rosalyntg/ultrasound/host/README.md

Standard test:
Water filled up to first line
Probed dipped to first seam, totally vertical
Highest Voltages
2MHz
26us ramp delay
76uS ramp rate
32k X scale
