rosalyntg/ultrasound/pcb/power-board/i_fb_R.png

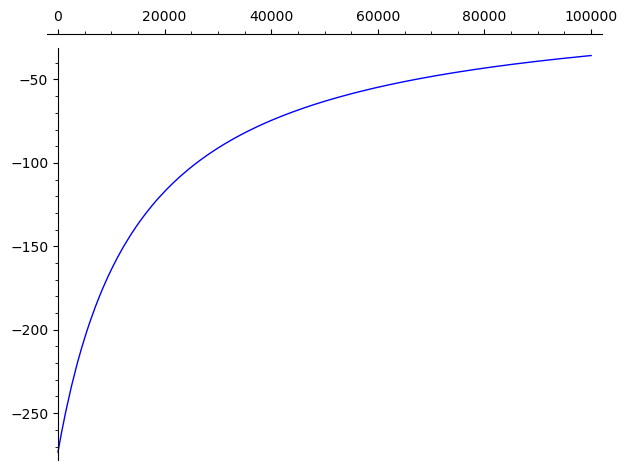
pcb/power-board/i_fb_R.png
