rosalyntg/ultrasound/pcb/power-board/R_V.png

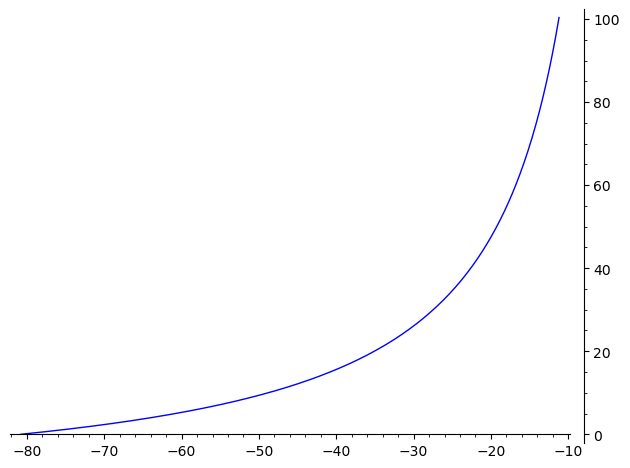
pcb/power-board/R_V.png
