rosalyntg/ultrasound/pcb/power-board/V_R.png

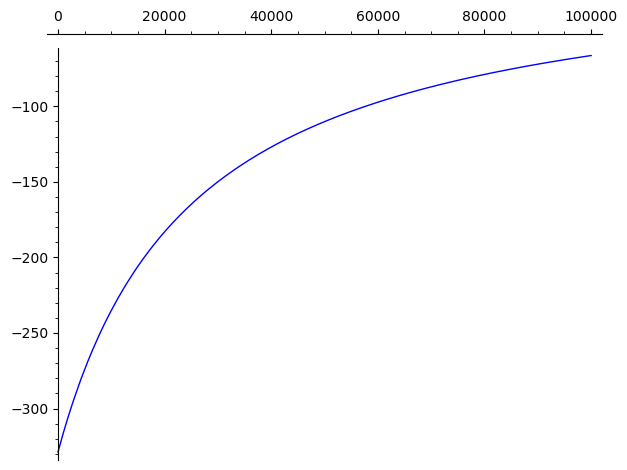
pcb/power-board/V_R.png
