rosalyntg/ultrasound/pcb/power-board/V_w_V.png

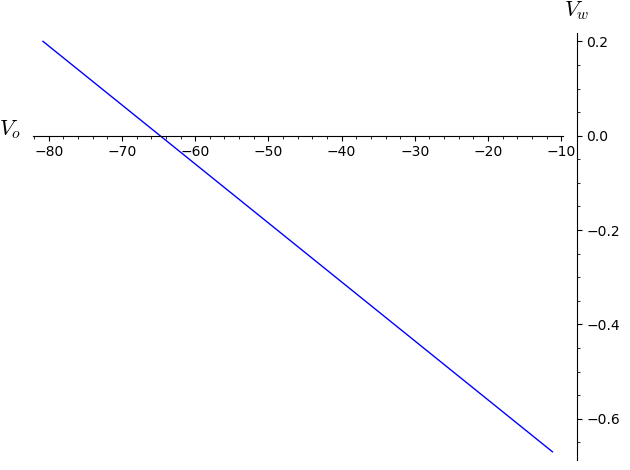
pcb/power-board/V_w_V.png
