rosalyntg/ultrasound/pcb/power-board/Vw_R.png

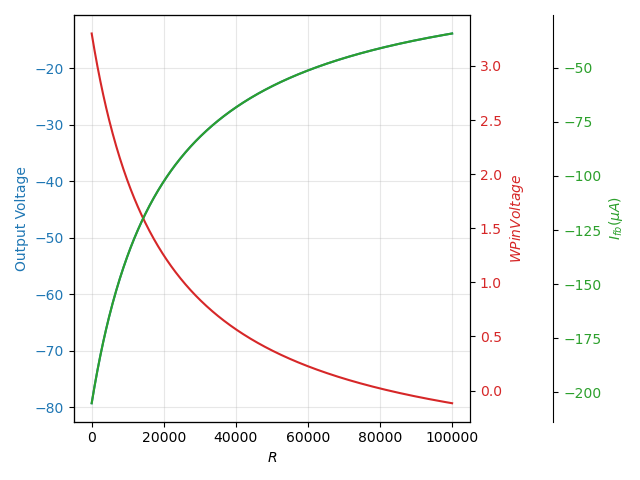
pcb/power-board/Vw_R.png
