rosalyntg/ultrasound/pcb/power-board/Vw_r_V.png

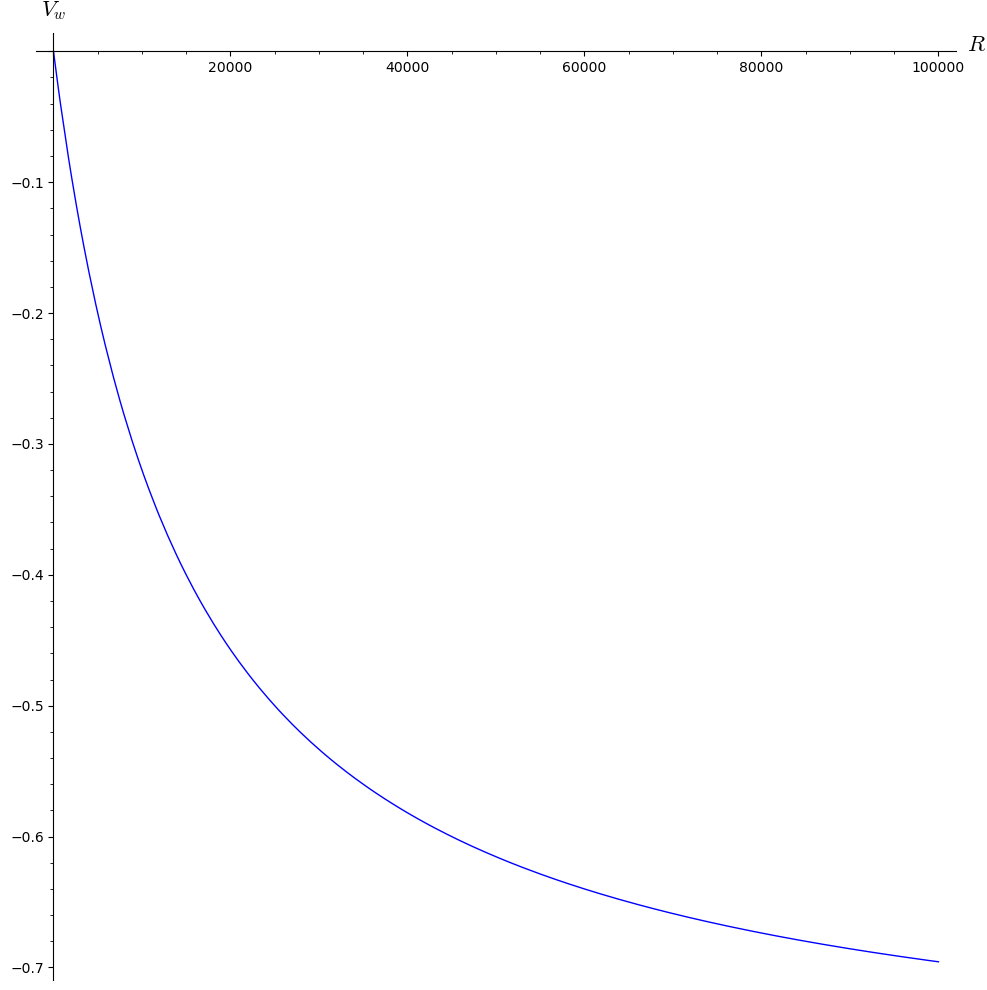
pcb/power-board/Vw_r_V.png
