rosalyntg/ultrasound/pcb/datasheets/ACAU15_IO_Length.xls

Sheet: BANK64
Name | Pin Number | Singals | Min Trace Delay (ps) | Max Trace Delay (ps) | Delay(mils) | Board Length(mils) | Total Length(mils)
B64_T0 | AF23 | IO_T0U_N12_VRP_64 | 132.268 | 133.597 | 768.3959538 | 756.36 | 1524.755954
B64_T1 | AF20 | IO_T1U_N12_64 | 127.425 | 128.706 | 740.2630058 | 790.53 | 1530.793006
B64_T2 | AE18 | IO_T2U_N12_64 | 125.588 | 126.851 | 729.5924855 | 799.54 | 1529.132486
B64_T3 | AC16 | IO_T3U_N12_64 | 130.105 | 131.413 | 755.8323699 | 784.52 | 1540.35237
B64_L1_N | AE26 | IO_L1N_T0L_N1_DBC_64 | 137.027 | 138.404 | 796.0433526 | 748.45 | 1544.493353
B64_L1_P | AE25 | IO_L1P_T0L_N0_DBC_64 | 136.67 | 138.043 | 793.9682081 | 751.07 | 1545.038208
B64_L2_N | AB26 | IO_L2N_T0L_N3_64 | 120.507 | 121.718 | 700.0722543 | 840.37 | 1540.442254
B64_L2_P | AB25 | IO_L2P_T0L_N2_64 | 119.317 | 120.516 | 693.1589595 | 846.16 | 1539.31896
B64_L3_N | AF25 | IO_L3N_T0L_N5_AD15N_64 | 142.349 | 143.78 | 826.9624277 | 707.62 | 1534.582428
B64_L3_P | AF24 | IO_L3P_T0L_N4_AD15P_64 | 141.029 | 142.447 | 819.2947977 | 715.01 | 1534.304798
B64_L4_N | AD26 | IO_L4N_T0U_N7_DBC_AD7N_64 | 119.021 | 120.217 | 691.4393064 | 844.96 | 1536.399306
B64_L4_P | AC26 | IO_L4P_T0U_N6_DBC_AD7P_64 | 118.754 | 119.947 | 689.8872832 | 847.56 | 1537.447283
B64_L5_N | AD25 | IO_L5N_T0U_N9_AD14N_64 | 137.596 | 138.979 | 799.349711 | 737.72 | 1537.069711
B64_L5_P | AD24 | IO_L5P_T0U_N8_AD14P_64 | 137.85 | 139.235 | 800.8236994 | 737.71 | 1538.533699
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
 |  | 64 | Y21 | IO_L19N_T3L_N1_DBC_AD9N_64 | 112.448 | 113.578 | 113.013 | 649.5
 |  | 64 | Y20 | IO_L19P_T3L_N0_DBC_AD9P_64 | 113.517 | 114.658 | 114.0875 | 655.6752874
 |  | 64 | AB19 | IO_L20N_T3L_N3_AD1N_64 | 103.937 | 104.982 | 104.4595 | 600.341954
 |  | 64 | AA19 | IO_L20P_T3L_N2_AD1P_64 | 104.717 | 105.77 | 105.2435 | 604.8477011
 |  | 64 | AB20 | IO_L21N_T3L_N5_AD8N_64 | 105.708 | 106.77 | 106.239 | 610.5689655
 |  | 64 | AA20 | IO_L21P_T3L_N4_AD8P_64 | 103.472 | 104.512 | 103.992 | 597.6551724
 |  | 64 | AC17 | IO_L22N_T3U_N7_DBC_AD0N_64 | 116.774 | 117.948 | 117.361 | 674.4885057
 |  | 64 | AB17 | IO_L22P_T3U_N6_DBC_AD0P_64 | 116.999 | 118.175 | 117.587 | 675.7873563
 |  | 64 | AA17 | IO_L23N_T3U_N9_64 | 113.33 | 114.469 | 113.8995 | 654.5948276
 |  | 64 | Y17 | IO_L23P_T3U_N8_64 | 112.781 | 113.914 | 113.3475 | 651.4224138
 |  | 64 | AA18 | IO_L24N_T3U_N11_64 | 113.426 | 114.566 | 113.996 | 655.1494253
 |  | 64 | Y18 | IO_L24P_T3U_N10_64 | 111.416 | 112.536 | 111.976 | 643.5402299

Sheet: BANK65
Name | Pin Number | Singals | Min Trace Delay (ps) | Max Trace Delay (ps) | Delay(mils) | Board Length(mils) | Total Length(mils)
B65_T0 | W21 | IO_T0U_N12_VRP_A28_65 | 88.856 | 89.749 | 516.199422 | 1434.17 | 1950.369422
B65_T1 | AA23 | IO_T1U_N12_SMBALERT_65 | 106.43 | 107.5 | 618.2947977 | 1346.07 | 1964.364798
B65_T2 | N26 | IO_T2U_N12_CSI_ADV_B_65 | 91.636 | 92.557 | 532.349711 | 1425.58 | 1957.929711
B65_T3 | T19 | IO_T3U_N12_PERSTN0_65 | 88.253 | 89.14 | 512.6965318 | 1430.24 | 1942.936532
B65_L1_N | V19 | IO_L1N_T0L_N1_DBC_RS1_65 | 80.282 | 81.089 | 466.3901734 | 1041.45 | 1507.840173
B65_L1_P | U19 | IO_L1P_T0L_N0_DBC_RS0_65 | 79.61 | 80.41 | 462.4855491 | 1045.3 | 1507.785549
B65_L2_N | U22 | IO_L2N_T0L_N3_FWE_FCS2_B_65 | 80.541 | 81.351 | 467.8959538 | 1040.59 | 1508.485954
B65_L2_P | U21 | IO_L2P_T0L_N2_FOE_B_65 | 67.937 | 68.62 | 394.6734104 | 1113.06 | 1507.73341
B65_L3_N | U20 | IO_L3N_T0L_N5_AD15N_A27_65 | 74.534 | 75.283 | 432.9971098 | 1072.6 | 1505.59711
B65_L3_P | T20 | IO_L3P_T0L_N4_AD15P_A26_65 | 76.164 | 76.93 | 442.4682081 | 1062.71 | 1505.178208
B65_L4_N | V22 | IO_L4N_T0U_N7_DBC_AD7N_A25_65 | 83.667 | 84.508 | 486.0549133 | 1022.67 | 1508.724913
B65_L4_P | V21 | IO_L4P_T0U_N6_DBC_AD7P_A24_65 | 83.747 | 84.589 | 486.5202312 | 1022.93 | 1509.450231
B65_L5_N | T23 | IO_L5N_T0U_N9_AD14N_A23_65 | 77.884 | 78.667 | 452.4595376 | 1039.52 | 1491.979538
B65_L5_P | T22 | IO_L5P_T0U_N8_AD14P_A22_65 | 74.703 | 75.454 | 433.9797688 | 1058.22 | 1492.199769
B65_L6_N | W20 | IO_L6N_T0U_N11_AD6N_A21_65 | 87.508 | 88.388 | 508.3699422 | 1004.87 | 1513.239942
B65_L6_P | W19 | IO_L6P_T0U_N10_AD6P_A20_65 | 94.153 | 95.099 | 546.9710983 | 965.02 | 1511.991098
B65_L7_N | Y23 | IO_L7N_T1L_N1_QBC_AD13N_A19_65 | 99.172 | 100.169 | 576.1300578 | 930.84 | 1506.970058
B65_L7_P | Y22 | IO_L7P_T1L_N0_QBC_AD13P_A18_65 | 98.734 | 99.726 | 573.583815 | 933.39 | 1506.973815
B65_L8_N | Y26 | IO_L8N_T1L_N3_AD5N_A17_65 | 109.053 | 110.149 | 633.5317919 | 878.43 | 1511.961792
B65_L8_P | Y25 | IO_L8P_T1L_N2_AD5P_A16_65 | 105.516 | 106.577 | 612.9855491 | 897.35 | 1510.335549
B65_L9_N | AA25 | IO_L9N_T1L_N5_AD12N_A15_D31_65 | 115.783 | 116.947 | 672.6300578 | 810.82 | 1483.450058
B65_L9_P | AA24 | IO_L9P_T1L_N4_AD12P_A14_D30_65 | 113.135 | 114.272 | 657.2456647 | 827.21 | 1484.455665
B65_L10_N | W26 | IO_L10N_T1U_N7_QBC_AD4N_A13_D29_65 | 106.483 | 107.553 | 618.6011561 | 887.68 | 1506.281156
B65_L10_P | W25 | IO_L10P_T1U_N6_QBC_AD4P_A12_D28_65 | 107.164 | 108.241 | 622.5578035 | 883.16 | 1505.717803
B65_L11_N | W23 | IO_L11N_T1U_N9_GC_A11_D27_65 | 94.681 | 95.633 | 550.0404624 | 963.94 | 1513.980462
B65_L11_P | V23 | IO_L11P_T1U_N8_GC_A10_D26_65 | 94.421 | 95.37 | 548.5289017 | 964.69 | 1513.218902
B65_L12_N | W24 | IO_L12N_T1U_N11_GC_A09_D25_65 | 94.602 | 95.553 | 549.5809249 | 925.6 | 1475.180925
B65_L12_P | V24 | IO_L12P_T1U_N10_GC_A08_D24_65 | 94.727 | 95.679 | 550.3063584 | 924.6 | 1474.906358
B65_L14_N | U25 | IO_L14N_T2L_N3_GC_A05_D21_65 | 91.56 | 92.481 | 531.9104046 | 978.07 | 1509.980405
B65_L14_P | T25 | IO_L14P_T2L_N2_GC_A04_D20_65 | 91.722 | 92.644 | 532.849711 | 975.56 | 1508.409711
B65_L15_N | P24 | IO_L15N_T2L_N5_AD11N_A03_D19_65 | 85.033 | 85.887 | 493.9884393 | 1011.97 | 1505.958439
B65_L15_P | N24 | IO_L15P_T2L_N4_AD11P_A02_D18_65 | 86.546 | 87.416 | 502.7803468 | 1002.77 | 1505.550347
B65_L16_N | V26 | IO_L16N_T2U_N7_QBC_AD3N_A01_D17_65 | 102.182 | 103.209 | 593.6156069 | 916.99 | 1510.605607
B65_L16_P | U26 | IO_L16P_T2U_N6_QBC_AD3P_A00_D16_65 | 102.642 | 103.674 | 596.2890173 | 913.53 | 1509.819017
B65_L17_N | P26 | IO_L17N_T2U_N9_AD10N_D15_65 | 99.311 | 100.309 | 576.9364162 | 931.94 | 1508.876416
B65_L17_P | P25 | IO_L17P_T2U_N8_AD10P_D14_65 | 89.003 | 89.897 | 517.0520231 | 990.99 | 1508.042023
B65_L18_N | R26 | IO_L18N_T2U_N11_AD2N_D13_65 | 93.035 | 93.97 | 540.4768786 | 967.74 | 1508.216879
B65_L18_P | R25 | IO_L18P_T2U_N10_AD2P_D12_65 | 87.173 | 88.049 | 506.4219653 | 1001.21 | 1507.631965
B65_L19_N | R23 | IO_L19N_T3L_N1_DBC_AD9N_D11_65 | 93.967 | 94.912 | 545.8930636 | 963.45 | 1509.343064
B65_L19_P | R22 | IO_L19P_T3L_N0_DBC_AD9P_D10_65 | 94.354 | 95.303 | 548.1416185 | 962.39 | 1510.531618
B65_L20_N | P21 | IO_L20N_T3L_N3_AD1N_D09_65 | 82.292 | 83.119 | 478.066474 | 1027.91 | 1505.976474
B65_L20_P | P20 | IO_L20P_T3L_N2_AD1P_D08_65 | 95.119 | 96.075 | 552.583815 | 955.44 | 1508.023815
B65_L21_N | R21 | IO_L21N_T3L_N5_AD8N_D07_65 | 104.393 | 105.442 | 606.4595376 | 901.61 | 1508.069538
B65_L21_P | R20 | IO_L21P_T3L_N4_AD8P_D06_65 | 105.605 | 106.666 | 613.5 | 894.14 | 1507.64
B65_L22_N | P23 | IO_L22N_T3U_N7_DBC_AD0N_D05_65 | 90.059 | 90.965 | 523.1907514 | 987.33 | 1510.520751
B65_L22_P | N23 | IO_L22P_T3U_N6_DBC_AD0P_D04_65 | 89.072 | 89.967 | 517.4537572 | 991.57 | 1509.023757
B65_L23_N | P19 | IO_L23N_T3U_N9_PERSTN1_I2C_SDA_65 | 96.032 | 96.998 | 557.8901734 | 948.43 | 1506.320173
B65_L23_P | N19 | IO_L23P_T3U_N8_I2C_SCLK_65 | 93.608 | 94.549 | 543.8063584 | 963.69 | 1507.496358
B65_L24_N | N22 | IO_L24N_T3U_N11_DOUT_CSO_B_65 | 86.917 | 87.79 | 504.933526 | 1009.59 | 1514.523526
B65_L24_P | N21 | IO_L24P_T3U_N10_EMCCLK_65 | 99.92 | 100.924 | 580.4739884 | 935.38 | 1515.853988

Sheet: BANK84_85_86
Name | Pin Number | Singals | Min Trace Delay (ps) | Max Trace Delay (ps) | Delay(mils) | Board Length(mils) | Total Length(mils)
B84_L1_N | AF15 | IO_L1N_AD11N_84 | 99.43 | 100.429 | 577.6271676 | 2034.93 | 2612.557168
B84_L1_P | AF14 | IO_L1P_AD11P_84 | 97.917 | 98.901 | 568.8381503 | 2043.19 | 2612.02815
B84_L2_N | AF13 | IO_L2N_AD10N_84 | 105.981 | 107.046 | 615.6849711 | 1991.07 | 2606.754971
B84_L2_P | AE13 | IO_L2P_AD10P_84 | 101.05 | 102.066 | 587.0404624 | 2019.44 | 2606.480462
B84_L3_N | AE15 | IO_L3N_AD9N_84 | 100.429 | 101.438 | 583.4306358 | 2028.87 | 2612.300636
B84_L3_P | AD15 | IO_L3P_AD9P_84 | 91.85 | 92.773 | 533.5924855 | 2078.15 | 2611.742486
B84_L4_N | AD14 | IO_L4N_AD8N_84 | 94.869 | 95.823 | 551.132948 | 2061.51 | 2612.642948
B84_L4_P | AD13 | IO_L4P_AD8P_84 | 94.385 | 95.334 | 548.3208092 | 2065.98 | 2614.300809
B84_L5_N | AC14 | IO_L5N_HDGC_AD7N_84 | 88.98 | 89.874 | 516.9190751 | 2104.23 | 2621.149075
B84_L5_P | AC13 | IO_L5P_HDGC_AD7P_84 | 88.546 | 89.436 | 514.3988439 | 2106.3 | 2620.698844
B84_L6_N | AB16 | IO_L6N_HDGC_AD6N_84 | 97.352 | 98.331 | 565.5578035 | 2040.74 | 2606.297803
B84_L6_P | AB15 | IO_L6P_HDGC_AD6P_84 | 96.84 | 97.813 | 562.5809249 | 2043.54 | 2606.120925
B84_L7_N | AA15 | IO_L7N_HDGC_AD5N_84 | 83.255 | 84.092 | 483.6618497 | 2119.76 | 2603.42185
B84_L7_P | Y15 | IO_L7P_HDGC_AD5P_84 | 83.14 | 83.975 | 482.9913295 | 2120.4 | 2603.391329
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
B86_L7_P | E13 | IO_L7P_HDGC_AD5P_86 | 96.638 | 97.61 | 561.4104046 | 1606.91 | 2168.320405
B86_L8_N | D13 | IO_L8N_HDGC_AD4N_86 | 94.613 | 95.564 | 549.6445087 | 1636.81 | 2186.454509
B86_L8_P | D14 | IO_L8P_HDGC_AD4P_86 | 95.02 | 95.975 | 552.0086705 | 1634.59 | 2186.598671
B86_L9_N | C13 | IO_L9N_AD3N_86 | 94.365 | 95.313 | 548.2023121 | 1649.26 | 2197.462312
B86_L9_P | C14 | IO_L9P_AD3P_86 | 90.241 | 91.148 | 524.2456647 | 1671.66 | 2195.905665
B86_L10_N | B12 | IO_L10N_AD2N_86 | 99.842 | 100.845 | 580.0202312 | 1604.49 | 2184.510231
B86_L10_P | C12 | IO_L10P_AD2P_86 | 96.366 | 97.335 | 559.8294798 | 1624.99 | 2184.81948
B86_L11_N | A12 | IO_L11N_AD1N_86 | 109.437 | 110.537 | 635.7630058 | 1552.11 | 2187.873006
B86_L11_P | A13 | IO_L11P_AD1P_86 | 106.494 | 107.564 | 618.6647399 | 1569.01 | 2187.67474
B86_L12_N | A14 | IO_L12N_AD0N_86 | 100.215 | 101.222 | 582.1878613 | 1613.93 | 2196.117861
B86_L12_P | B14 | IO_L12P_AD0P_86 | 97.426 | 98.405 | 565.9855491 | 1629.21 | 2195.195549

Sheet: BANK224_225_226
Name | Pin Number | Singals | Min Trace Delay (ps) | Max Trace Delay (ps) | Delay(mils) | Board Length(mils) | Total Length(mils)
224_CLK0_N | AB6 | MGTREFCLK0N_224 | 81.043 | 81.858 | 470.8121387 | 916.16 | 1386.972139
224_CLK0_P | AB7 | MGTREFCLK0P_224 | 81.06 | 81.874 | 470.9075145 | 917.14 | 1388.047514
 |  |  |  |  | 0
224_RX0_N | AF1 | MGTHRXN0_224 | 126.105 | 127.372 | 732.5924855 | 662.93 | 1395.522486
224_RX0_P | AF2 | MGTHRXP0_224 | 126.025 | 127.291 | 732.1271676 | 664.36 | 1396.487168
 |  |  |  |  | 0
224_RX1_N | AE3 | MGTHRXN1_224 | 112.482 | 113.612 | 653.4508671 | 715.29 | 1368.740867
224_RX1_P | AE4 | MGTHRXP1_224 | 112.402 | 113.532 | 652.9884393 | 717 | 1369.988439
 |  |  |  |  | 0
224_RX2_N | AD1 | MGTHRXN2_224 | 116.054 | 117.221 | 674.2052023 | 681.07 | 1355.275202
224_RX2_P | AD2 | MGTHRXP2_224 | 115.974 | 117.139 | 673.7369942 | 682.53 | 1356.266994
 |  |  |  |  | 0
224_RX3_N | AB1 | MGTHRXN3_224 | 107.847 | 108.931 | 626.5260116 | 660.34 | 1286.866012
224_RX3_P | AB2 | MGTHRXP3_224 | 107.766 | 108.85 | 626.0578035 | 661.82 | 1287.877803
 |  |  |  |  | 0
224_TX0_N | AF6 | MGTHTXN0_224 | 107.602 | 108.683 | 625.1011561 | 796.01 | 1421.111156
224_TX0_P | AF7 | MGTHTXP0_224 | 107.521 | 108.601 | 624.6300578 | 796.9 | 1421.530058
 |  |  |  |  | 0
224_TX1_N | AE8 | MGTHTXN1_224 | 89.649 | 90.55 | 520.8063584 | 854.4 | 1375.206358
224_TX1_P | AE9 | MGTHTXP1_224 | 89.703 | 90.605 | 521.1213873 | 855.34 | 1376.461387
 |  |  |  |  | 0
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
226_TX2_P | J5 | MGTHTXP2_226 | 62.951 | 63.584 | 365.7080925 | 666.72 | 1032.428092
 |  |  |  |  | 0 |  | 0
226_TX3_N | G4 | MGTHTXN3_226 | 65.718 | 66.378 | 381.7803468 | 549.36 | 931.1403468
226_TX3_P | G5 | MGTHTXP3_226 | 65.703 | 66.363 | 381.6936416 | 550.23 | 931.9236416
