rosalyntg/ultrasound/host/calibration.csv

# element calibration | one row per pulser channel (calibration.py)
# t0_s=1.499999e-06
# c_m_s=1482.0
# x_m | z_m | tau_s | sign
0.000000e+00 | 0.000000e+00 | 0.000000e+00 | 1
6.441796e-04 | 8.954894e-05 | 1.883347e-08 | -1
-1.057300e-03 | 2.165458e-04 | 2.088043e-07 | 1
-4.058558e-04 | 8.938831e-05 | 8.411684e-08 | -1
-1.989306e-03 | 2.548419e-04 | 3.007949e-07 | 1
-1.495747e-03 | 2.773587e-04 | 2.787233e-07 | -1
7.288245e-03 | -1.951969e-04 | -1.536409e-07 | 1
8.141255e-03 | 5.223752e-04 | 3.110836e-07 | -1
