rosalyntg/ultrasound/pcb/simulations/analog-frontend-nobalun.asc

&adc: fraprobe
&LNA: fraprobe
&vga: fraprobe
@1: fra; delay=10u fstart=10e3 fend=100e6 oct=3 pp0=10m pp1=10m f0=1 f1=1e9 tavgmin=10u tsettle=1u
C1: cap; 100n
C2: cap; 18n
C3: cap; 100n
C4: cap; 100n
C5: cap; 100n
C6: cap; 100n
C7: cap; 100n
C8: cap; 22p
C12: cap; 0.1µ
C13: cap; 0.1µ
C14: cap; 18p
R1: res; 50
R2: res; 280
R3: res; 8.25k
R4: res; 50
R5: res; 374
R7: res; 187
R8: res; 187
R11: res; 25
R12: res; 25
U1: AD8331LNA
U2: AD8331VGA
V1: voltage; SINE(0 100m 1e6); AC 1
V2: voltage; 5V
V3: voltage; PULSE(0 1 0 100u)
V4: voltage; 0.95
V5: voltage; 0.4
Named nets: 0, 5V, LOP, LON, IN, VOH, VOL, VIP, VIN, ADCP, ADCN, BINH, BINL, VO1H, VO1L
.ac dec 100 1 100e6
.tran 120u
.fra
