rosalyntg/ultrasound/pcb/simulations/analog-frontend.asc

&BALUN: fraprobe
&LNA: fraprobe
&vga: fraprobe
@1: fra; delay=10u fstart=10e3 fend=100e6 oct=3 pp0=.1m pp1=.1m f0=1 f1=1e9 tavgmin=10u tsettle=1u
C1: cap; 100n
C2: cap; 18n
C3: cap; 100n
C4: cap; 100n
C5: cap; 100n
C6: cap; 100n
C7: cap; 100n
C8: cap; 22p
C9: cap; 100n
C10: cap; 100n
C11: cap; 22p
L1: ind; 2µ; Rser=1m
L2: ind; 1µ; Rser=1m
L3: ind; 1µ; Rser=1m
L4: ind; 39µ; Rser=1m
L5: ind; 39µ; Rser=1m
R1: res; 50
R2: res; 280
R3: res; 8.25k
R4: res; 50
R5: res; 50
R6: res; 50
U1: AD8331LNA
U2: AD8331VGA
V1: voltage; SINE(0 100m 1e6); AC 1
V2: voltage; 5V
V3: voltage; PULSE(0 .7 0 100u)
V4: voltage; 0.95
V5: voltage; 1V
Named nets: 0, 5V, LOP, LON, IN, VOH, VOL, VIP, VIN, ADCP, ADCN
.ac dec 100 1 100e6
.tran .2m
K L1 L2 L3 0.99
.fra
