rosalyntg/ultrasound/pcb/simulations/gain-filter-current-dac.asc

C1: cap; 10n
C2: cap; 3n
C3: cap; 10n
M1: nmos; Si4542DY_N
M2: nmos; IPP08CN10L
M3: nmos; IPP08CN10L
R1: res; 2k
R2: res; 200
R4: res; 10
R5: res; 2k
U2: UniversalOpAmp5
V1: voltage; PULSE(0 1 0 1n 1n 2)
V2: voltage; PULSE(0 30 10u 1u 1u 10u 50u 10)
V3: voltage; 0V
V4: voltage; 3.3
Named nets: 0, OUT, GATE, DRAIN, OP+, OPIN-, OPIN+
.tran 220u
.lib opamp.sub
.ic V(OUT)=0
