rosalyntg/ultrasound/pcb/simulations/gain-filter.asc

C1: cap; 20n
C2: cap; 1n
C3: cap; 1n
C4: cap; 1n
C5: cap; 1n
R2: res; 220
R81: res; 440
V1: voltage; PWL file=gain-filter-input-waveform.pwl; AC 3.3
Named nets: 0, GAIN, GAIN_DAC
.ac dec 50 1 1Meg
.tran 120u
.lib library/DAC7311_PAR.lib
