rosalyntg/ultrasound/pcb/simulations/gain-ramp-summing.asc

C1: cap; 3n
C2: cap; 4n
D1: diode; 1N914
D2: diode; 1N914
D3: diode; 1N914
M1: nmos; BS170
R1: res; 10k
R2: res; 200
R: res; 470
U2: MAX74822
V1: voltage; 1.25
V2: voltage; PULSE(3.3 0 5u 100n 100n 50u 100u 100)
V3: voltage; 3.3
Named nets: 0, GAIN, INT, GATE, AMP+
.tran 200u
.lib opamp.sub
.ic V(GAIN)=0 V(INT)=0
