rosalyntg/ultrasound/pcb/simulations/hv.asc

C1: cap; 200n
C2: cap; 1nF
C3: cap; 1µ
C4: cap; 100n
C5: cap; 220n
C6: cap; 200n
C7: cap; 10µ
C8: cap; 10µ
D1: schottky; DI_DFLS1150
D2: schottky; DI_DFLS1150
D3: schottky; DI_DFLS1150
L1: ind; 10µ; Rser=1m
M1: nmos; BSB012N03LX3
R1: res; 107k
R2: res; 85.4k
R3: res; 20
R4: res; 680k
R5: res; 15k
R6: res; 50
R7: res; 1k
U1: LT8365
V1: voltage; 12
V2: voltage; PULSE(0V 50V 40m 0 0 3u 100u 10000)
Named nets: 0, HV, FBX, VIN, SW, D2CAT
.inc library/DFLS1150.spice.txt
.tran 200m
.ic V(HV)=80
