rosalyntg/ultrasound/pcb/simulations/led-drive-fet.asc

D2: LED; LTST-C171KRKT
M1: nmos; BS170
R1: res; 68
V1: voltage; 3.3
Named nets: 0
.tran 1m
.lib led_sim/LTST-C171KRKT.lib
