rosalyntg/ultrasound/pcb/probe/probe.kicad_pcb

## KiCad design pcb/probe/probe.kicad_pcb (2026-09-27)

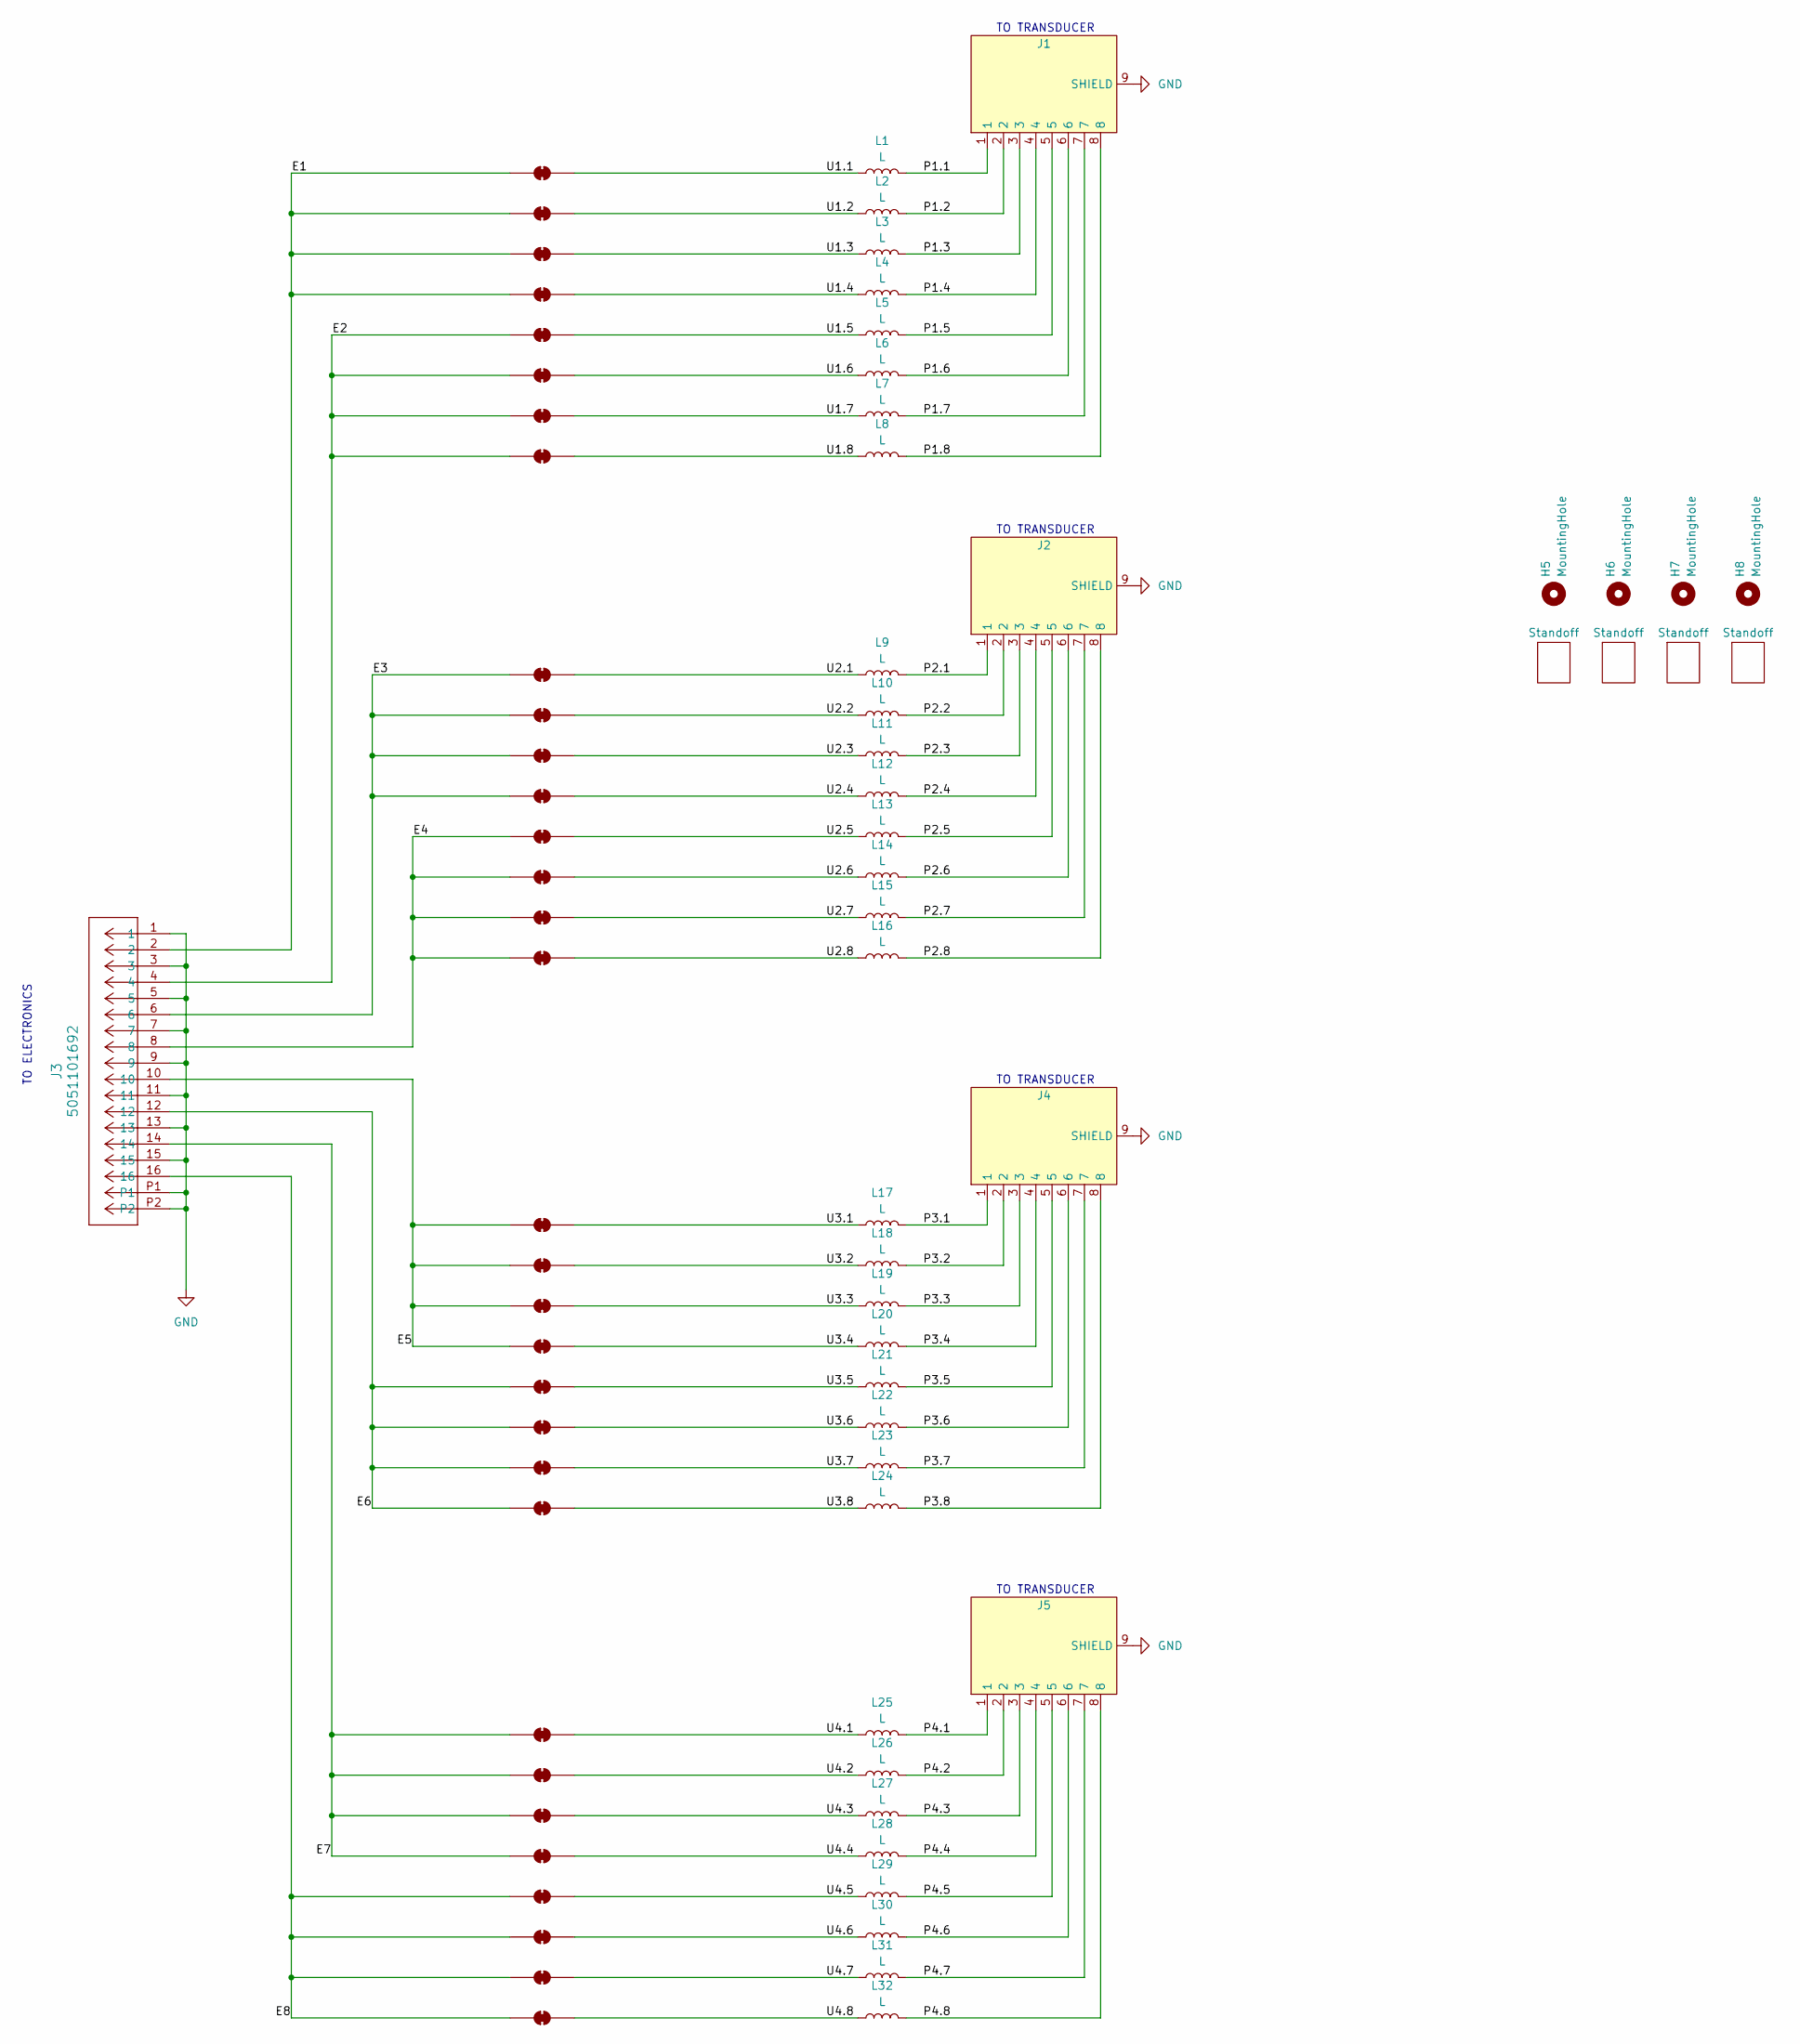
[picture p10: schematic probe.kicad_sch, Probe Breakout]

Parts:
H5, H6, H7, H8: MountingHole; MountingHole_3.2mm_M3
J1, J2, J4, J5: UCOAX
J3: 5051101692; CON_5051101692_MOL; Manufacturer Part Number 5051101692; Digikey Part Number WM12372CT-ND
JP2, JP3, JP4, JP5, JP6, JP7, JP8, JP9, JP10, JP11, JP12, JP13, JP14, JP15, JP16, JP17, JP18, JP19, JP20, JP21, JP22, JP23, JP24, JP25, JP26, JP27, JP28, JP29, JP30, JP31, JP32, JP33: SolderJumper_2_Bridged; SolderJumper-2_P1.3mm_Bridged_RoundedPad1.0x1.5mm
L1, L2, L3, L4, L5, L6, L7, L8, L9, L10, L11, L12, L13, L14, L15, L16, L17, L18, L19, L20, L21, L22, L23, L24, L25, L26, L27, L28, L29, L30, L31, L32: L; PROBE_INDUCTOR
Z8, Z9, Z10, Z11: Standoff; Manufacturer_Part_Number 24438; DigiKey Part Number 36-24438-ND

Connections:
/E1: J3.2, JP2.1 (A), JP3.1 (A), JP4.1 (A), JP5.1 (A)
/E2: J3.4, JP6.1 (A), JP7.1 (A), JP8.1 (A), JP9.1 (A)
/E3: J3.6, JP10.1 (A), JP11.1 (A), JP12.1 (A), JP13.1 (A)
/E4: J3.8, JP14.1 (A), JP15.1 (A), JP16.1 (A), JP17.1 (A)
/E5: J3.10, JP18.1 (A), JP19.1 (A), JP20.1 (A), JP21.1 (A)
/E6: J3.12, JP22.1 (A), JP23.1 (A), JP24.1 (A), JP25.1 (A)
/E7: J3.14, JP26.1 (A), JP27.1 (A), JP28.1 (A), JP29.1 (A)
/E8: J3.16, JP30.1 (A), JP31.1 (A), JP32.1 (A), JP33.1 (A)
/P1.1: J1.1, L1.2
/P1.2: J1.2, L2.2
/P1.3: J1.3, L3.2
/P1.4: J1.4, L4.2
/P1.5: J1.5, L5.2
/P1.6: J1.6, L6.2
/P1.7: J1.7, L7.2
/P1.8: J1.8, L8.2
/P2.1: J2.1, L9.2
/P2.2: J2.2, L10.2
/P2.3: J2.3, L11.2
/P2.4: J2.4, L12.2
/P2.5: J2.5, L13.2
/P2.6: J2.6, L14.2
/P2.7: J2.7, L15.2
/P2.8: J2.8, L16.2
/P3.1: J4.1, L17.2
/P3.2: J4.2, L18.2
/P3.3: J4.3, L19.2
/P3.4: J4.4, L20.2
/P3.5: J4.5, L21.2
/P3.6: J4.6, L22.2
/P3.7: J4.7, L23.2
/P3.8: J4.8, L24.2
/P4.1: J5.1, L25.2
/P4.2: J5.2, L26.2
/P4.3: J5.3, L27.2
/P4.4: J5.4, L28.2
/P4.5: J5.5, L29.2
/P4.6: J5.6, L30.2
/P4.7: J5.7, L31.2
/P4.8: J5.8, L32.2
/U1.1: JP2.2 (B), L1.1
/U1.2: JP3.2 (B), L2.1
/U1.3: JP4.2 (B), L3.1
/U1.4: JP5.2 (B), L4.1
/U1.5: JP6.2 (B), L5.1
/U1.6: JP7.2 (B), L6.1
/U1.7: JP8.2 (B), L7.1
/U1.8: JP9.2 (B), L8.1
/U2.1: JP10.2 (B), L9.1
/U2.2: JP11.2 (B), L10.1
/U2.3: JP12.2 (B), L11.1
/U2.4: JP13.2 (B), L12.1
/U2.5: JP14.2 (B), L13.1
/U2.6: JP15.2 (B), L14.1
/U2.7: JP16.2 (B), L15.1
/U2.8: JP17.2 (B), L16.1
/U3.1: JP18.2 (B), L17.1
/U3.2: JP19.2 (B), L18.1
/U3.3: JP20.2 (B), L19.1
/U3.4: JP21.2 (B), L20.1
/U3.5: JP22.2 (B), L21.1
/U3.6: JP23.2 (B), L22.1
/U3.7: JP24.2 (B), L23.1
/U3.8: JP25.2 (B), L24.1
/U4.1: JP26.2 (B), L25.1
/U4.2: JP27.2 (B), L26.1
/U4.3: JP28.2 (B), L27.1
/U4.4: JP29.2 (B), L28.1
/U4.5: JP30.2 (B), L29.1
/U4.6: JP31.2 (B), L30.1
/U4.7: JP32.2 (B), L31.1
/U4.8: JP33.2 (B), L32.1
GND: J1.9 (SHIELD), J2.9 (SHIELD), J3.1, J3.3, J3.5, J3.7, J3.9, J3.11, J3.13, J3.15, J3.P1, J3.P2, J4.9 (SHIELD), J5.9 (SHIELD)

Notes on the sheet:
TO ELECTRONICS
TO TRANSDUCER

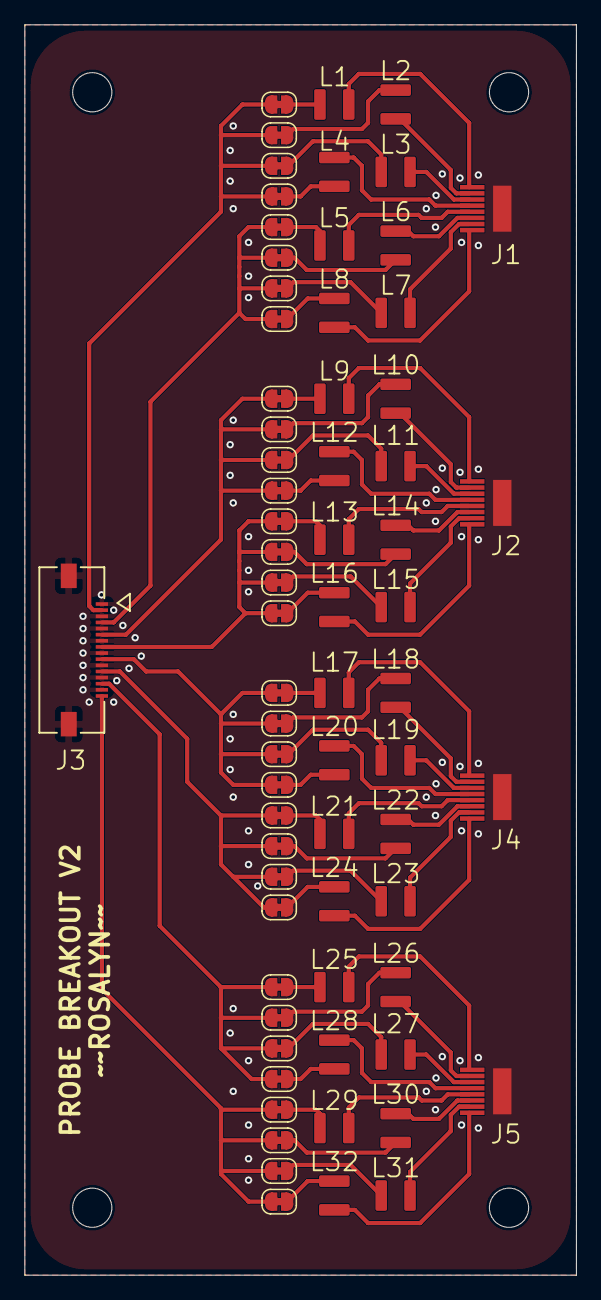
[picture p11: board probe.kicad_pcb from above]

Board: 2 copper layers, 45.0 x 102.0 mm, 73 parts (0 on the bottom side), 73 nets.
