rosalyntg/ultrasound/pcb/power-board/power-board.kicad_pcb

## KiCad design pcb/power-board/power-board.kicad_pcb (2026-09-27)

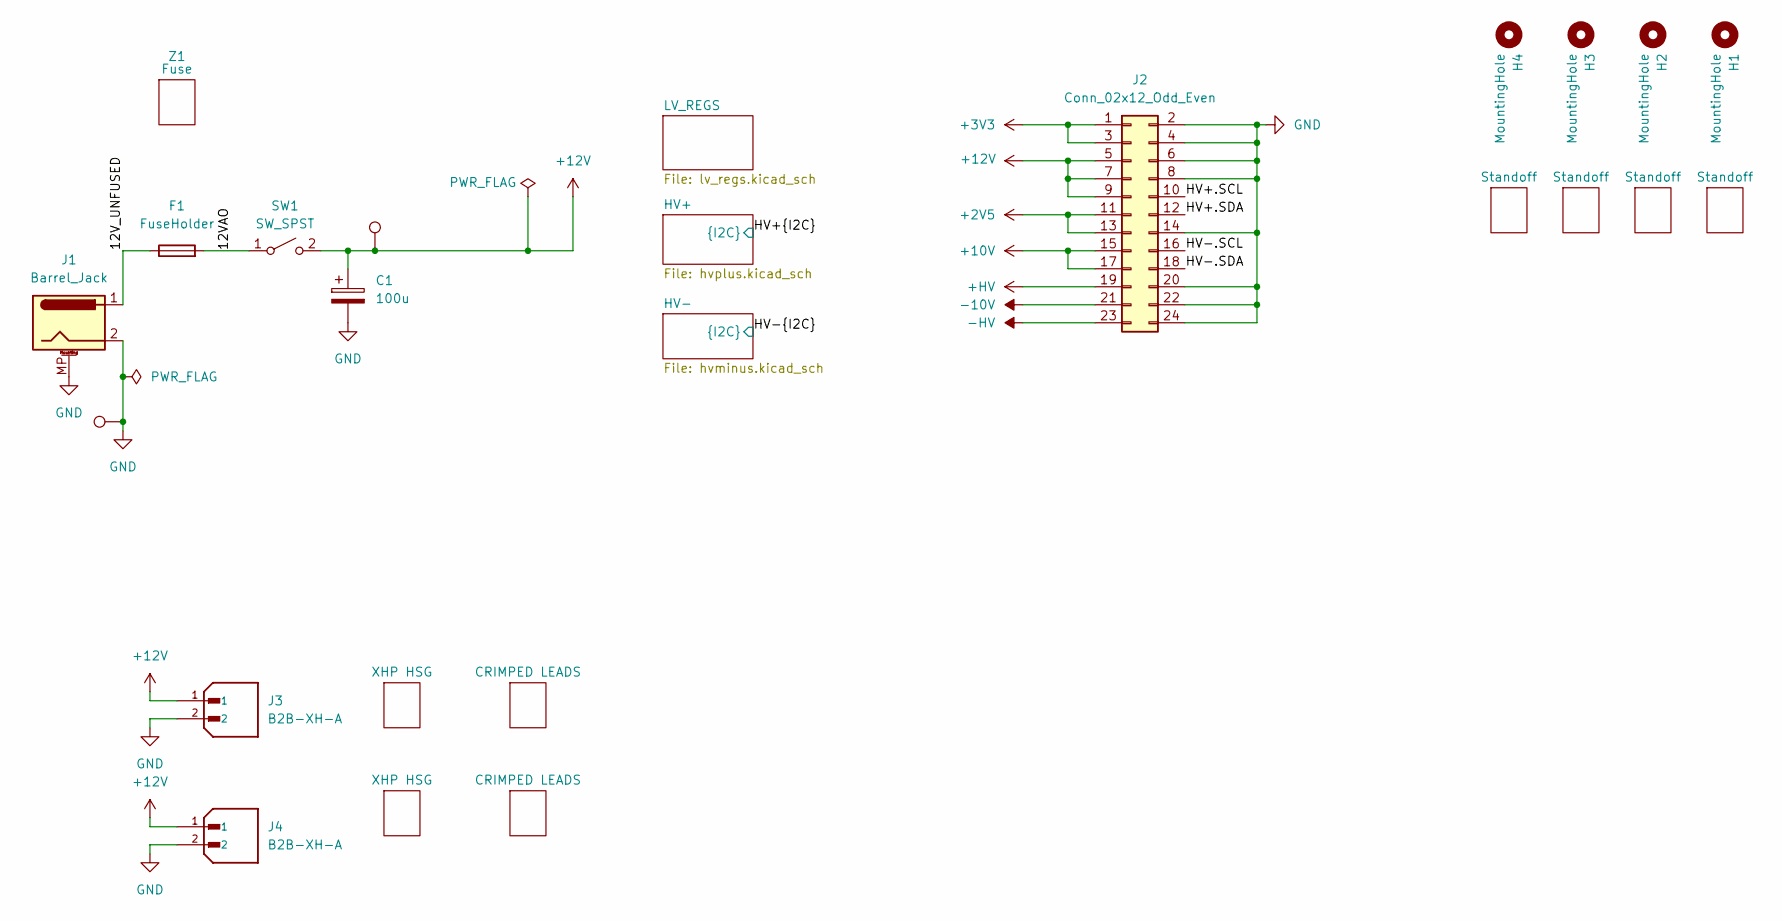
[picture p12: schematic power-board.kicad_sch, Ultrasound Power]

Parts:
C1: 100u; CP_Radial_D5.0mm_P2.00mm; Voltage Rating 16V; Manufacturer_Part_Number 860010372006; DigiKey Part Number 732-8598-3-ND
F1: FuseHolder; Fuseholder_Blade_Mini_Keystone_3568; Manufacturer_Part_Number 3568; DigiKey Part Number 36-3568-ND
H1, H2, H3, H4: MountingHole; MountingHole_3.2mm_M3
J1: Barrel_Jack; BarrelJack_CUI_PJ-063AH_Horizontal; Manufacturer_Part_Number PJ-063AH; DigiKey Part Number CP-063AH-ND
J2: Conn_02x12_Odd_Even; PinSocket_2x12_P2.54mm_Horizontal; Manufacturer_Part_Number PPPC122LJBN-RC; DigiKey Part Number S5565-ND
J3, J4: B2B-XH-A; JST_XH_B2B-XH-AM_1x02_P2.50mm_Vertical; Manufacturer_Part_Number B2B-XH-A; DigiKey Part Number 455-B2B-XH-A-ND
SW1: SW_SPST; CK_L101011; Manufacturer_Part_Number L101011MS02Q; DigiKey Part Number CKC5106-ND
TP1, TP2: TestPoint; TestPoint_THTPad_2.5x2.5mm_Drill1.2mm
Z1: Fuse; Manufacturer_Part_Number 0297005.WXNV; DigiKey Part Number F989-ND
Z8, Z9, Z10, Z11: Standoff; Manufacturer_Part_Number 24438; DigiKey Part Number 36-24438-ND
Z12, Z13: XHP HSG; Manufacturer_Part_Number XHP-2; DigiKey Part Number 455-2266-ND
Z14, Z15: CRIMPED LEADS; Manufacturer_Part_Number ASXHSXH22K305; DigiKey Part Number 455-3241-ND

Connections:
+2V5: J2.11, J2.13; also elsewhere on the board
+3V3: J2.1, J2.3; also elsewhere on the board
+10V: J2.15, J2.17; also elsewhere on the board
+12V: C1.1, J2.5, J2.7, J2.9, J3.1, J4.1, SW1.2 (B), TP2.1 (1_1); also elsewhere on the board
+HV: J2.19; also elsewhere on the board
-10V: J2.21; also elsewhere on the board
-HV: J2.23; also elsewhere on the board
/12VAO: F1.2, SW1.1 (A)
/12V_UNFUSED: F1.1, J1.1
/HV+.SCL: J2.10; also elsewhere on the board
/HV+.SDA: J2.12; also elsewhere on the board
/HV-.SCL: J2.16; also elsewhere on the board
/HV-.SDA: J2.18; also elsewhere on the board
GND: C1.2, J1.2, J1.MP (MountPin_MP), J2.2, J2.4, J2.6, J2.8, J2.14, J2.20, J2.22, J2.24, J3.2, J4.2, TP1.1 (1_1); also elsewhere on the board

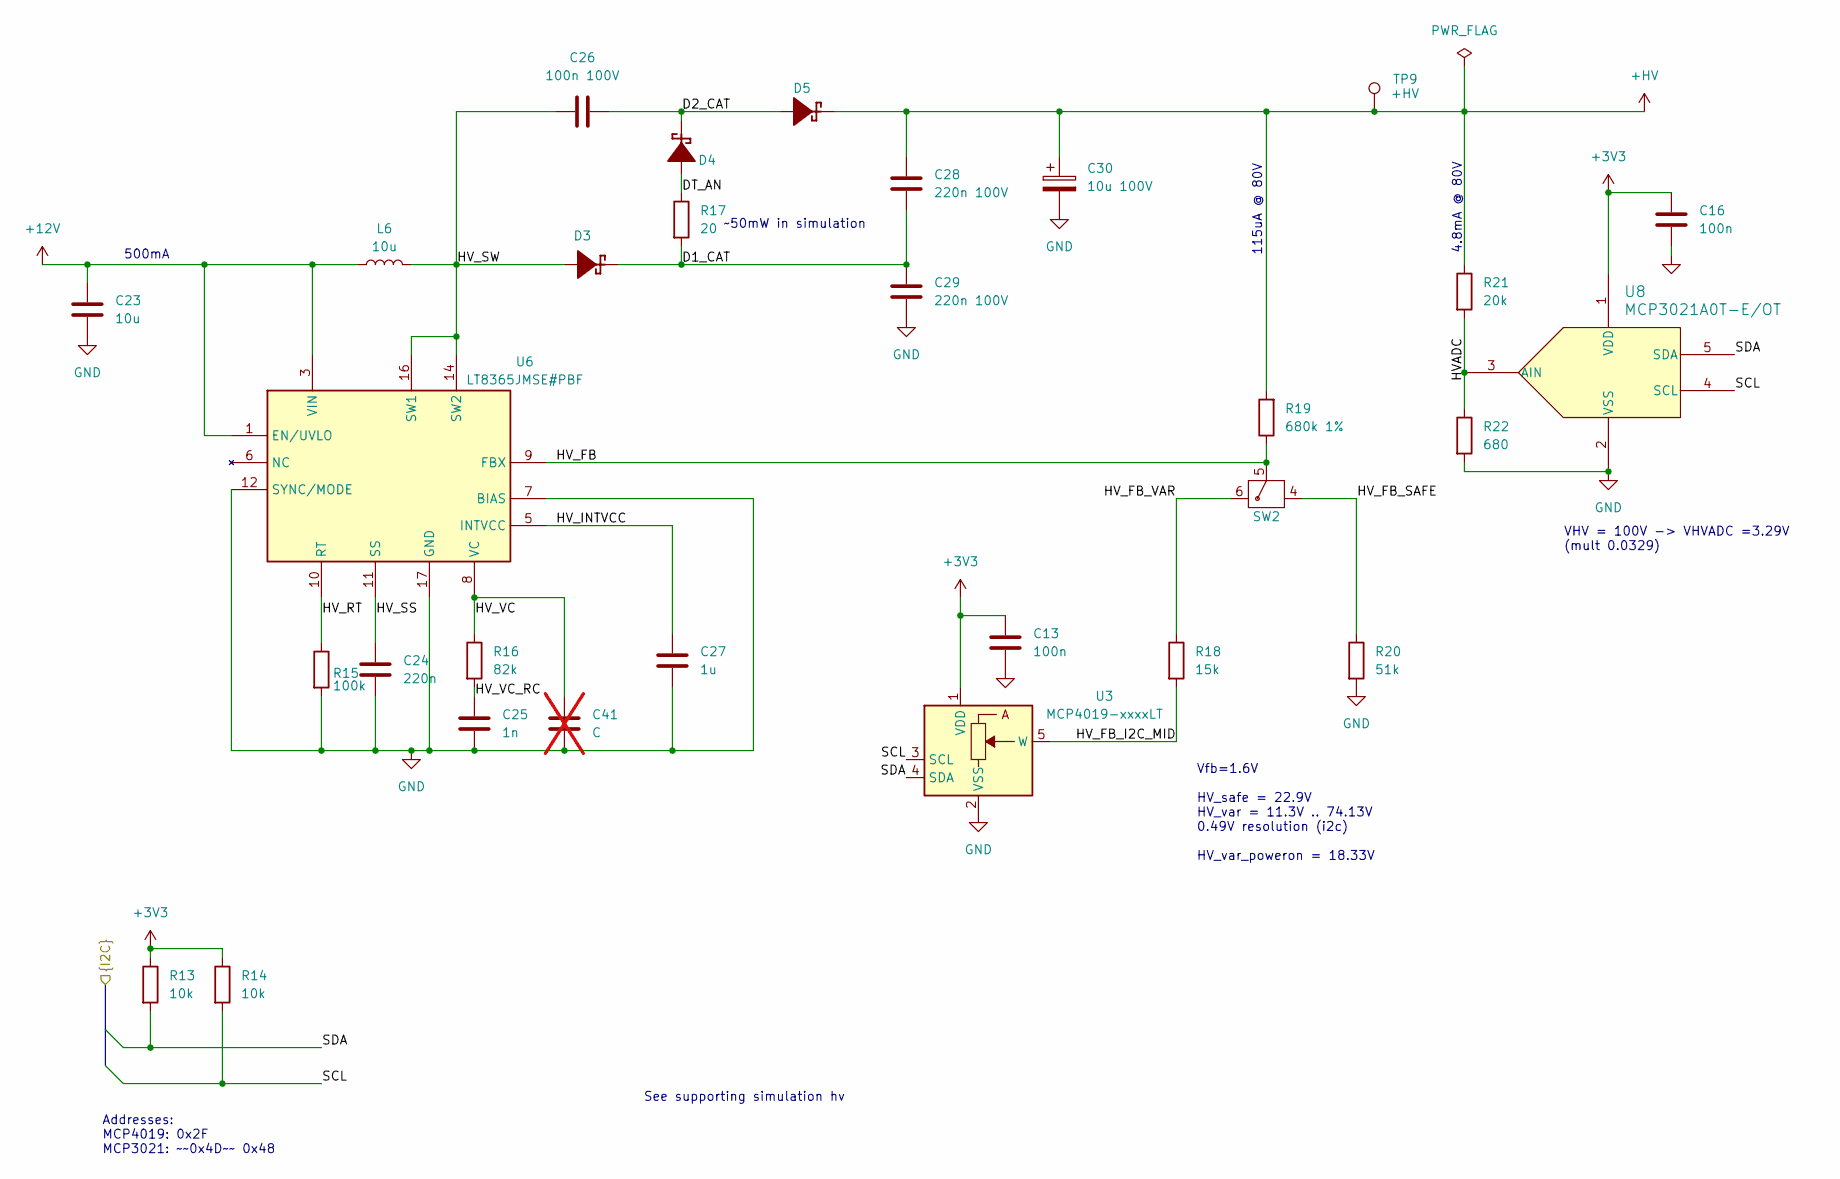
[picture p13: schematic hvplus.kicad_sch, Noninverting Positive Pulse Supply]

Parts:
C13, C16: 100n; C_0805_2012Metric_Pad1.18x1.45mm_HandSolder; Voltage Rating 25V; Manufacturer_Part_Number GCM21BR71E104KA37L; DigiKey Part Number 490-14779-1-ND
C23: 10u; C_0805_2012Metric_Pad1.18x1.45mm_HandSolder; Voltage Rating 25V; Manufacturer_Part_Number GRM21BR61E106KA73K; DigiKey Part Number 490-16824-2-ND
C24: 220n; C_0805_2012Metric_Pad1.18x1.45mm_HandSolder; Voltage Rating 25V; Manufacturer_Part_Number GRM219R71E224KA01D; DigiKey Part Number 490-1675-2-ND
C25: 1n; C_0805_2012Metric_Pad1.18x1.45mm_HandSolder; Voltage Rating 50V; Manufacturer_Part_Number GRM216R71H102KA01D
C26: 100n 100V; C_0805_2012Metric_Pad1.18x1.45mm_HandSolder; Voltage Rating 100V; Manufacturer_Part_Number GCM21BR72A104KA37L; DigiKey Part Number 490-4789-1-ND
C27: 1u; C_0805_2012Metric_Pad1.18x1.45mm_HandSolder; Voltage Rating 10V; Manufacturer_Part_Number GRM21BR71A105KA01L
C28, C29: 220n 100V; C_1210_3225Metric_Pad1.33x2.70mm_HandSolder; Voltage Rating 200V; Manufacturer_Part_Number GRM32DR72D224KW01L; DigiKey Part Number 490-13380-1-ND
C30: 10u 100V; CP_Radial_D10.0mm_P5.00mm; Voltage Rating 200V; Manufacturer_Part_Number ECA-2DHG100; DigiKey Part Number P19449-ND
C41: C; C_0805_2012Metric_Pad1.18x1.45mm_HandSolder; not fitted
D3, D4, D5: SMD1150PL-TP; SMD1150PL; Voltage Rating 150V; Mouser Part Number 621-DFLS1150-7
L6: 10u; WURTH_WE-LHMI-4.45mm; Mouser Part Number 710-74437324100
R13, R14: 10k; R_0805_2012Metric_Pad1.20x1.40mm_HandSolder; Manufacturer_Part_Number RC0805JR-0710K
R15: 100k; R_0805_2012Metric_Pad1.20x1.40mm_HandSolder; Manufacturer_Part_Number RC0805JR-07100R; DigiKey Part Number 311-107KCRCT-ND
R16: 82k; R_0805_2012Metric_Pad1.20x1.40mm_HandSolder; Manufacturer_Part_Number RC0805JR-0782K
R17: 20; R_0805_2012Metric_Pad1.20x1.40mm_HandSolder; Manufacturer_Part_Number RC0805JR-0720R
R18: 15k; R_0805_2012Metric_Pad1.20x1.40mm_HandSolder; Manufacturer_Part_Number RC0805FR-0712KL; DigiKey Part Number RC0805JR-0715K
R19: 680k 1%; R_0805_2012Metric_Pad1.20x1.40mm_HandSolder; Manufacturer_Part_Number RC0805FR-07680KL; DigiKey Part Number 311-680KCRCT-ND
R20: 51k; R_0805_2012Metric_Pad1.20x1.40mm_HandSolder; Manufacturer_Part_Number RC0805JR0751K; DigiKey Part Number 311-51KARCT-ND
R21: 20k; R_0805_2012Metric_Pad1.20x1.40mm_HandSolder; Manufacturer_Part_Number RC0805FR-071ML; DigiKey Part Number 311-1.00MCRCT-ND
R22: 680; R_0805_2012Metric_Pad1.20x1.40mm_HandSolder; Manufacturer_Part_Number AC0805FR-0727KL; DigiKey Part Number 13-AC0805FR-0727KLCT-ND
SW2: CST11T2CR; Manufacturer_Part_Number CST11T2CR; DigiKey Part Number 2449-CST11T2CR-ND
TP9: TestPoint; TestPoint_THTPad_2.5x2.5mm_Drill1.2mm
U3: MCP4019-xxxxLT; SOT-353_SC-70-5; Manufacturer_Part_Number MCP4018T-104E/LTY; DigiKey Part Number 150-MCP4018T-104E/LTYCT-ND
U6: LT8365JMSE#PBF; LT8365JMSEPBF; Mouser Part Number 584-LT8365JMSE#PBF
U8: MCP3021A0T-E/OT; SOT-23-5_MC_MCH-M; Manufacturer_Part_Number MCP3021A0T-E/OT; DigiKey Part Number MCP3021A0T-E/OTCT-ND

Connections:
+3V3: C13.1, C16.1, R13.1, R14.1, U3.1 (VDD), U8.1 (VDD); also elsewhere on the board
+12V: C23.1, L6.1, U6.1 (EN/UVLO), U6.3 (VIN); also elsewhere on the board
+HV: C28.1, C30.1, D5.1 (K), R19.2, R21.1, TP9.1 (1_1); also elsewhere on the board
/HV+.SCL: R14.2, U3.3 (SCL), U8.4 (SCL); also elsewhere on the board
/HV+.SDA: R13.2, U3.4 (SDA), U8.5 (SDA); also elsewhere on the board
/HV+/D1_CAT: C28.2, C29.1, D3.1 (K), R17.2
/HV+/D2_CAT: C26.2, D4.1 (K), D5.2 (A)
/HV+/DT_AN: D4.2 (A), R17.1
/HV+/HVADC: R21.2, R22.1, U8.3 (AIN)
/HV+/HV_FB: R19.1, SW2.5, U6.9 (FBX)
/HV+/HV_FB_I2C_MID: R18.2, U3.5 (W)
/HV+/HV_FB_SAFE: R20.1, SW2.4
/HV+/HV_FB_VAR: R18.1, SW2.6
/HV+/HV_INTVCC: C27.1, U6.5 (INTVCC)
/HV+/HV_RT: R15.1, U6.10 (RT)
/HV+/HV_SS: C24.1, U6.11 (SS)
/HV+/HV_SW: C26.1, D3.2 (A), L6.2, U6.14 (SW2), U6.16 (SW1)
/HV+/HV_VC: C41.1, R16.1, U6.8 (VC)
/HV+/HV_VC_RC: C25.1, R16.2
GND: C13.2, C16.2, C23.2, C24.2, C25.2, C27.2, C29.2, C30.2, C41.2, R15.2, R20.2, R22.2, U3.2 (VSS), U6.7 (BIAS), U6.12 (SYNC/MODE), U6.17 (GND), U8.2 (VSS); also elsewhere on the board

Notes on the sheet:
4.8mA @ 80V
~50mW in simulation
500mA
See supporting simulation hv
115uA @ 80V
Vfb=1.6V HV_safe = 22.9V HV_var = 11.3V .. 74.13V 0.49V resolution (i2c) HV_var_poweron = 18.33V
VHV = 100V -> VHVADC =3.29V (mult 0.0329)
Addresses: MCP4019: 0x2F MCP3021: ~~0x4D~~ 0x48

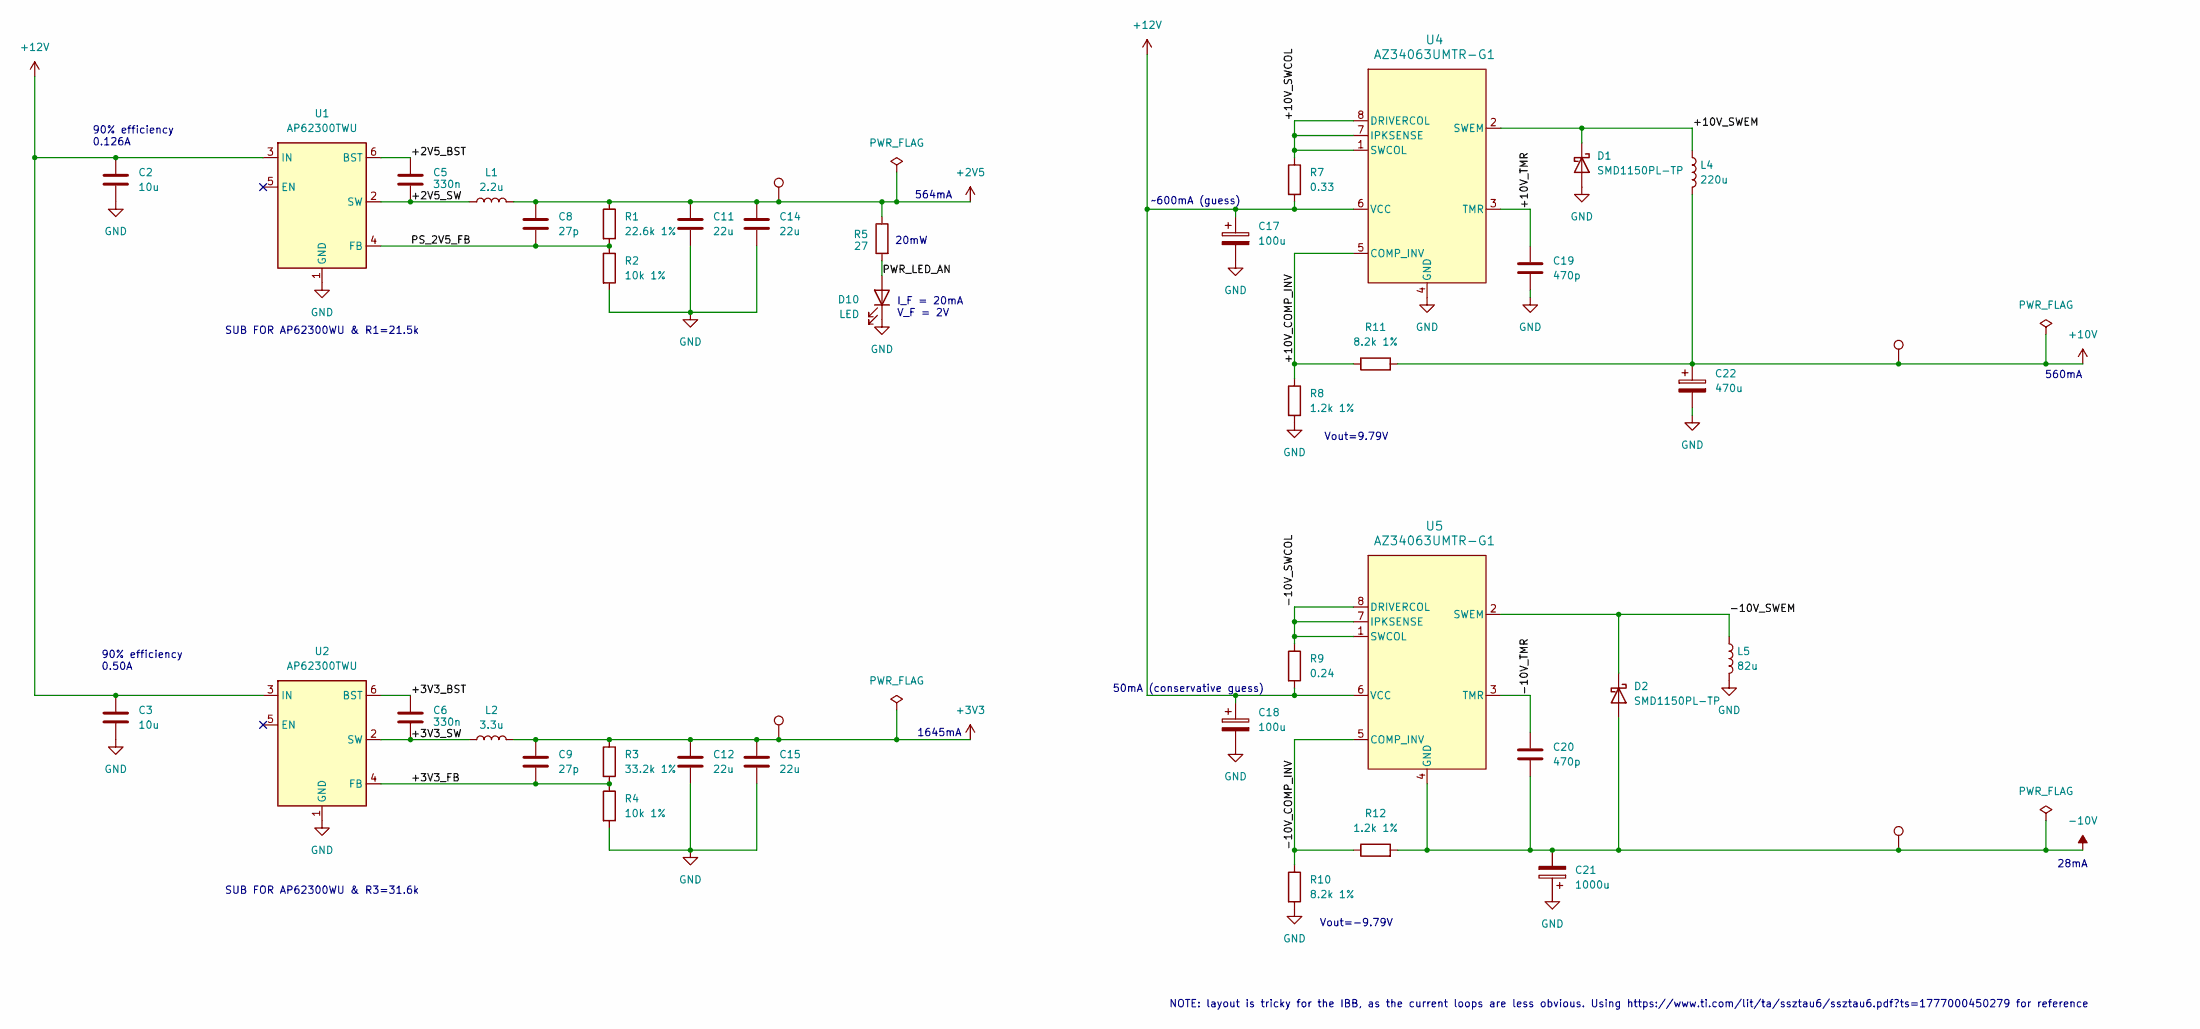
[picture p14: schematic lv_regs.kicad_sch, Low Voltage Supplies]

Parts:
C2, C3: 10u; C_0805_2012Metric_Pad1.18x1.45mm_HandSolder; Voltage Rating 25V; Manufacturer_Part_Number GRM21BR61E106KA73K; DigiKey Part Number 490-16824-2-ND
C5, C6: 330n; C_0805_2012Metric_Pad1.18x1.45mm_HandSolder; Voltage Rating 25V; Manufacturer_Part_Number GRM31C5C1E334JE01L; DigiKey Part Number 490-1677-2-ND
C8, C9: 27p; C_0805_2012Metric_Pad1.18x1.45mm_HandSolder; Voltage Rating 50V; Manufacturer_Part_Number GRM2165C1H270JZ01D
C11, C12, C14, C15: 22u; C_0805_2012Metric_Pad1.18x1.45mm_HandSolder; Voltage Rating 25V; Manufacturer_Part_Number GRM21BR71E334KA01L; DigiKey Part Number 490-10749-1-ND
C17, C18: 100u; CP_Radial_D5.0mm_P2.00mm; Voltage Rating 16V; Manufacturer_Part_Number 860010372006; DigiKey Part Number 732-8598-3-ND
C19, C20: 470p; C_0805_2012Metric_Pad1.18x1.45mm_HandSolder; Voltage Rating 50V; Manufacturer_Part_Number GRM2165C1H471JA01D; DigiKey Part Number 490-1617-2-ND
C21: 1000u; CP_Radial_D10.0mm_P5.00mm; Voltage Rating 16V; Manufacturer_Part_Number 860020375017; DigiKey Part Number 732-8804-3-ND
C22: 470u; CP_Radial_D8.0mm_P3.50mm; Voltage Rating 16V; Manufacturer_Part_Number 860020374012; DigiKey Part Number 732-8799-3-ND
D1, D2: SMD1150PL-TP; SMD1150PL; Voltage Rating 150V; Manufacturer_Part_Number SMD1150PL-TP; DigiKey Part Number SMD1150PL-TPMSCT-ND
D10: LED; LED_0805_2012Metric_Pad1.15x1.40mm_HandSolder; Manufacturer_Part_Number LTST-C171KRKT; DigiKey Part Number 160-1427-1-ND
L1: 2.2u; L_Murata_DFE201610P; Manufacturer_Part_Number DFE201610E-2R2M=P2; DigiKey Part Number 490-17728-1-ND
L2: 3.3u; L_1210_3225Metric_Pad1.42x2.65mm_HandSolder; Manufacturer_Part_Number IHLP1210BZEZ3R3M5A; DigiKey Part Number 541-IHLP1210BZEZ3R3M5ACT-ND
L4: 220u; L_Wuerth_WE-PDF_Handsoldering; Manufacturer_Part_Number 7447714221; DigiKey Part Number 732-4110-2-ND
L5: 82u; L_Wuerth_WE-PDF_Handsoldering; Manufacturer_Part_Number 7447714820; DigiKey Part Number 732-4109-2-ND
R1: 22.6k 1%; R_0805_2012Metric_Pad1.20x1.40mm_HandSolder; Manufacturer_Part_Number RC0805FR-0722K6L; DigiKey Part Number 311-22.6KCRCT-ND
R2, R4: 10k 1%; R_0805_2012Metric_Pad1.20x1.40mm_HandSolder; Manufacturer_Part_Number RC0805FR-0710KL; DigiKey Part Number 311-10.0KCRTR-ND
R3: 33.2k 1%; R_0805_2012Metric_Pad1.20x1.40mm_HandSolder; Manufacturer_Part_Number RC0805FR-0733K2L; DigiKey Part Number 311-33.2KCRTR-ND
R5: 27; R_0805_2012Metric_Pad1.20x1.40mm_HandSolder; Manufacturer_Part_Number RC0805JR-0727R
R7: 0.33; R_0805_2012Metric_Pad1.20x1.40mm_HandSolder; Manufacturer_Part_Number RL0805JR-070R33L; DigiKey Part Number 13-RL0805JR-070R33LCT-ND
R8, R12: 1.2k 1%; R_0805_2012Metric_Pad1.20x1.40mm_HandSolder; Manufacturer_Part_Number RC0805FR-131K2L; DigiKey Part Number 13-RC0805FR-131K2LCT-ND
R9: 0.24; R_0805_2012Metric_Pad1.20x1.40mm_HandSolder; Manufacturer_Part_Number RL0805FR-070R24L; DigiKey Part Number 311-.24SCT-ND
R10, R11: 8.2k 1%; R_0805_2012Metric_Pad1.20x1.40mm_HandSolder; Manufacturer_Part_Number RC0805FR-138K2L; DigiKey Part Number 13-RC0805FR-138K2LCT-ND
TP3, TP4, TP6, TP7: TestPoint; TestPoint_THTPad_2.5x2.5mm_Drill1.2mm
U1, U2: AP62300TWU; TSOT-23-6; Manufacturer_Part_Number AP62300TWU-7; DigiKey Part Number 31-AP62300TWU-7CT-ND
U4, U5: AZ34063UMTR-G1; SO-8_AZ3406-M_DIO-M; Manufacturer_Part_Number AZ34063UMTR-G1; DigiKey Part Number AZ34063UMTR-G1DICT-ND

Connections:
+2V5: C8.1, C11.1, C14.1, L1.2, R1.1, R5.1, TP3.1 (1_1); also elsewhere on the board
+3V3: C9.1, C12.1, C15.1, L2.2, R3.1, TP4.1 (1_1); also elsewhere on the board
+10V: C22.1, L4.2, R11.2, TP6.1 (1_1); also elsewhere on the board
+12V: C2.1, C3.1, C17.1, C18.1, R7.2, R9.2, U1.3 (IN), U2.3 (IN), U4.6 (VCC), U5.6 (VCC); also elsewhere on the board
-10V: C20.2, C21.2, D2.2 (A), R12.2, TP7.1 (1_1), U5.4 (GND); also elsewhere on the board
/LV_REGS/+2V5_BST: C5.1, U1.6 (BST)
/LV_REGS/+2V5_SW: C5.2, L1.1, U1.2 (SW)
/LV_REGS/+3V3_BST: C6.1, U2.6 (BST)
/LV_REGS/+3V3_FB: C9.2, R3.2, R4.1, U2.4 (FB)
/LV_REGS/+3V3_SW: C6.2, L2.1, U2.2 (SW)
/LV_REGS/+10V_COMP_INV: R8.1, R11.1, U4.5 (COMP_INV)
/LV_REGS/+10V_SWCOL: R7.1, U4.1 (SWCOL), U4.7 (IPKSENSE), U4.8 (DRIVERCOL)
/LV_REGS/+10V_SWEM: D1.1 (K), L4.1, U4.2 (SWEM)
/LV_REGS/+10V_TMR: C19.1, U4.3 (TMR)
/LV_REGS/-10V_COMP_INV: R10.1, R12.1, U5.5 (COMP_INV)
/LV_REGS/-10V_SWCOL: R9.1, U5.1 (SWCOL), U5.7 (IPKSENSE), U5.8 (DRIVERCOL)
/LV_REGS/-10V_SWEM: D2.1 (K), L5.1, U5.2 (SWEM)
/LV_REGS/-10V_TMR: C20.1, U5.3 (TMR)
/LV_REGS/PS_2V5_FB: C8.2, R1.2, R2.1, U1.4 (FB)
/LV_REGS/PWR_LED_AN: D10.2 (A), R5.2
GND: C2.2, C3.2, C11.2, C12.2, C14.2, C15.2, C17.2, C18.2, C19.2, C21.1, C22.2, D1.2 (A), D10.1 (K), L5.2, R2.2, R4.2, R8.2, R10.2, U1.1 (GND), U2.1 (GND), U4.4 (GND); also elsewhere on the board

Notes on the sheet:
20mW
I_F = 20mA V_F = 2V
564mA
1645mA
560mA
SUB FOR AP62300WU & R3=31.6k
Vout=-9.79V
Vout=9.79V
90% efficiency 0.126A
50mA (conservative guess)
28mA
90% efficiency 0.50A
~600mA (guess)
SUB FOR AP62300WU & R1=21.5k
NOTE: layout is tricky for the IBB, as the current loops are less obvious. Using https://www.ti.com/lit/ta/ssztau6/ssztau6.pdf?ts=1777000450279 for reference
