rosalyntg/ultrasound/pcb/power-board/power-board.kicad_pcb

## KiCad design pcb/power-board/power-board.kicad_pcb (continued)

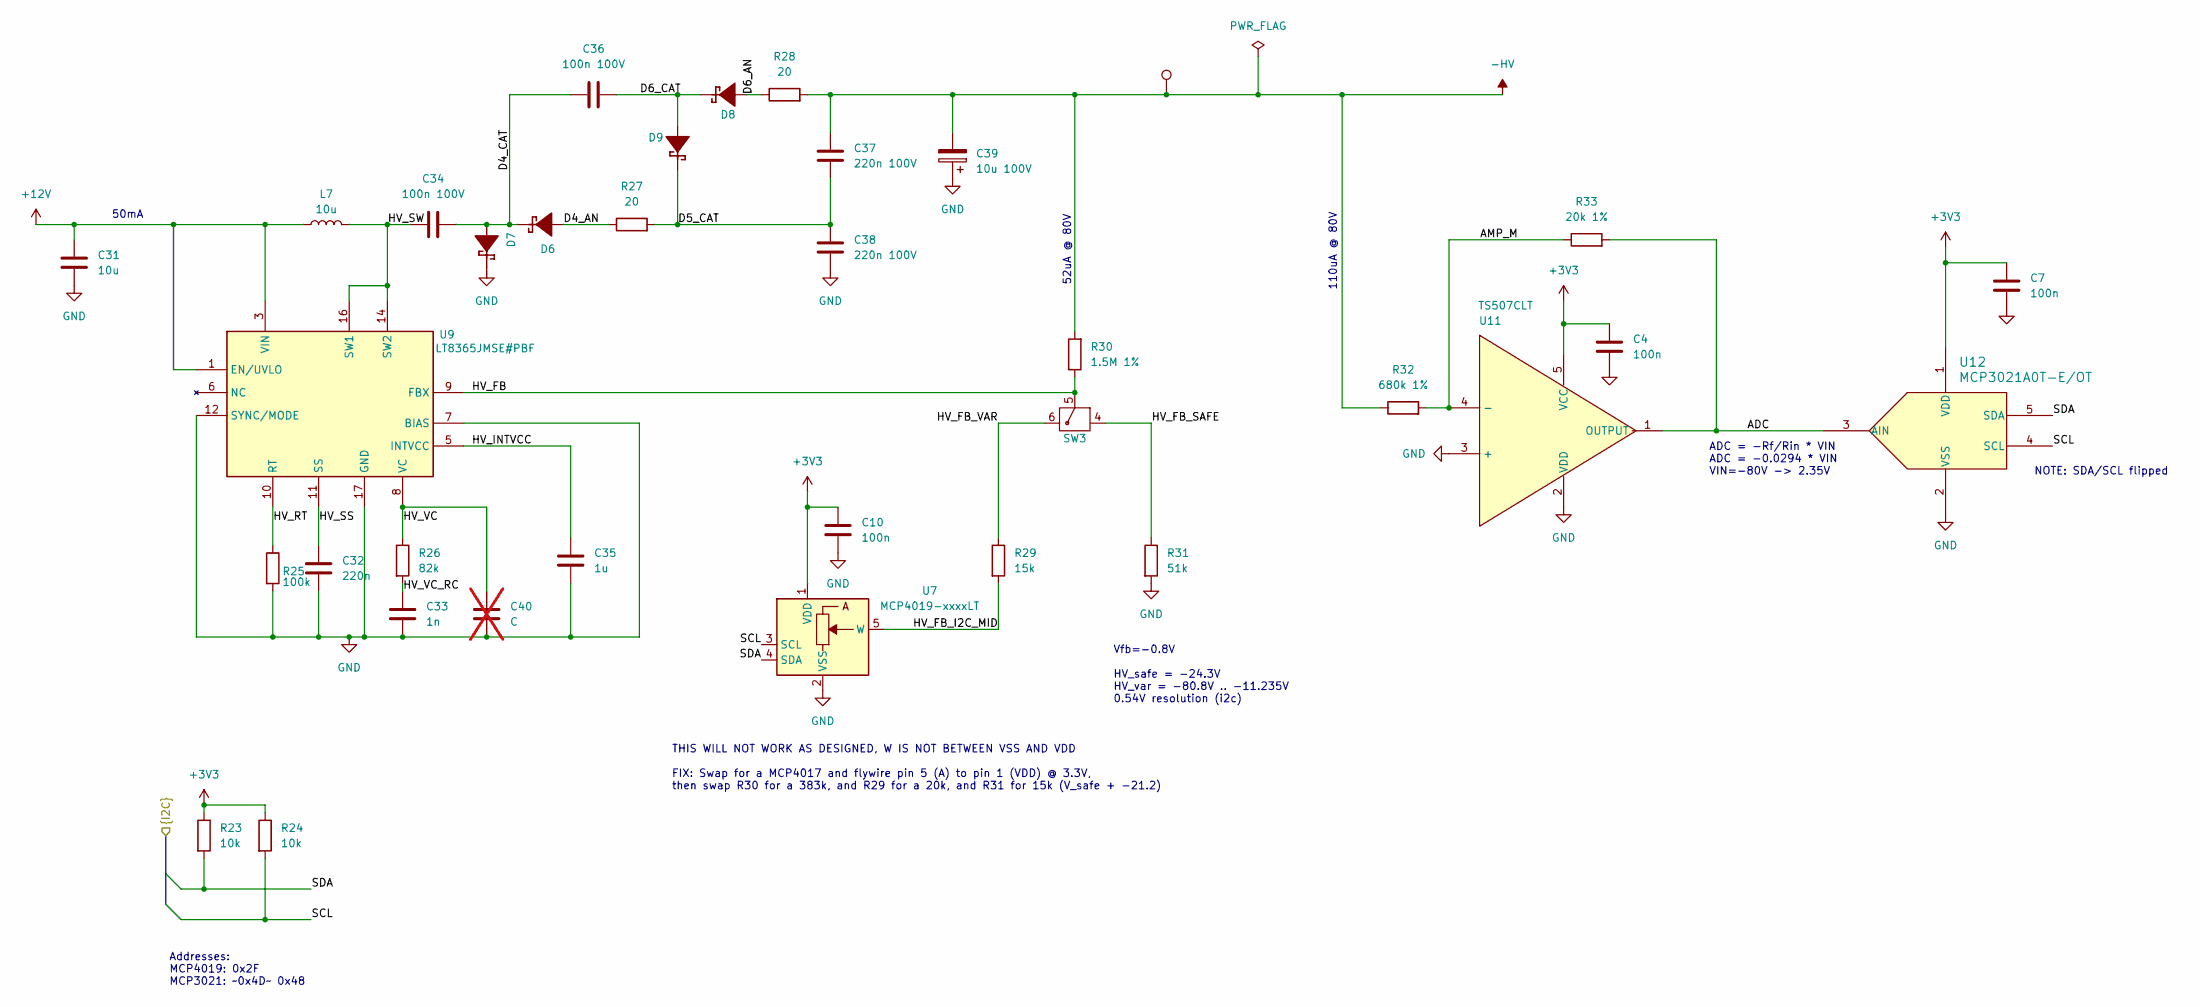
[picture p15: schematic hvminus.kicad_sch, Inverting Positive Pulse Supply]

Parts:
C4, C7, C10: 100n; C_0805_2012Metric_Pad1.18x1.45mm_HandSolder; Voltage Rating 25V; Manufacturer_Part_Number GCM21BR71E104KA37L; DigiKey Part Number 490-14779-1-ND
C31: 10u; C_0805_2012Metric_Pad1.18x1.45mm_HandSolder; Voltage Rating 25V; Manufacturer_Part_Number GRM21BR61E106KA73K; DigiKey Part Number 490-16824-2-ND
C32: 220n; C_0805_2012Metric_Pad1.18x1.45mm_HandSolder; Voltage Rating 25V; Manufacturer_Part_Number GRM219R71E224KA01D; DigiKey Part Number 490-1675-2-ND
C33: 1n; C_0805_2012Metric_Pad1.18x1.45mm_HandSolder; Voltage Rating 50V; Manufacturer_Part_Number GRM216R71H102KA01D
C34, C36: 100n 100V; C_0805_2012Metric_Pad1.18x1.45mm_HandSolder; Voltage Rating 100V; Manufacturer_Part_Number GCM21BR72A104KA37L; DigiKey Part Number 490-4789-1-ND
C35: 1u; C_0805_2012Metric_Pad1.18x1.45mm_HandSolder; Voltage Rating 10V; Manufacturer_Part_Number GRM21BR71A105KA01L
C37, C38: 220n 100V; C_1210_3225Metric_Pad1.33x2.70mm_HandSolder; Voltage Rating 200V; Manufacturer_Part_Number GRM32DR72D224KW01L; DigiKey Part Number 490-13380-1-ND
C39: 10u 100V; CP_Radial_D10.0mm_P5.00mm; Voltage Rating 200V; Manufacturer_Part_Number ECA-2DHG100; DigiKey Part Number P19449-ND
C40: C; C_0805_2012Metric_Pad1.18x1.45mm_HandSolder; not fitted
D6, D7, D8, D9: SMD1150PL-TP; SMD1150PL; Voltage Rating 150V; Mouser Part Number 621-DFLS1150-7
L7: 10u; WURTH_WE-LHMI-4.45mm; Mouser Part Number 710-74437324100
R23, R24: 10k; R_0805_2012Metric_Pad1.20x1.40mm_HandSolder; Manufacturer_Part_Number RC0805JR-0710K
R25: 100k; R_0805_2012Metric_Pad1.20x1.40mm_HandSolder; Manufacturer_Part_Number RC0805JR-07100R; DigiKey Part Number 311-107KCRCT-ND
R26: 82k; R_0805_2012Metric_Pad1.20x1.40mm_HandSolder; Manufacturer_Part_Number RC0805JR-0782K
R27, R28: 20; R_0805_2012Metric_Pad1.20x1.40mm_HandSolder; Manufacturer_Part_Number RC0805JR-0720R
R29: 15k; R_0805_2012Metric_Pad1.20x1.40mm_HandSolder; Manufacturer_Part_Number RC0805FR-0712KL; DigiKey Part Number RC0805JR-0715K
R30: 1.5M 1%; R_0805_2012Metric_Pad1.20x1.40mm_HandSolder; Manufacturer_Part_Number RT0805BRD071M5L; DigiKey Part Number 13-RT0805BRD071M5LCT-ND
R31: 51k; R_0805_2012Metric_Pad1.20x1.40mm_HandSolder; Manufacturer_Part_Number RC0805JR-0751K
R32: 680k 1%; R_0805_2012Metric_Pad1.20x1.40mm_HandSolder; Manufacturer_Part_Number RC0805FR-07680KL; DigiKey Part Number 311-680KCRCT-ND
R33: 20k 1%; R_0805_2012Metric_Pad1.20x1.40mm_HandSolder; Manufacturer_Part_Number RC0805FR-0720KL; DigiKey Part Number 311-20.0KCRCT-ND
SW3: CST11T2CR; Manufacturer_Part_Number CST11T2CR; DigiKey Part Number 2449-CST11T2CR-ND
TP11: TestPoint; TestPoint_THTPad_2.5x2.5mm_Drill1.2mm
U7: MCP4019-xxxxLT; SOT-353_SC-70-5; Manufacturer_Part_Number MCP4019T-104E/LTCT-ND; DigiKey Part Number MCP4019T-104E/LT
U9: LT8365JMSE#PBF; LT8365JMSEPBF; Mouser Part Number 584-LT8365JMSE#PBF
U11: TS507CLT; SOT95P280X145-5N; Manufacturer_Part_Number TS507CLT; Mouser Part Number 511-TS507CLT
U12: MCP3021A0T-E/OT; SOT-23-5_MC_MCH-M; Manufacturer_Part_Number MCP3021A0T-E/OT; DigiKey Part Number MCP3021A0T-E/OTCT-ND

Connections:
+3V3: C4.1, C7.1, C10.1, R23.1, R24.1, U7.1 (VDD), U11.5 (VCC), U12.1 (VDD); also elsewhere on the board
+12V: C31.1, L7.1, U9.1 (EN/UVLO), U9.3 (VIN); also elsewhere on the board
-HV: C37.1, C39.2, R28.2, R30.2, R32.1, TP11.1 (1_1); also elsewhere on the board
/HV-.SCL: R24.2, U7.3 (SCL), U12.4 (SCL); also elsewhere on the board
/HV-.SDA: R23.2, U7.4 (SDA), U12.5 (SDA); also elsewhere on the board
/HV-/ADC: R33.2, U11.1 (OUTPUT), U12.3 (AIN)
/HV-/AMP_M: R32.2, R33.1, U11.4 (-)
/HV-/D4_AN: D6.2 (A), R27.1
/HV-/D4_CAT: C34.2, C36.1, D6.1 (K), D7.2 (A)
/HV-/D5_CAT: C37.2, C38.1, D9.1 (K), R27.2
/HV-/D6_AN: D8.2 (A), R28.1
/HV-/D6_CAT: C36.2, D8.1 (K), D9.2 (A)
/HV-/HV_FB: R30.1, SW3.5, U9.9 (FBX)
/HV-/HV_FB_I2C_MID: R29.2, U7.5 (W)
/HV-/HV_FB_SAFE: R31.1, SW3.4
/HV-/HV_FB_VAR: R29.1, SW3.6
/HV-/HV_INTVCC: C35.1, U9.5 (INTVCC)
/HV-/HV_RT: R25.1, U9.10 (RT)
/HV-/HV_SS: C32.1, U9.11 (SS)
/HV-/HV_SW: C34.1, L7.2, U9.14 (SW2), U9.16 (SW1)
/HV-/HV_VC: C40.1, R26.1, U9.8 (VC)
/HV-/HV_VC_RC: C33.1, R26.2
GND: C4.2, C7.2, C10.2, C31.2, C32.2, C33.2, C35.2, C38.2, C39.1, C40.2, D7.1 (K), R25.2, R31.2, U7.2 (VSS), U9.7 (BIAS), U9.12 (SYNC/MODE), U9.17 (GND), U11.2 (VDD), U11.3 (+), U12.2 (VSS); also elsewhere on the board

Notes on the sheet:
THIS WILL NOT WORK AS DESIGNED, W IS NOT BETWEEN VSS AND VDD FIX: Swap for a MCP4017 and flywire pin 5 (A) to pin 1 (VDD) @ 3.3V, then swap R30 for a 383k, and R29 for a 20k, and R31 for 15k (V_safe + -21.2)
110uA @ 80V
NOTE: SDA/SCL flipped
Addresses: MCP4019: 0x2F MCP3021: ~0x4D~ 0x48
ADC = -Rf/Rin * VIN ADC = -0.0294 * VIN VIN=-80V -> 2.35V
50mA
52uA @ 80V
Vfb=-0.8V HV_safe = -24.3V HV_var = -80.8V .. -11.235V 0.54V resolution (i2c)

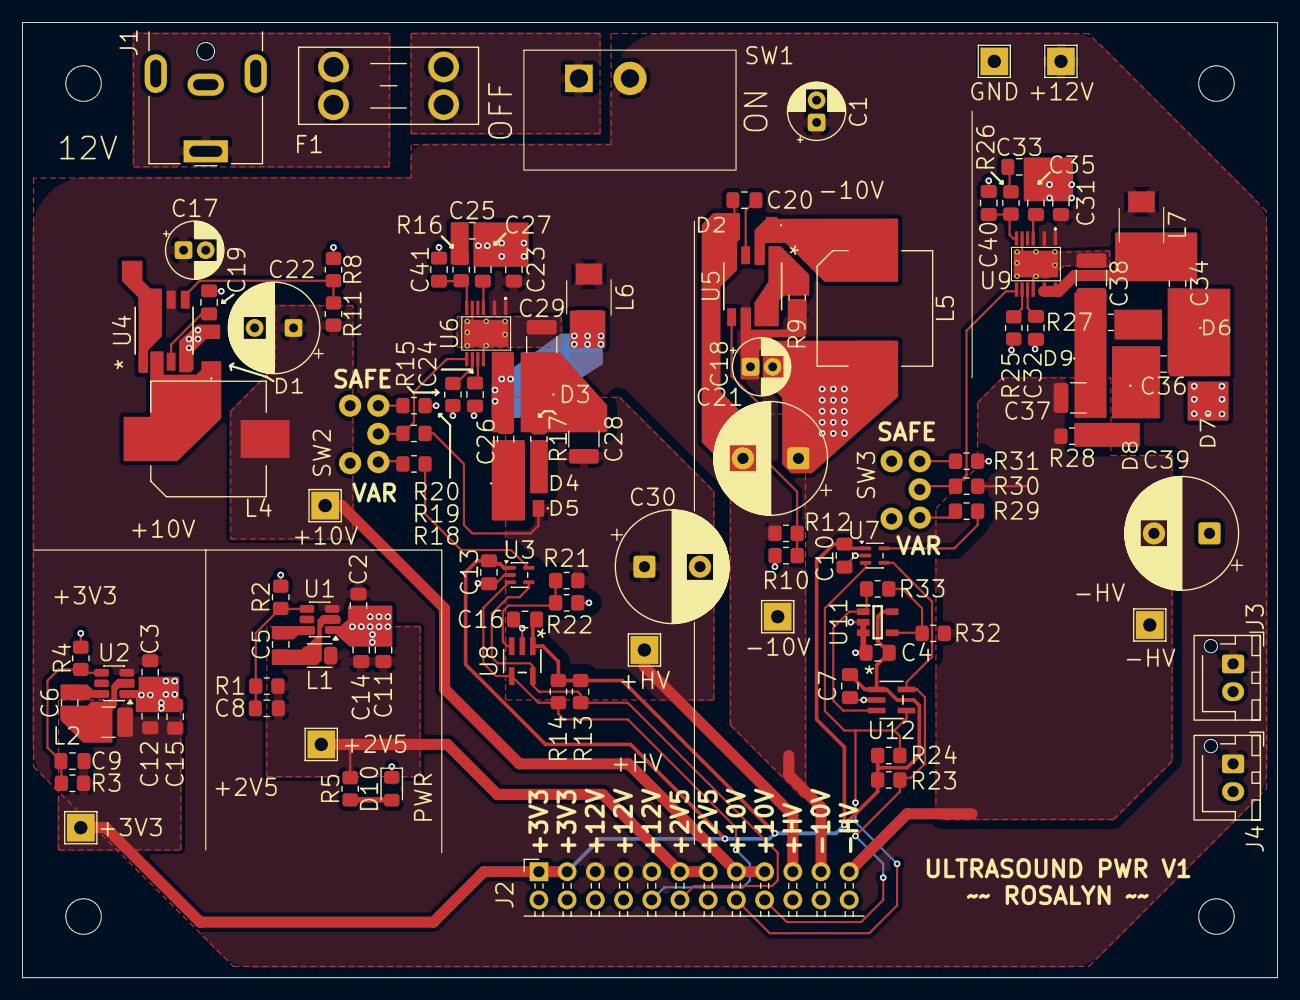
[picture p16: board power-board.kicad_pcb from above]

Board: 2 copper layers, 113.0 x 86.0 mm, 120 parts (1 on the bottom side), 60 nets.
