rosalyntg/ultrasound/pcb/ultrasound/ultrasound.kicad_pcb

## KiCad design pcb/ultrasound/ultrasound.kicad_pcb (2026-09-27)

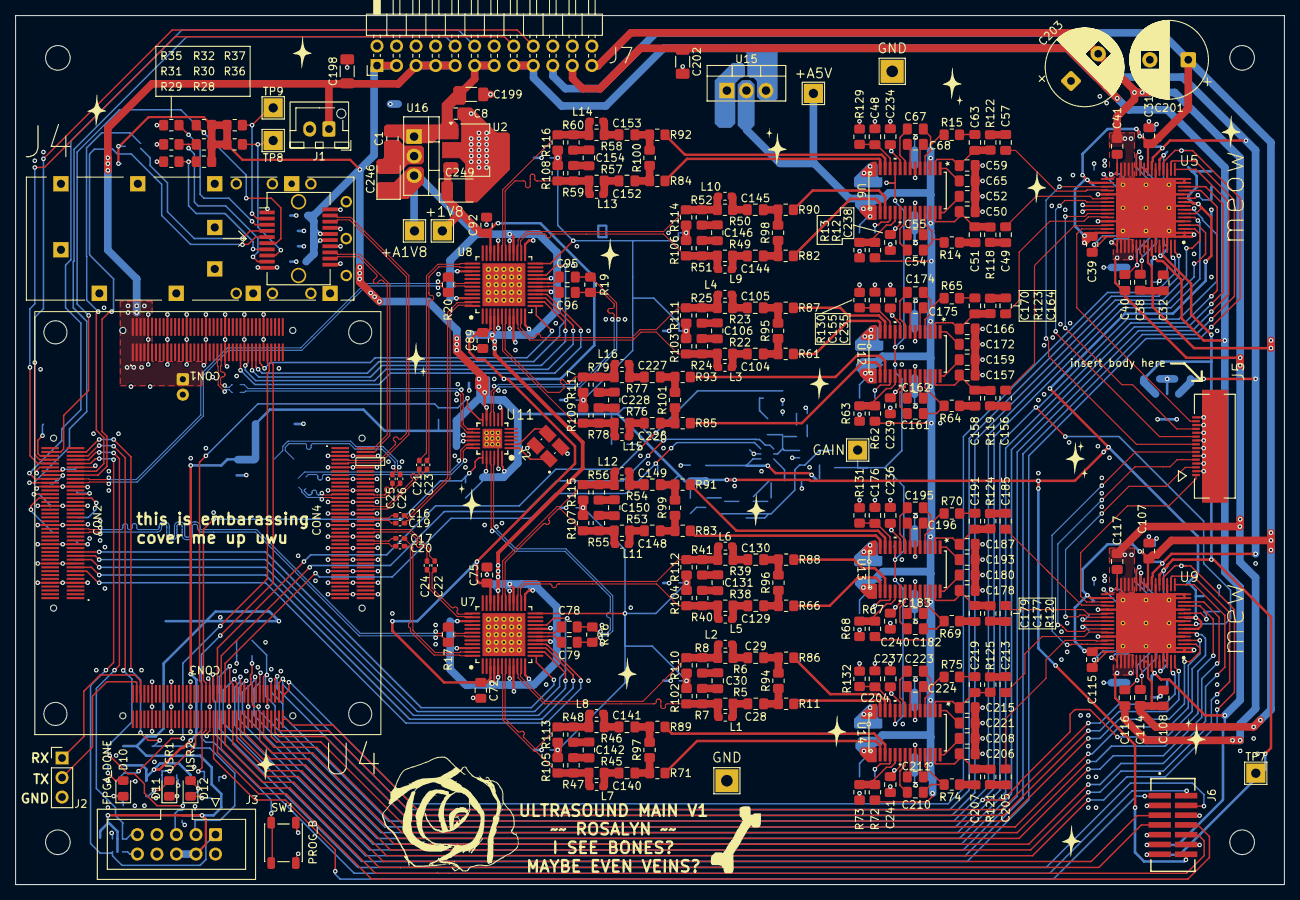
[picture p17: board ultrasound.kicad_pcb from above]

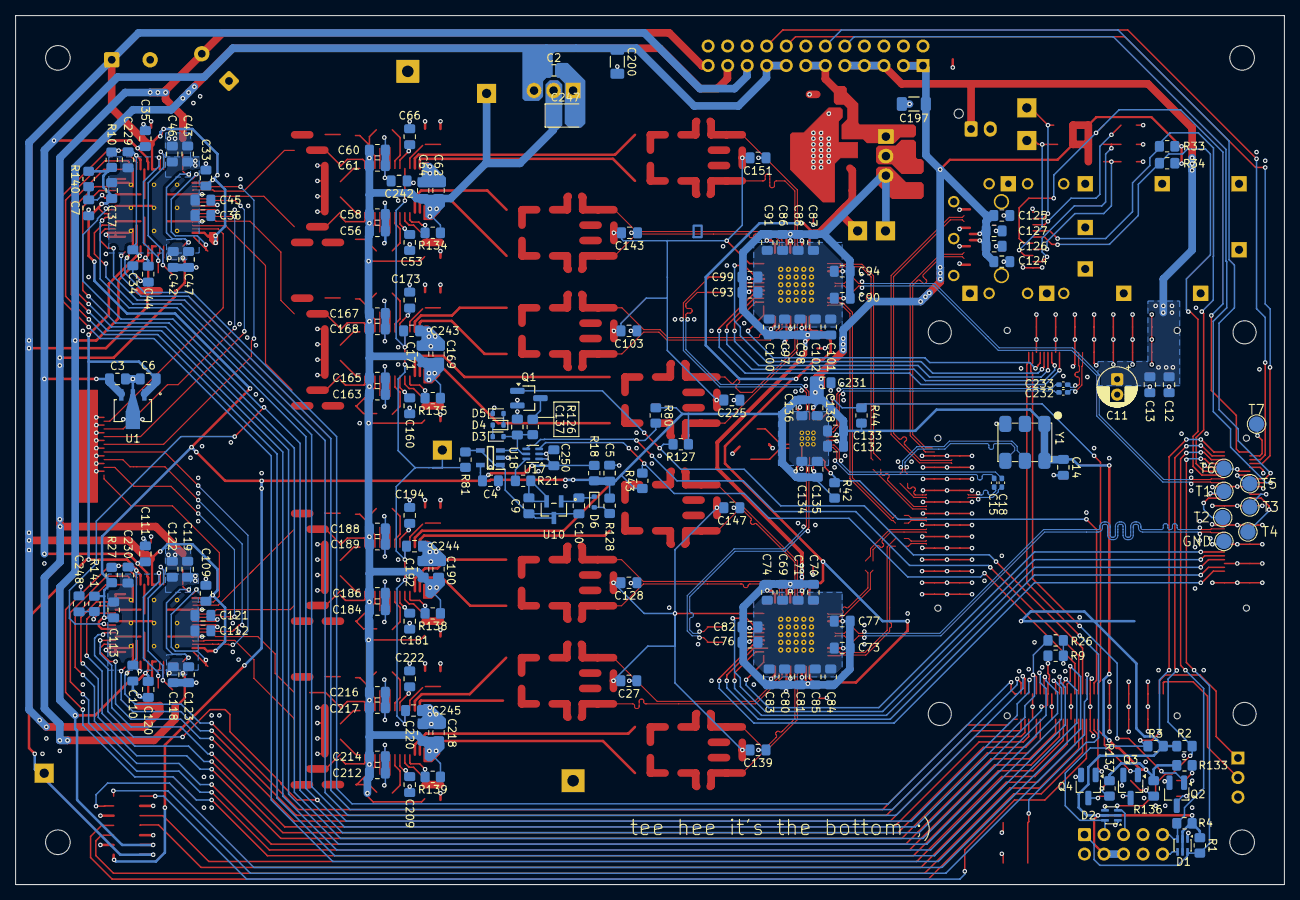
[picture p18: board ultrasound.kicad_pcb from below]

Board: 4 copper layers, 165.0 x 113.0 mm, 468 parts (179 on the bottom side), 342 nets.

Parts:
C1, C2, C8, C124, C125, C231: 10u; C_0805_2012Metric_Pad1.18x1.45mm_HandSolder
C3: 330n; C_0805_2012Metric_Pad1.18x1.45mm_HandSolder
C4, C6, C14, C27, C28, C29, C48, C49, C52, C53, C54, C55, C56, C57, C60, C62, C65, C66, C67, C68, C69, C70, C71, C72, C73, C74, C75, C76, C77, C78, C79, C80, C81, C82, C83, C84, C85, C86, C87, C88, C89, C90, C91, C92, C93, C94, C95, C96, C97, C98, C99, C100, C101, C102, C103, C104, C105, C126, C127, C128, C129, C130, C132, C133, C134, C135, C136, C138, C139, C140, C141, C143, C144, C145, C147, C148, C149, C151, C152, C153, C155, C156, C159, C160, C161, C162, C163, C164, C167, C169, C172, C173, C174, C175, C176, C177, C180, C181, C182, C183, C184, C185, C188, C190, C193, C194, C195, C196, C204, C205, C208, C209, C210, C211, C212, C213, C216, C218, C221, C222, C223, C224, C225, C226, C227, C250: 100n; C_0805_2012Metric_Pad1.18x1.45mm_HandSolder
C5, C7, C248: C; C_0805_2012Metric_Pad1.18x1.45mm_HandSolder
C9, C10, C36, C45, C112, C121: 1u; C_0805_2012Metric_Pad1.18x1.45mm_HandSolder
C11: 100u; CP_Radial_D5.0mm_P2.00mm
C12, C13: 22u; C_0805_2012Metric_Pad1.18x1.45mm_HandSolder
C15, C16, C17, C18, C19, C20, C21, C22, C23, C24: 100n; C_0402_1005Metric_Pad0.74x0.62mm_HandSolder
C25, C26, C232, C233: 10n; C_0402_1005Metric_Pad0.74x0.62mm_HandSolder
C30, C50, C59, C106, C131, C142, C146, C150, C154, C157, C166, C178, C187, C206, C215, C228: 22p; C_0805_2012Metric_Pad1.18x1.45mm_HandSolder
C31, C32, C33, C107, C108, C109: 2.2u 100V; C_0805_2012Metric_Pad1.18x1.45mm_HandSolder
C34, C35, C37, C38, C39, C40, C41, C44, C110, C111, C113, C114, C115, C116, C117, C120, C229, C230: 2.2u; C_0805_2012Metric_Pad1.18x1.45mm_HandSolder
C42, C43, C46, C47, C118, C119, C122, C123: 1u 100V; C_0805_2012Metric_Pad1.18x1.45mm_HandSolder
C51, C63, C158, C170, C179, C191, C207, C219: 18n; C_0805_2012Metric_Pad1.18x1.45mm_HandSolder
C58, C61, C64, C165, C168, C171, C186, C189, C192, C214, C217, C220, C234, C235, C236, C237, C238, C239, C240, C241, C242, C243, C244, C245: 1n; C_0805_2012Metric_Pad1.18x1.45mm_HandSolder
C137: 3n; C_0805_2012Metric_Pad1.18x1.45mm_HandSolder
C197, C198, C199, C200, C202: 100u; C_1206_3216Metric_Pad1.33x1.80mm_HandSolder
C201, C203: 10u 100V; CP_Radial_D10.0mm_P5.00mm
C246, C247, C249: 47u Tantalum; CP_EIA-3528-15_AVX-H_HandSolder
D1, D2: BAT54SDW; SOT-363_SC-70-6
D3, D4, D5, D6: 1N914WT; D_SOD-523
D10, D11, D12: LED; LED_0805_2012Metric_Pad1.15x1.40mm_HandSolder
H1, H2, H3, H4: MountingHole; MountingHole_3.2mm_M3
J1: B2B-XH-A; JST_XH_B2B-XH-AM_1x02_P2.50mm_Vertical
J2: Conn_01x03; PinHeader_1x03_P2.54mm_Vertical
J3: AVR-JTAG-10; IDC-Header_2x05_P2.54mm_Vertical
J4: UE76A202000T; Connector_SFP_and_Cage
J5: 5051101692; CON_5051101692_MOL
J6: Conn_02x07_Counter_Clockwise; SAMTEC_TFM-107-02-L-D
J7: Conn_02x12_Odd_Even; PinHeader_2x12_P2.54mm_Horizontal
L1, L2, L3, L4, L5, L6, L7, L8, L9, L10, L11, L12, L13, L14, L15, L16: 39n; L_0603_1608Metric_Pad1.05x0.95mm_HandSolder
Q1, Q2, Q3, Q4: BS170F; SOT-23_Handsoldering
R1, R2, R3, R4, R21, R26, R32, R33, R34, R42, R43, R44, R80, R127: 10k; R_0805_2012Metric_Pad1.20x1.40mm_HandSolder
R5, R6, R9, R12, R13, R18, R22, R23, R38, R39, R45, R46, R49, R50, R53, R54, R57, R58, R62, R63, R67, R68, R72, R73, R76, R77, R118, R119, R120, R121, R122, R123, R124, R125, R140, R141: 0; R_0805_2012Metric_Pad1.20x1.40mm_HandSolder
R7, R8, R24, R25, R40, R41, R47, R48, R51, R52, R55, R56, R59, R60, R78, R79: 150; R_0805_2012Metric_Pad1.20x1.40mm_HandSolder
R10, R27: 100k; R_0805_2012Metric_Pad1.20x1.40mm_HandSolder
R11, R61, R66, R71, R82, R83, R84, R85, R86, R87, R88, R89, R90, R91, R92, R93, R133, R136, R137: 68; R_0805_2012Metric_Pad1.20x1.40mm_HandSolder
R14, R15, R64, R65, R69, R70, R74, R75: 280 1%; R_0805_2012Metric_Pad1.20x1.40mm_HandSolder
R16, R17, R19, R20: 100 1%; R_0805_2012Metric_Pad1.20x1.40mm_HandSolder
R28, R29, R30, R31, R35: R; R_0805_2012Metric_Pad1.20x1.40mm_HandSolder
R36, R37: 4.3k; R_0805_2012Metric_Pad1.20x1.40mm_HandSolder
R81: 500; R_0805_2012Metric_Pad1.20x1.40mm_HandSolder
R94, R95, R96, R97, R98, R99, R100, R101: 374; R_0805_2012Metric_Pad1.20x1.40mm_HandSolder
R102, R103, R104, R105, R106, R107, R108, R109, R110, R111, R112, R113, R114, R115, R116, R117: 1k; R_0805_2012Metric_Pad1.20x1.40mm_HandSolder
R126: 200; R_0805_2012Metric_Pad1.20x1.40mm_HandSolder
R128: 510; R_0805_2012Metric_Pad1.20x1.40mm_HandSolder
R129, R130, R131, R132: 6.8k; R_0805_2012Metric_Pad1.20x1.40mm_HandSolder
R134, R135, R138, R139: 5.1k; R_0805_2012Metric_Pad1.20x1.40mm_HandSolder
SW1: SW_SPST; SW_SPST_PTS647_Sx38
TP1, TP2, TP3, TP5, TP7, TP8, TP9: TestPoint; TestPoint_THTPad_2.5x2.5mm_Drill1.2mm
TP4, TP6: TestPoint; TestPoint_THTPad_3.0x3.0mm_Drill1.5mm
TP10, TP11, TP12, TP13, TP14, TP15, TP16, TP17: TestPoint; TestPoint_Pad_D2.0mm
U1: AS78L05RTR-E1; SOT89_B8D_DIO-M
U2: MCP1755ST; SOT-223-3_TabPin2
U4: AXAU15; AXAU15_CLIP
U5, U9: HV7321K6-G; QFN50P900X900X100-65N-D
U6, U12, U13, U14: AD8332ARUZ; RU_28_ADI-M
U7, U8: ADC34J22IRGZ25; RGZ0048D_TEX
U10: MAX6018BEUR12+T; 21-0051H_MXM-M
U11: SI5338Q-B-GM; SI5338QBGM
U15: LM1085IT-5.0; TO-220-3_Vertical
U16: MIC39300-1.8WT; TO-220-3_Vertical
U17: MCP4017-103E/LTY; SOT-363_SC-70-6
U18: TS507CLT; SOT95P280X145-5N
Y1: SIT9121AC-2D2-33E156.250000; Oscillator_SMD_SiTime_PQFD-6L_7x5mm
Y2: FA-238 25.0000MB-C3; XTAL_FA-238_25.0000MB50X-C0

Connections:
+1V8: C72.1, C75.1, C89.1, C92.1, C249.1, D1.2 (K), D1.5 (K), D2.2 (K), D2.5 (K), J3.4 (VREF), J3.6 (~SRST), R1.1, R2.1, R3.1, R4.1, TP5.1 (1_1), U2.3 (VO), U7.3 (DVDD), U7.34 (DVDD), U8.3 (DVDD), U8.34 (DVDD)
+2V5: C1.1, C8.1, C199.1, J7.11, J7.13, U2.1 (VI), U16.1 (IN)
+3V3: C5.1, C14.1, C37.1, C113.1, C124.1, C125.1, C126.1, C127.1, C132.1, C133.1, C134.1, C135.1, C136.1, C138.1, C197.1, C231.1, J4.15 (VccR), J4.16 (VccT), J6.14, J7.1, J7.3, R10.1, R18.2, R27.1, R28.1, R30.1, R32.1, R33.1, R34.1, R36.1, R37.1, R42.1, R43.1, R44.1, R80.1, R127.1, R128.2, R133.1, R136.1, R137.1, R140.1, R141.1, U5.7 (PWS), U5.10 (VLL), U9.7 (PWS), U9.10 (VLL), U11.7 (VDD_1), U11.11 (VDDO3), U11.15 (VDDO2), U11.16 (VDDO1), U11.20 (VDDO0), U11.24 (VDD_2), Y1.1 (OE), Y1.6 (VDD)
+5V: C6.1, C34.1, C110.1, C229.1, C230.1, J6.13, TP7.1 (1_1), U1.1 (OUTPUT), U5.21 (VDD_1), U5.60 (VDD_2), U9.21 (VDD_1), U9.60 (VDD_2)
+10V: C2.1, C3.1, C35.1, C111.1, C200.1, J7.15, J7.17, U1.3 (INPUT), U5.23 (VGP), U9.23 (VGP), U15.3 (IN)
+12V: C11.1, C12.1, C13.1, C198.1, J1.1, J7.5, J7.7, J7.9, U4.1x1 (VCCIN), U4.1x2 (VCCIN), U4.1x3 (VCCIN), U4.1x4 (VCCIN), U4.1x5 (VCCIN), U4.1x6 (VCCIN), U4.1x7 (VCCIN), U4.1x8 (VCCIN)
+A1V8: C69.1, C70.1, C71.1, C73.1, C74.1, C76.1, C77.1, C80.1, C81.1, C82.1, C83.1, C84.1, C85.1, C86.1, C87.1, C88.1, C90.1, C91.1, C93.1, C94.1, C97.1, C98.1, C99.1, C100.1, C101.1, C102.1, C246.1, TP1.1 (1_1), U7.4 (AVDD), U7.5 (AVDD), U7.8 (AVDD), U7.9 (AVDD), U7.12 (AVDD), U7.17 (AVDD), U7.20 (AVDD), U7.25 (AVDD), U7.28 (AVDD), U7.29 (AVDD), U7.32 (AVDD), U7.39 (AVDD), U7.46 (AVDD), U8.4 (AVDD), U8.5 (AVDD), U8.8 (AVDD), U8.9 (AVDD), U8.12 (AVDD), U8.17 (AVDD), U8.20 (AVDD), U8.25 (AVDD), U8.28 (AVDD), U8.29 (AVDD), U8.32 (AVDD), U8.39 (AVDD), U8.46 (AVDD), U16.3 (OUT)
+A5V: C56.1, C58.1, C60.1, C61.1, C62.1, C64.1, C163.1, C165.1, C167.1, C168.1, C169.1, C171.1, C184.1, C186.1, C188.1, C189.1, C190.1, C192.1, C212.1, C214.1, C216.1, C217.1, C218.1, C220.1, C247.1, R12.1, R62.1, R67.1, R72.1, R134.1, R135.1, R138.1, R139.1, TP2.1 (1_1), U6.3 (VPS2), U6.15 (VPSV), U6.26 (VPS1), U12.3 (VPS2), U12.15 (VPSV), U12.26 (VPS1), U13.3 (VPS2), U13.15 (VPSV), U13.26 (VPS1), U14.3 (VPS2), U14.15 (VPSV), U14.26 (VPS1), U15.2 (OUT)
+HV: C31.1, C32.1, C33.1, C38.1, C39.1, C107.1, C108.1, C109.1, C114.1, C115.1, C201.1, J7.19, U5.24 (VPP0_1), U5.25 (VPP0_2), U5.34 (VPP1_1), U5.47 (VPP1_2), U5.56 (VPP0_3), U5.57 (VPP0_4), U9.24 (VPP0_1), U9.25 (VPP0_2), U9.34 (VPP1_1), U9.47 (VPP1_2), U9.56 (VPP0_3), U9.57 (VPP0_4)
-10V: C44.1, C120.1, C202.1, J6.11, J7.21, U5.58 (VGN), U9.58 (VGN)
-HV: C40.1, C41.1, C42.1, C43.1, C46.1, C47.1, C116.1, C117.1, C118.1, C119.1, C122.1, C123.1, C203.2, J7.23, U5.28 (VNN0_1), U5.29 (VNN0_2), U5.30 (VNN2_1), U5.31 (VNN1_1), U5.50 (VNN1_2), U5.51 (VNN2_2), U5.52 (VNN0_3), U5.53 (VNN0_4), U9.28 (VNN0_1), U9.29 (VNN0_2), U9.30 (VNN2_1), U9.31 (VNN1_1), U9.50 (VNN1_2), U9.51 (VNN2_2), U9.52 (VNN0_3), U9.53 (VNN0_4)
/ADC0/AC_COUP1/FILTN: C154.2, R60.1
/ADC0/AC_COUP1/FILTP: C154.1, R59.2
/ADC0/AC_COUP1/IN_ATT_N: C153.1, R92.2, R100.2
/ADC0/AC_COUP1/IN_ATT_P: C152.1, R84.2, R100.1
/ADC0/AC_COUP1/OUTN: L14.1, R58.2, R60.2, R116.2, U8.31 (INDM)
/ADC0/AC_COUP1/OUTP: L13.2, R57.2, R59.1, R108.1, U8.30 (INDP)
/ADC0/AC_COUP1/PRN: C153.2, L14.2, R58.1
/ADC0/AC_COUP1/PRP: C152.2, L13.1, R57.1
/ADC0/AC_COUP2/FILTN: C146.2, R52.1
/ADC0/AC_COUP2/FILTP: C146.1, R51.2
/ADC0/AC_COUP2/IN_ATT_N: C145.1, R90.2, R98.2
/ADC0/AC_COUP2/IN_ATT_P: C144.1, R82.2, R98.1
/ADC0/AC_COUP2/OUTN: L10.1, R50.2, R52.2, R114.2, U8.27 (INCP)
/ADC0/AC_COUP2/OUTP: L9.2, R49.2, R51.1, R106.1, U8.26 (INCM)
/ADC0/AC_COUP2/PRN: C145.2, L10.2, R50.1
/ADC0/AC_COUP2/PRP: C144.2, L9.1, R49.1
/ADC0/AC_COUP3/FILTN: C106.2, R25.1
/ADC0/AC_COUP3/FILTP: C106.1, R24.2
/ADC0/AC_COUP3/IN_ATT_N: C105.1, R87.2, R95.2
/ADC0/AC_COUP3/IN_ATT_P: C104.1, R61.2, R95.1
/ADC0/AC_COUP3/OUTN: L4.1, R23.2, R25.2, R111.2, U8.11 (INBM)
/ADC0/AC_COUP3/OUTP: L3.2, R22.2, R24.1, R103.1, U8.10 (INBP)
/ADC0/AC_COUP3/PRN: C105.2, L4.2, R23.1
/ADC0/AC_COUP3/PRP: C104.2, L3.1, R22.1
/ADC0/AC_COUP4/FILTN: C228.2, R79.1
/ADC0/AC_COUP4/FILTP: C228.1, R78.2
/ADC0/AC_COUP4/IN_ATT_N: C227.1, R93.2, R101.2
/ADC0/AC_COUP4/IN_ATT_P: C226.1, R85.2, R101.1
/ADC0/AC_COUP4/OUTN: L16.1, R77.2, R79.2, R117.2, U8.7 (INAP)
/ADC0/AC_COUP4/OUTP: L15.2, R76.2, R78.1, R109.1, U8.6 (INAM)
/ADC0/AC_COUP4/PRN: C227.2, L16.2, R77.1
/ADC0/AC_COUP4/PRP: C226.2, L15.1, R76.1
/ADC0/CLK.N: C96.1, R19.1, U11.10 (CLK3A)
/ADC0/CLK.P: C95.1, R19.2, U11.9 (CLK3B)
/ADC0/CLK_AC_N: C96.2, U8.18 (CLKM)
/ADC0/CLK_AC_P: C95.2, U8.19 (CLKP)
/ADC0/DAN: C19.1, U8.48 (DAM)
/ADC0/DAP: C16.1, U8.47 (DAP)
/ADC0/DDN: C23.1, U8.38 (DDM)
/ADC0/DDP: C21.1, U8.37 (DDP)
/ADC0/IN1.N: R84.1, U6.13 (VOL2)
/ADC0/IN1.P: R92.1, U6.12 (VOH2)
/ADC0/IN2.N: R82.1, U6.16 (VOL1)
/ADC0/IN2.P: R90.1, U6.17 (VOH1)
/ADC0/IN3.N: R61.1, U12.13 (VOL2)
/ADC0/IN3.P: R87.1, U12.12 (VOH2)
/ADC0/IN4.N: R85.1, U12.16 (VOL1)
/ADC0/IN4.P: R93.1, U12.17 (VOH1)
/ADC0/MISO: U4.1x57 (B64_L20_P), U8.16 (SDOUT)
/ADC0/MOSI: U4.1x63 (B64_L23_P), U8.14 (SDATA)
/ADC0/RESET: U4.1x65 (B64_L18_N), U8.21 (RESET)
/ADC0/SCLK: U4.1x67 (B64_L18_P), U8.13 (SCLK)
/ADC0/SYNC.N: R20.2, U4.2x63 (B65_L1_P), U8.42 (SYNCM~)
/ADC0/SYNC.P: R20.1, U4.2x61 (B65_L1_N), U8.43 (SYNCP~)
/ADC0/VCM: C103.2, C143.2, C151.2, C225.2, R103.2, R106.2, R108.2, R109.2, R111.1, R114.1, R116.1, R117.1, U8.24 (VCM)
/ADC0/~CS: U4.1x61 (B64_L23_N), U8.15 (SEN)
/ADC1/AC_COUP1/FILTN: C150.2, R56.1
/ADC1/AC_COUP1/FILTP: C150.1, R55.2
/ADC1/AC_COUP1/IN_ATT_N: C149.1, R91.2, R99.2
/ADC1/AC_COUP1/IN_ATT_P: C148.1, R83.2, R99.1
/ADC1/AC_COUP1/OUTN: L12.1, R54.2, R56.2, R115.2, U7.31 (INDM)
/ADC1/AC_COUP1/OUTP: L11.2, R53.2, R55.1, R107.1, U7.30 (INDP)
/ADC1/AC_COUP1/PRN: C149.2, L12.2, R54.1
/ADC1/AC_COUP1/PRP: C148.2, L11.1, R53.1
/ADC1/AC_COUP2/FILTN: C131.2, R41.1
/ADC1/AC_COUP2/FILTP: C131.1, R40.2
/ADC1/AC_COUP2/IN_ATT_N: C130.1, R88.2, R96.2
/ADC1/AC_COUP2/IN_ATT_P: C129.1, R66.2, R96.1
/ADC1/AC_COUP2/OUTN: L6.1, R39.2, R41.2, R112.2, U7.27 (INCP)
/ADC1/AC_COUP2/OUTP: L5.2, R38.2, R40.1, R104.1, U7.26 (INCM)
/ADC1/AC_COUP2/PRN: C130.2, L6.2, R39.1
/ADC1/AC_COUP2/PRP: C129.2, L5.1, R38.1
/ADC1/AC_COUP3/FILTN: C30.2, R8.1
/ADC1/AC_COUP3/FILTP: C30.1, R7.2
/ADC1/AC_COUP3/IN_ATT_N: C29.1, R86.2, R94.2
/ADC1/AC_COUP3/IN_ATT_P: C28.1, R11.2, R94.1
/ADC1/AC_COUP3/OUTN: L2.1, R6.2, R8.2, R110.2, U7.11 (INBM)
/ADC1/AC_COUP3/OUTP: L1.2, R5.2, R7.1, R102.1, U7.10 (INBP)
/ADC1/AC_COUP3/PRN: C29.2, L2.2, R6.1
/ADC1/AC_COUP3/PRP: C28.2, L1.1, R5.1
/ADC1/AC_COUP4/FILTN: C142.2, R48.1
/ADC1/AC_COUP4/FILTP: C142.1, R47.2
/ADC1/AC_COUP4/IN_ATT_N: C141.1, R89.2, R97.2
/ADC1/AC_COUP4/IN_ATT_P: C140.1, R71.2, R97.1
/ADC1/AC_COUP4/OUTN: L8.1, R46.2, R48.2, R113.2, U7.7 (INAP)
/ADC1/AC_COUP4/OUTP: L7.2, R45.2, R47.1, R105.1, U7.6 (INAM)
/ADC1/AC_COUP4/PRN: C141.2, L8.2, R46.1
/ADC1/AC_COUP4/PRP: C140.2, L7.1, R45.1
/ADC1/CLK.N: C79.1, R16.1, U11.22 (CLK0A)
/ADC1/CLK.P: C78.1, R16.2, U11.21 (CLK0B)
/ADC1/CLK_AC_N: C79.2, U7.18 (CLKM)
/ADC1/CLK_AC_P: C78.2, U7.19 (CLKP)
/ADC1/DAN: C20.1, U7.48 (DAM)
/ADC1/DAP: C17.1, U7.47 (DAP)
/ADC1/DDN: C24.1, U7.38 (DDM)
/ADC1/DDP: C22.1, U7.37 (DDP)
/ADC1/IN1.N: R83.1, U13.13 (VOL2)
/ADC1/IN1.P: R91.1, U13.12 (VOH2)
/ADC1/IN2.N: R66.1, U13.16 (VOL1)
/ADC1/IN2.P: R88.1, U13.17 (VOH1)
/ADC1/IN3.N: R11.1, U14.13 (VOL2)
/ADC1/IN3.P: R86.1, U14.12 (VOH2)
/ADC1/IN4.N: R71.1, U14.16 (VOL1)
/ADC1/IN4.P: R89.1, U14.17 (VOH1)
/ADC1/MISO: U4.2x15 (B65_L17_N), U7.16 (SDOUT)
/ADC1/MOSI: U4.2x21 (B65_L16_N), U7.14 (SDATA)
/ADC1/RESET: U4.2x23 (B65_L16_P), U7.21 (RESET)
/ADC1/SCLK: U4.2x25 (B65_L10_N), U7.13 (SCLK)
/ADC1/SYNC.N: R17.2, U4.2x37 (B65_L2_P), U7.42 (SYNCM~)
/ADC1/SYNC.P: R17.1, U4.2x35 (B65_L2_N), U7.43 (SYNCP~)
/ADC1/VCM: C27.2, C128.2, C139.2, C147.2, R102.2, R104.2, R105.2, R107.2, R110.1, R112.1, R113.1, R115.1, U7.24 (VCM)
/ADC1/~CS: U4.2x17 (B65_L17_P), U7.15 (SEN)
/CLK/CLKINN: U11.1 (IN1), Y2.1
/CLK/CLKINP: U11.2 (IN2), Y2.3
/CLK/OUT1.N: C15.1, U11.18 (CLK1A)
/CLK/OUT1.P: C18.1, U11.17 (CLK1B)
/CLK/OUT2.N: C232.2, U11.14 (CLK2A)
/CLK/OUT2.P: C233.2, U11.13 (CLK2B)
/CLK/SCL: R44.2, U4.3x43 (B85_L8_P), U11.12 (SCL)
/CLK/SDA: R42.2, U4.3x41 (B85_L8_N), U11.19 (SDA)
/FPGA/ADC0_A_MGT_N: C16.2, U4.4x38 (225_RX1_N)
/FPGA/ADC0_A_MGT_P: C19.2, U4.4x40 (225_RX1_P)
/FPGA/ADC0_D_MGT_N: C21.2, U4.4x32 (225_RX0_N)
/FPGA/ADC0_D_MGT_P: C23.2, U4.4x34 (225_RX0_P)
/FPGA/ADC1_A_MGT_N: C17.2, U4.4x50 (225_RX3_N)
/FPGA/ADC1_A_MGT_P: C20.2, U4.4x52 (225_RX3_P)
/FPGA/ADC1_D_MGT_N: C24.2, U4.4x46 (225_RX2_P)
/FPGA/ADC1_D_MGT_P: C22.2, U4.4x44 (225_RX2_N)
/FPGA/DONE_LED_AN: D10.2 (A), R133.2
/FPGA/DONE_LED_CAT: D10.1 (K), Q2.3 (D)
/FPGA/ETH_REFCLKN: C26.1, Y1.5 (OUT-)
/FPGA/ETH_REFCLKP: C25.1, Y1.4 (OUT+)
/FPGA/ETH_REFCLK_MGT_N: C25.2, U4.4x26 (224_CLK0_N)
/FPGA/ETH_REFCLK_MGT_P: C26.2, U4.4x28 (224_CLK0_P)
/FPGA/FPGA_DONE: Q2.1 (G), U4.1x71 (FPGA_DONE)
/FPGA/HV+.SCL: J7.10, U4.2x62 (B84_L2_N)
/FPGA/HV+.SDA: J7.12, U4.2x64 (B84_L2_P)
/FPGA/HV-.SCL: J7.16, U4.2x72 (B84_L3_N)
/FPGA/HV-.SDA: J7.18, U4.2x74 (B84_L3_P)
/FPGA/JESD_CORECLK_AC_N: C232.1, U4.1x45 (B64_L14_N)
/FPGA/JESD_CORECLK_AC_P: C233.1, U4.1x47 (B64_L14_P)
/FPGA/JESD_REFCLK_MGT_N: C15.2, U4.4x25 (225_CLK0_N)
/FPGA/JESD_REFCLK_MGT_P: C18.2, U4.4x27 (225_CLK0_P)
/FPGA/P0.NEG1: U4.3x21 (B85_L1_N), U5.17 (NEG3)
/FPGA/P0.NEG2: U4.3x13 (B84_L7_P), U5.13 (NEG2)
/FPGA/P0.NEG3: U4.3x5 (B84_L12_N), U5.3 (NEG1)
/FPGA/P0.NEG4: U4.3x1 (B84_L8_N), U5.63 (NEG0)
/FPGA/P0.POS1: U4.3x23 (B85_L1_P), U5.18 (POS3)
/FPGA/P0.POS2: U4.3x15 (B84_L10_N), U5.14 (POS2)
/FPGA/P0.POS3: U4.3x7 (B84_L12_P), U5.4 (POS1)
/FPGA/P0.POS4: U4.3x3 (B84_L8_P), U5.64 (POS0)
/FPGA/P0.~OTP: R10.2, U4.3x25 (B85_L2_N), U5.20 (OTPN)
/FPGA/P1.NEG1: U4.3x22 (B85_L3_N), U9.17 (NEG3)
/FPGA/P1.NEG2: U4.3x12 (B84_L9_N), U9.13 (NEG2)
/FPGA/P1.NEG3: U4.3x6 (B84_L11_N), U9.3 (NEG1)
/FPGA/P1.NEG4: U4.3x2 (B84_L5_N), U9.63 (NEG0)
/FPGA/P1.POS1: U4.3x24 (B85_L3_P), U9.18 (POS3)
/FPGA/P1.POS2: U4.3x14 (B84_L9_P), U9.14 (POS2)
/FPGA/P1.POS3: U4.3x8 (B84_L11_P), U9.4 (POS1)
/FPGA/P1.POS4: U4.3x4 (B84_L5_P), U9.64 (POS0)
/FPGA/P1.~OTP: R27.2, U4.3x26 (B85_L6_N), U9.20 (OTPN)
/FPGA/PROGRAM_B: SW1.2 (B), U4.1x73 (PROGRAM_B)
/FPGA/PULSER_CLK: R9.1, U4.3x17 (B84_L10_P), U5.8 (CLK), U9.8 (CLK)
/FPGA/PULSER_OEN: R26.1, U4.3x11 (B84_L7_N), U5.6 (OEN), U9.6 (OEN)
/FPGA/RAMP.SCL: R43.2, U4.3x31 (B85_L4_N), U17.3 (SCL)
/FPGA/RAMP.SDA: R80.2, U4.3x33 (B85_L4_P), U17.4 (SDA)
/FPGA/RAMP_RST: Q1.1 (G), R127.2, U4.3x35 (B85_L11_N)
/FPGA/S0.AUX0: J6.7, U4.3x32 (B85_L5_N)
/FPGA/S0.AUX1: J6.8, U4.3x36 (B85_L9_N)
/FPGA/S0.AUX2: J6.10, U4.3x34 (B85_L5_P)
/FPGA/S0.CLK: J6.2, U4.3x37 (B85_L11_P)
/FPGA/S0.CLR: J6.4, U4.3x27 (B85_L2_P)
/FPGA/S0.DIN: J6.5, U4.3x28 (B85_L6_P)
/FPGA/S0.~LE: J6.1, U4.3x38 (B85_L9_P)
/FPGA/SFP.SCL: J4.5 (SCL), R34.2, U4.2x65 (B84_L6_N)
/FPGA/SFP.SDA: J4.4 (SDA), R33.2, U4.2x67 (B84_L6_P)
/FPGA/SFP_MOD_ABS: J4.6 (MOD_ABS), R32.2, U4.2x78 (B84_L4_P)
/FPGA/SFP_RDN: J4.12 (RD-), U4.4x2 (224_RX0_N)
/FPGA/SFP_RDP: J4.13 (RD+), U4.4x4 (224_RX0_P)
/FPGA/SFP_TDN: J4.19 (TD-), U4.4x9 (224_TX1_P)
/FPGA/SFP_TDP: J4.18 (TD+), U4.4x7 (224_TX1_N)
/FPGA/TCK: D1.6 (K), J3.1 (TCK), R1.2, U4.2x71 (FPGA_TCK)
/FPGA/TDI: D1.3 (K), J3.9 (TDI), R4.2, U4.2x73 (FPGA_TDI)
/FPGA/TDO: D2.6 (K), J3.3 (TDO), R3.2, U4.2x77 (FPGA_TDO)
/FPGA/TEST1: TP12.1 (1_1), U4.2x55 (B65_L6_N)
/FPGA/TEST2: TP13.1 (1_1), U4.2x53 (B65_L20_P)
/FPGA/TEST3: TP10.1 (1_1), U4.2x56 (B65_L7_N)
/FPGA/TEST4: TP11.1 (1_1), U4.2x54 (B65_L9_P)
/FPGA/TEST5: TP17.1 (1_1), U4.2x66 (B84_L1_N)
/FPGA/TEST6: TP16.1 (1_1), U4.2x68 (B84_L1_P)
/FPGA/TEST7: TP15.1 (1_1), U4.2x76 (B84_L4_N)
/FPGA/TMS: D2.3 (K), J3.5 (TMS), R2.2, U4.2x75 (FPGA_TMS)
/FPGA/UART_RX: J2.1, U4.3x75 (B86_L6_N)
/FPGA/UART_TX: J2.2, U4.3x77 (B86_L6_P)
/FPGA/USRLED0: Q3.1 (G), U4.3x44 (B85_L10_P)
/FPGA/USRLED0_AN: D11.2 (A), R136.2
/FPGA/USRLED0_CAT: D11.1 (K), Q3.3 (D)
/FPGA/USRLED1: Q4.1 (G), U4.3x42 (B85_L10_N)
/FPGA/USRLED1_AN: D12.2 (A), R137.2
/FPGA/USRLED1_CAT: D12.1 (K), Q4.3 (D)
/PULSER0/CNEG: C45.1, U5.40 (CNEG)
/PULSER0/CNF0: C40.2, U5.27 (CNF0_1), U5.54 (CNF0_2)
/PULSER0/CNF1: C41.2, U5.32 (CNF1_1), U5.49 (CNF1_2)
/PULSER0/CPF0: C38.2, U5.26 (CPF0_1), U5.55 (CPF0_2)
/PULSER0/CPF1: C39.2, U5.33 (CPF1_1), U5.48 (CPF1_2)
/PULSER0/CPOS: C36.1, U5.41 (CPOS)
/PULSER0/REN: C7.1, R140.2, U5.11 (REN)
/PULSER0/TO_PIEZO1: J5.9, U5.35 (TX3)
/PULSER0/TO_PIEZO2: J5.11, U5.39 (TX2)
/PULSER0/TO_PIEZO3: J5.13, U5.42 (TX1)
/PULSER0/TO_PIEZO4: J5.15, U5.46 (TX0)
/PULSER0/TO_VGA1: C57.1, U5.36 (RX3)
/PULSER0/TO_VGA2: C49.1, U5.38 (RX2)
/PULSER0/TO_VGA3: C164.1, U5.43 (RX1)
/PULSER0/TO_VGA4: C156.1, U5.45 (RX0)
/PULSER1/CNEG: C121.1, U9.40 (CNEG)
/PULSER1/CNF0: C116.2, U9.27 (CNF0_1), U9.54 (CNF0_2)
/PULSER1/CNF1: C117.2, U9.32 (CNF1_1), U9.49 (CNF1_2)
/PULSER1/CPF0: C114.2, U9.26 (CPF0_1), U9.55 (CPF0_2)
/PULSER1/CPF1: C115.2, U9.33 (CPF1_1), U9.48 (CPF1_2)
/PULSER1/CPOS: C112.1, U9.41 (CPOS)
/PULSER1/REN: C248.1, R141.2, U9.11 (REN)
/PULSER1/TO_PIEZO1: J5.1, U9.35 (TX3)
/PULSER1/TO_PIEZO2: J5.3, U9.39 (TX2)
/PULSER1/TO_PIEZO3: J5.5, U9.42 (TX1)
/PULSER1/TO_PIEZO4: J5.7, U9.46 (TX0)
/PULSER1/TO_VGA1: C185.1, U9.36 (RX3)
/PULSER1/TO_VGA2: C177.1, U9.38 (RX2)
/PULSER1/TO_VGA3: C213.1, U9.43 (RX1)
/PULSER1/TO_VGA4: C205.1, U9.45 (RX0)
/RAMP/3V3_ISO: C4.1, C250.1, R18.1, U17.1 (VDD), U18.5 (VCC)
/RAMP/3V3_REF_R: D6.2 (A), R128.1
/RAMP/AMP_FB: C9.2, C10.2, R81.2, U10.3 (GND), U18.1 (OUTPUT), U18.4 (-)
/RAMP/DIS_D: Q1.3 (D), R126.2
/RAMP/GAIN: C242.1, C243.1, C244.1, C245.1, R81.1, TP3.1 (1_1), U6.10 (GAIN), U12.10 (GAIN), U13.10 (GAIN), U14.10 (GAIN)
/RAMP/GAIN_CLMP1: D3.1 (K), D4.2 (A)
/RAMP/GAIN_CLMP2: D4.1 (K), D5.2 (A)
/RAMP/GAIN_PREAMP: C137.1, D3.2 (A), R126.1, U17.5 (B), U18.3 (+)
/RAMP/RAMP_POT: R21.2, U17.6 (W)
/RAMP/REF_IN: C10.1, D6.1 (K), U10.1 (IN)
/RAMP/REF_OUT: C9.1, R21.1, U10.2 (OUT)
/SFP/SFP_RS0: J4.7 (RS0), R28.2, R29.1
/SFP/SFP_RS1: J4.9 (RS1), R30.2, R31.1
/SFP/SFP_RX_LOS: J4.8 (RX_LOS), R36.2, TP8.1 (1_1)
/SFP/SFP_TX_DISABLE: J4.3 (TX_DISABLE), R35.1
/SFP/SFP_TX_FAULT: J4.2 (TX_FAULT), R37.2, TP9.1 (1_1)
/VGA0/ENB: R134.2, U6.18 (ENB)
/VGA0/FB1: C51.2, R14.1
/VGA0/FB2: C63.2, R15.1
/VGA0/HI~LO: R12.2, R13.1, U6.19 (HILO)
/VGA0/IN1_AC: C49.2, R118.1
/VGA0/IN2_AC: C57.2, R122.1
/VGA0/INH1: C50.1, C51.1, R118.2, U6.27 (INH1)
/VGA0/INH2: C59.1, C63.1, R122.2, U6.2 (INH2)
/VGA0/LMD1: C52.1, U6.28 (LMD1)
/VGA0/LMD2: C65.1, U6.1 (LMD2)
/VGA0/LON1: C54.1, R14.2, U6.25 (LON1)
/VGA0/LON2: C67.1, R15.2, U6.4 (LON2)
/VGA0/LOP1: C55.1, U6.24 (LOP1)
/VGA0/LOP2: C68.1, U6.5 (LOP2)
/VGA0/RCLMP: C48.1, R129.1, U6.11 (RCLMP)
/VGA0/VCM1: C53.1, C238.1, U6.20 (VCM1)
/VGA0/VCM2: C66.1, C234.1, U6.9 (VCM2)
/VGA0/VIN1: C54.2, U6.21 (VIN1)
/VGA0/VIN2: C67.2, U6.8 (VIN2)
/VGA0/VIP1: C55.2, U6.22 (VIP1)
/VGA0/VIP2: C68.2, U6.7 (VIP2)
/VGA1/ENB: R135.2, U12.18 (ENB)
/VGA1/FB1: C158.2, R64.1
/VGA1/FB2: C170.2, R65.1
/VGA1/HI~LO: R62.2, R63.1, U12.19 (HILO)
/VGA1/IN1_AC: C156.2, R119.1
/VGA1/IN2_AC: C164.2, R123.1
/VGA1/INH1: C157.1, C158.1, R119.2, U12.27 (INH1)
/VGA1/INH2: C166.1, C170.1, R123.2, U12.2 (INH2)
/VGA1/LMD1: C159.1, U12.28 (LMD1)
/VGA1/LMD2: C172.1, U12.1 (LMD2)
/VGA1/LON1: C161.1, R64.2, U12.25 (LON1)
/VGA1/LON2: C174.1, R65.2, U12.4 (LON2)
/VGA1/LOP1: C162.1, U12.24 (LOP1)
/VGA1/LOP2: C175.1, U12.5 (LOP2)
/VGA1/RCLMP: C155.1, R130.1, U12.11 (RCLMP)
/VGA1/VCM1: C160.1, C239.1, U12.20 (VCM1)
/VGA1/VCM2: C173.1, C235.1, U12.9 (VCM2)
/VGA1/VIN1: C161.2, U12.21 (VIN1)
/VGA1/VIN2: C174.2, U12.8 (VIN2)
/VGA1/VIP1: C162.2, U12.22 (VIP1)
/VGA1/VIP2: C175.2, U12.7 (VIP2)
/VGA2/ENB: R138.2, U13.18 (ENB)
/VGA2/FB1: C179.2, R69.1
/VGA2/FB2: C191.2, R70.1
/VGA2/HI~LO: R67.2, R68.1, U13.19 (HILO)
/VGA2/IN1_AC: C177.2, R120.1
/VGA2/IN2_AC: C185.2, R124.1
/VGA2/INH1: C178.1, C179.1, R120.2, U13.27 (INH1)
/VGA2/INH2: C187.1, C191.1, R124.2, U13.2 (INH2)
/VGA2/LMD1: C180.1, U13.28 (LMD1)
/VGA2/LMD2: C193.1, U13.1 (LMD2)
/VGA2/LON1: C182.1, R69.2, U13.25 (LON1)
/VGA2/LON2: C195.1, R70.2, U13.4 (LON2)
/VGA2/LOP1: C183.1, U13.24 (LOP1)
/VGA2/LOP2: C196.1, U13.5 (LOP2)
/VGA2/RCLMP: C176.1, R131.1, U13.11 (RCLMP)
/VGA2/VCM1: C181.1, C240.1, U13.20 (VCM1)
/VGA2/VCM2: C194.1, C236.1, U13.9 (VCM2)
/VGA2/VIN1: C182.2, U13.21 (VIN1)
/VGA2/VIN2: C195.2, U13.8 (VIN2)
/VGA2/VIP1: C183.2, U13.22 (VIP1)
/VGA2/VIP2: C196.2, U13.7 (VIP2)
/VGA3/ENB: R139.2, U14.18 (ENB)
/VGA3/FB1: C207.2, R74.1
/VGA3/FB2: C219.2, R75.1
/VGA3/HI~LO: R72.2, R73.1, U14.19 (HILO)
/VGA3/IN1_AC: C205.2, R121.1
/VGA3/IN2_AC: C213.2, R125.1
/VGA3/INH1: C206.1, C207.1, R121.2, U14.27 (INH1)
/VGA3/INH2: C215.1, C219.1, R125.2, U14.2 (INH2)
/VGA3/LMD1: C208.1, U14.28 (LMD1)
/VGA3/LMD2: C221.1, U14.1 (LMD2)
/VGA3/LON1: C210.1, R74.2, U14.25 (LON1)
/VGA3/LON2: C223.1, R75.2, U14.4 (LON2)
/VGA3/LOP1: C211.1, U14.24 (LOP1)
/VGA3/LOP2: C224.1, U14.5 (LOP2)
/VGA3/RCLMP: C204.1, R132.1, U14.11 (RCLMP)
/VGA3/VCM1: C209.1, C241.1, U14.20 (VCM1)
/VGA3/VCM2: C222.1, C237.1, U14.9 (VCM2)
/VGA3/VIN1: C210.2, U14.21 (VIN1)
/VGA3/VIN2: C223.2, U14.8 (VIN2)
/VGA3/VIP1: C211.2, U14.22 (VIP1)
/VGA3/VIP2: C224.2, U14.7 (VIP2)
GND: C1.2, C2.2, C3.2, C4.2, C5.2, C6.2, C7.2, C8.2, C11.2, C12.2, C13.2, C14.2, C27.1, C31.2, C32.2, C33.2, C34.2, C35.2, C36.2, C37.2, C42.2, C43.2, C44.2, C45.2, C46.2, C47.2, C48.2, C50.2, C52.2, C53.2, C56.2, C58.2, C59.2, C60.2, C61.2, C62.2, C64.2, C65.2, C66.2, C69.2, C70.2, C71.2, C72.2, C73.2, C74.2, C75.2, C76.2, C77.2, C80.2, C81.2, C82.2, C83.2, C84.2, C85.2, C86.2, C87.2, C88.2, C89.2, C90.2, C91.2, C92.2, C93.2, C94.2, C97.2, C98.2, C99.2, C100.2, C101.2, C102.2, C103.1, C107.2, C108.2, C109.2, C110.2, C111.2, C112.2, C113.2, C118.2, C119.2, C120.2, C121.2, C122.2, C123.2, C124.2, C125.2, C126.2, C127.2, C128.1, C132.2, C133.2, C134.2, C135.2, C136.2, C137.2, C138.2, C139.1, C143.1, C147.1, C151.1, C155.2, C157.2, C159.2, C160.2, C163.2, C165.2, C166.2, C167.2, C168.2, C169.2, C171.2, C172.2, C173.2, C176.2, C178.2, C180.2, C181.2, C184.2, C186.2, C187.2, C188.2, C189.2, C190.2, C192.2, C193.2, C194.2, C197.2, C198.2, C199.2, C200.2, C201.2, C202.2, C203.1, C204.2, C206.2, C208.2, C209.2, C212.2, C214.2, C215.2, C216.2, C217.2, C218.2, C220.2, C221.2, C222.2, C225.1, C229.2, C230.2, C231.2, C234.2, C235.2, C236.2, C237.2, C238.2, C239.2, C240.2, C241.2, C242.2, C243.2, C244.2, C245.2, C246.2, C247.2, C248.2, C249.2, C250.2, D1.1 (A), D1.4 (A), D2.1 (A), D2.4 (A), D5.1 (K), J1.2, J2.3, J3.2 (GND), J3.10 (GND), J4.1 (VeeT), J4.10 (VeeR), J4.11 (VeeR), J4.14 (VeeR), J4.17 (VeeT), J4.20 (VeeT), J4.CAGE, J5.2, J5.4, J5.6, J5.8, J5.10, J5.12, J5.14, J5.16, J5.P1, J5.P2, J6.3, J6.6, J6.9, J6.12, J7.2, J7.4, J7.6, J7.8, J7.14, J7.20, J7.22, J7.24, Q1.2 (S), Q2.2 (S), Q3.2 (S), Q4.2 (S), R9.2, R13.2, R26.2, R29.2, R31.2, R35.2, R63.2, R68.2, R73.2, R129.2, R130.2, R131.2, R132.2, SW1.1 (A), TP4.1 (1_1), TP6.1 (1_1), TP14.1 (1_1), U1.2 (GND), U2.2 (GND), U4.1x9 (GND), U4.1x10 (GND), U4.1x19 (GND), U4.1x20 (GND), U4.1x29 (GND), U4.1x30 (GND), U4.1x39 (GND), U4.1x40 (GND), U4.1x49 (GND), U4.1x50 (GND), U4.1x59 (GND), U4.1x60 (GND), U4.1x69 (GND), U4.1x70 (GND), U4.2x9 (GND), U4.2x10 (GND), U4.2x19 (GND), U4.2x20 (GND), U4.2x29 (GND), U4.2x30 (GND), U4.2x39 (GND), U4.2x40 (GND), U4.2x49 (GND), U4.2x50 (GND), U4.2x59 (GND), U4.2x60 (GND), U4.2x69 (GND), U4.2x70 (GND), U4.3x9 (GND), U4.3x10 (GND), U4.3x19 (GND), U4.3x20 (GND), U4.3x29 (GND), U4.3x30 (GND), U4.3x39 (GND), U4.3x40 (GND), U4.3x49 (GND), U4.3x50 (GND), U4.3x59 (GND), U4.3x60 (GND), U4.3x69 (GND), U4.3x70 (GND), U4.4x5 (GND), U4.4x6 (GND), U4.4x11 (GND), U4.4x12 (GND), U4.4x17 (GND), U4.4x18 (GND), U4.4x23 (GND), U4.4x24 (GND), U4.4x29 (GND), U4.4x30 (GND), U4.4x35 (GND), U4.4x36 (GND), U4.4x41 (GND), U4.4x42 (GND), U4.4x47 (GND), U4.4x48 (GND), U4.4x53 (GND), U4.4x54 (GND), U4.4x59 (GND), U4.4x60 (GND), U4.4x65 (GND), U4.4x66 (GND), U4.4x71 (GND), U4.4x72 (GND), U4.4x77 (GND), U4.4x78 (GND), U5.1 (CWIN0), U5.2 (SEL1), U5.5 (CWIN1), U5.9 (GND_1), U5.12 (SEL2), U5.15 (CWIN2), U5.16 (SEL3), U5.19 (CWIN3), U5.22 (GND_2), U5.37 (RGND_1), U5.44 (RGND_2), U5.59 (GND_3), U5.61 (MODE), U5.62 (SEL0), U5.65 (VSUB), U6.6 (COM2), U6.14 (COMM), U6.23 (COM1), U7.49 (GND_PAD), U8.49 (GND_PAD), U9.1 (CWIN0), U9.2 (SEL1), U9.5 (CWIN1), U9.9 (GND_1), U9.12 (SEL2), U9.15 (CWIN2), U9.16 (SEL3), U9.19 (CWIN3), U9.22 (GND_2), U9.37 (RGND_1), U9.44 (RGND_2), U9.59 (GND_3), U9.61 (MODE), U9.62 (SEL0), U9.65 (VSUB), U11.23 (RSVD_GND), U11.25 (GND), U12.6 (COM2), U12.14 (COMM), U12.23 (COM1), U13.6 (COM2), U13.14 (COMM), U13.23 (COM1), U14.6 (COM2), U14.14 (COMM), U14.23 (COM1), U15.1 (ADJ/GND), U16.2 (GND), U17.2 (VSS), U18.2 (VDD), Y1.3 (GND), Y2.2 (GND), Y2.4 (GND)
