rosalyntg/ultrasound/fpga/us/us.srcs/sources_1/new/net.sv

`timescale 1ns / 1ps
//////////////////////////////////////////////////////////////////////////////////
// Company:
// Engineer:
//
// Create Date: 07/03/2026 11:56:36 PM
// Design Name:
// Module Name: net
// Project Name:
// Target Devices:
// Tool Versions:
// Description:
//   SystemVerilog implementation of the 10G UDP/IP network stack.  Bundles:
//
//       XGMII <-> eth_mac_10g_fifo <-> eth_axis_rx/tx <-> udp_complete_64
//
//   and exposes:
//       * the 10G XGMII PHY interface (to the transceiver)
//       * the UDP frame input/output interface (application side)
//
//   The IP-frame side of udp_complete_64 is not exposed: the IP input is
//   tied off and the IP output is discarded, so all non-UDP traffic is
//   dropped.  Configuration (MAC/IP/gateway/subnet) is exposed as ports.
//
//   net_wrapper.v is a thin Verilog wrapper around this module intended for
//   instantiation in a Vivado block design (Module Reference).
//
// Dependencies:
//   verilog-ethernet: eth_mac_10g_fifo, eth_axis_rx, eth_axis_tx,
//                     udp_complete_64 (+ their sub-modules)
//
// Revision:
// Revision 0.01 - File Created
// Additional Comments:
//
//////////////////////////////////////////////////////////////////////////////////

interface udpaux_if;
    logic        hdr_valid;
    logic        hdr_ready;
    logic        [5:0]  ip_dscp;
    logic        [1:0]  ip_ecn;
    logic        [7:0]  ip_ttl;
    logic        [31:0] ip_source_ip;
    logic        [31:0] ip_dest_ip;
    logic        [15:0] source_port;
    logic        [15:0] dest_port;
endinterface

module net #
(
    parameter C_M_AXI_ADDR_WIDTH = 32,
    parameter C_M_AXI_DATA_WIDTH = 32
)
(
    /*
     * Application / logic clock domain
     */
    input  logic        logic_clk,
    input  logic        logic_rst,

    /*
     * XGMII 10G interface (transceiver clock domains)
     */
    input  logic        xgmii_rx_clk,
    input  logic        xgmii_rx_rst,
    input  logic        xgmii_tx_clk,
    input  logic        xgmii_tx_rst,
    input  logic [63:0] xgmii_rxd,
    input  logic [7:0]  xgmii_rxc,
    output logic [63:0] xgmii_txd,
    output logic [7:0]  xgmii_txc,

    /*
     * Status
     */
    output logic        rx_error_bad_frame,
    output logic        rx_error_bad_fcs,
    output logic        ip_rx_busy,
    output logic        ip_tx_busy,
    output logic        udp_rx_busy,
    output logic        udp_tx_busy,

    /*
     * Configuration
     */
    input  logic [47:0] local_mac,
    input  logic [31:0] local_ip,
    input  logic [31:0] remote_ip,
    input  logic [31:0] gateway_ip,
    input  logic [31:0] subnet_mask,
    input  logic        clear_arp_cache,

    output logic xfcp_rx_tvalid,
    input logic xfcp_rx_tready,
    output logic [7:0] xfcp_rx_tdata,
    output logic xfcp_rx_tlast,

    input logic xfcp_tx_tvalid,
    output logic xfcp_tx_tready,
    input logic [7:0] xfcp_tx_tdata,
    input logic xfcp_tx_tlast,

    output logic [63:0] udp_tx_tdata,
    output logic [7:0] udp_tx_tkeep,
    output logic udp_tx_tvalid,
    output logic udp_tx_tready,
    output logic udp_tx_tlast,

    output logic [63:0] udp_rx_tdata,
    output logic udp_rx_tready,
    output logic udp_rx_tlast,
    output logic [7:0] udp_rx_tkeep,
    output logic udp_rx_tvalid,

    output logic udp_header_valid,
    output logic [15:0] udp_header_dst_port,

    input logic [63:0] s_data_tdata,
    output logic s_data_tready,
    input logic s_data_tlast,
    input logic [7:0] s_data_tkeep,
    input logic s_data_tvalid
);

// ---------------------------------------------------------------------------
// Internal nets
// ---------------------------------------------------------------------------

// AXI stream between MAC and eth_axis_rx/tx (logic_clk domain)
logic [63:0] mac_rx_axis_tdata;
logic [7:0]  mac_rx_axis_tkeep;
logic        mac_rx_axis_tvalid;
logic        mac_rx_axis_tready;
logic        mac_rx_axis_tlast;
logic        mac_rx_axis_tuser;

logic [63:0] mac_tx_axis_tdata;
logic [7:0]  mac_tx_axis_tkeep;
logic        mac_tx_axis_tvalid;
logic        mac_tx_axis_tready;
logic        mac_tx_axis_tlast;
logic        mac_tx_axis_tuser;

// Ethernet frame between eth_axis_rx/tx and udp_complete_64
logic        rx_eth_hdr_valid;
logic        rx_eth_hdr_ready;
logic [47:0] rx_eth_dest_mac;
logic [47:0] rx_eth_src_mac;
logic [15:0] rx_eth_type;
logic [63:0] rx_eth_payload_axis_tdata;
logic [7:0]  rx_eth_payload_axis_tkeep;
logic        rx_eth_payload_axis_tvalid;
logic        rx_eth_payload_axis_tready;
logic        rx_eth_payload_axis_tlast;
logic        rx_eth_payload_axis_tuser;

// logic        tx_eth_hdr_valid;
// logic        tx_eth_hdr_ready;
logic [47:0] tx_eth_dest_mac;
logic [47:0] tx_eth_src_mac;
logic [15:0] tx_eth_type;
logic [63:0] tx_eth_payload_axis_tdata;
logic [7:0]  tx_eth_payload_axis_tkeep;
logic        tx_eth_payload_axis_tvalid;
logic        tx_eth_payload_axis_tready;
logic        tx_eth_payload_axis_tlast;
logic        tx_eth_payload_axis_tuser;

// ---------------------------------------------------------------------------
// 10G Ethernet MAC with FIFOs (crosses XGMII rx/tx clocks -> logic_clk)
// ---------------------------------------------------------------------------
eth_mac_10g_fifo #(
)
eth_mac_10g_fifo_inst (
    .rx_clk(xgmii_rx_clk),
    .rx_rst(xgmii_rx_rst),
    .tx_clk(xgmii_tx_clk),
    .tx_rst(xgmii_tx_rst),
    .logic_clk(logic_clk),
    .logic_rst(logic_rst),
    .ptp_sample_clk(1'b0),

    // AXI input (TX)
    .tx_axis_tdata(mac_tx_axis_tdata),
    .tx_axis_tkeep(mac_tx_axis_tkeep),
    .tx_axis_tvalid(mac_tx_axis_tvalid),
    .tx_axis_tready(mac_tx_axis_tready),
    .tx_axis_tlast(mac_tx_axis_tlast),
    .tx_axis_tuser(mac_tx_axis_tuser),

    // Transmit timestamp (unused)
    .m_axis_tx_ptp_ts_96(),
    .m_axis_tx_ptp_ts_tag(),
    .m_axis_tx_ptp_ts_valid(),
    .m_axis_tx_ptp_ts_ready(1'b0),

    // AXI output (RX)
    .rx_axis_tdata(mac_rx_axis_tdata),
    .rx_axis_tkeep(mac_rx_axis_tkeep),
    .rx_axis_tvalid(mac_rx_axis_tvalid),
    .rx_axis_tready(mac_rx_axis_tready),
    .rx_axis_tlast(mac_rx_axis_tlast),
    .rx_axis_tuser(mac_rx_axis_tuser),

    // XGMII
    .xgmii_rxd(xgmii_rxd),
    .xgmii_rxc(xgmii_rxc),
    .xgmii_txd(xgmii_txd),
    .xgmii_txc(xgmii_txc),

    // Status
    .tx_error_underflow(),
    .tx_fifo_overflow(),
    .tx_fifo_bad_frame(),
    .tx_fifo_good_frame(),
    .rx_error_bad_frame(rx_error_bad_frame),
    .rx_error_bad_fcs(rx_error_bad_fcs),
    .rx_fifo_overflow(),
    .rx_fifo_bad_frame(),
    .rx_fifo_good_frame(),

    // PTP clock (unused)
    .ptp_ts_96(96'd0),
    .ptp_ts_step(1'b0),

    // Configuration
    .cfg_ifg(8'd12),
    .cfg_tx_enable(1'b1),
    .cfg_rx_enable(1'b1)
);

// ---------------------------------------------------------------------------
// AXI stream <-> Ethernet frame conversion
// ---------------------------------------------------------------------------
eth_axis_rx #(
    .DATA_WIDTH(64)
)
eth_axis_rx_inst (
    .clk(logic_clk),
    .rst(logic_rst),
    // AXI input
    .s_axis_tdata(mac_rx_axis_tdata),
    .s_axis_tkeep(mac_rx_axis_tkeep),
    .s_axis_tvalid(mac_rx_axis_tvalid),
    .s_axis_tready(mac_rx_axis_tready),
    .s_axis_tlast(mac_rx_axis_tlast),
    .s_axis_tuser(mac_rx_axis_tuser),
    // Ethernet frame output
    .m_eth_hdr_valid(rx_eth_hdr_valid),
    .m_eth_hdr_ready(rx_eth_hdr_ready),
    .m_eth_dest_mac(rx_eth_dest_mac),
    .m_eth_src_mac(rx_eth_src_mac),
    .m_eth_type(rx_eth_type),
    .m_eth_payload_axis_tdata(rx_eth_payload_axis_tdata),
    .m_eth_payload_axis_tkeep(rx_eth_payload_axis_tkeep),
    .m_eth_payload_axis_tvalid(rx_eth_payload_axis_tvalid),
    .m_eth_payload_axis_tready(rx_eth_payload_axis_tready),
    .m_eth_payload_axis_tlast(rx_eth_payload_axis_tlast),
    .m_eth_payload_axis_tuser(rx_eth_payload_axis_tuser),
    // Status
    .busy(),
    .error_header_early_termination()
);

eth_axis_tx #(
    .DATA_WIDTH(64)
)
eth_axis_tx_inst (
    .clk(logic_clk),
    .rst(logic_rst),
    // Ethernet frame input
    .s_eth_hdr_valid(tx_eth_hdr_valid),
    .s_eth_hdr_ready(tx_eth_hdr_ready),
    .s_eth_dest_mac(tx_eth_dest_mac),
    .s_eth_src_mac(tx_eth_src_mac),
    .s_eth_type(tx_eth_type),
    .s_eth_payload_axis_tdata(tx_eth_payload_axis_tdata),
    .s_eth_payload_axis_tkeep(tx_eth_payload_axis_tkeep),
    .s_eth_payload_axis_tvalid(tx_eth_payload_axis_tvalid),
    .s_eth_payload_axis_tready(tx_eth_payload_axis_tready),
    .s_eth_payload_axis_tlast(tx_eth_payload_axis_tlast),
    .s_eth_payload_axis_tuser(tx_eth_payload_axis_tuser),
    // AXI output
    .m_axis_tdata(mac_tx_axis_tdata),
    .m_axis_tkeep(mac_tx_axis_tkeep),
    .m_axis_tvalid(mac_tx_axis_tvalid),
    .m_axis_tready(mac_tx_axis_tready),
    .m_axis_tlast(mac_tx_axis_tlast),
    .m_axis_tuser(mac_tx_axis_tuser),
    // Status
    .busy()
);



taxi_axis_if #(.DATA_W(64), .LAST_EN(1), .USER_EN(1), .USER_W(1)) xfcp_rx(), xfcp_tx();

logic [15:0] m_udp_dest_port;
logic m_udp_payload_axis_tvalid;


assign xfcp_rx.tvalid = m_udp_payload_axis_tvalid && m_udp_dest_port == 16'd8001;

udpaux_if udp_tx(), udp_xfcp(), udp_adc();
taxi_axis_if #(.DATA_W(64), .LAST_EN(1), .USER_EN(0)) udp_tx_data();

// Gated payload streams between the sources and udp_arb_mux: the generators
// hold beats back until their header handshake with the mux has completed.
logic xfcp_mux_tvalid, xfcp_mux_tready;
logic adc_mux_tvalid, adc_mux_tready;

// Watches the 64-bit stream the mux actually consumes (after the width
// adapter), not the 8-bit xfcp_tx_* stream feeding it.
udp_hdr_valid_gen udp_hdr_valid_gen_xfcp (
    .clk(logic_clk),
    .rst(logic_rst),
    .s_axis_tvalid(xfcp_tx.tvalid),
    .s_axis_tready(xfcp_tx.tready),
    .s_axis_tlast(xfcp_tx.tlast),
    .m_axis_tvalid(xfcp_mux_tvalid),
    .m_axis_tready(xfcp_mux_tready),
    .hdr_ready(udp_xfcp.hdr_ready),
    .hdr_valid(udp_xfcp.hdr_valid)
);

assign udp_xfcp.ip_dscp = 1'b0;
assign udp_xfcp.ip_ecn = 1'b0;
assign udp_xfcp.ip_ttl = 8'd64;
assign udp_xfcp.ip_source_ip = local_ip;
assign udp_xfcp.ip_dest_ip = remote_ip;
assign udp_xfcp.source_port = 16'd8001;
assign udp_xfcp.dest_port = 16'd8001;

udp_hdr_valid_gen udp_hdr_valid_gen_adc (
    .clk(logic_clk),
    .rst(logic_rst),
    .s_axis_tvalid(s_data_tvalid),
    .s_axis_tready(s_data_tready),
    .s_axis_tlast(s_data_tlast),
    .m_axis_tvalid(adc_mux_tvalid),
    .m_axis_tready(adc_mux_tready),
    .hdr_ready(udp_adc.hdr_ready),
    .hdr_valid(udp_adc.hdr_valid)
);

assign udp_adc.ip_dscp = 1'b0;
assign udp_adc.ip_ecn = 1'b0;
assign udp_adc.ip_ttl = 8'd64;
assign udp_adc.ip_source_ip = local_ip;
assign udp_adc.ip_dest_ip = remote_ip;
assign udp_adc.source_port = 16'd8002;
assign udp_adc.dest_port = 16'd8002;


// ---------------------------------------------------------------------------
// UDP/IP stack.  IP frame side is not exposed:
//   - IP input tied off (no raw IP injection)
//   - IP output discarded / ready held high (drop non-UDP IP traffic)
// ---------------------------------------------------------------------------
udp_complete_64 #(
//    .ARP_CACHE_ADDR_WIDTH(ARP_CACHE_ADDR_WIDTH),
//    .ARP_REQUEST_RETRY_COUNT(ARP_REQUEST_RETRY_COUNT),
//    .ARP_REQUEST_RETRY_INTERVAL(ARP_REQUEST_RETRY_INTERVAL),
//    .ARP_REQUEST_TIMEOUT(ARP_REQUEST_TIMEOUT),
   .UDP_CHECKSUM_GEN_ENABLE(1)
)
udp_complete_inst (
    .clk(logic_clk),
    .rst(logic_rst),
    // Ethernet frame input (from eth_axis_rx)
    .s_eth_hdr_valid(rx_eth_hdr_valid),
    .s_eth_hdr_ready(rx_eth_hdr_ready),
    .s_eth_dest_mac(rx_eth_dest_mac),
    .s_eth_src_mac(rx_eth_src_mac),
    .s_eth_type(rx_eth_type),
    .s_eth_payload_axis_tdata(rx_eth_payload_axis_tdata),
    .s_eth_payload_axis_tkeep(rx_eth_payload_axis_tkeep),
    .s_eth_payload_axis_tvalid(rx_eth_payload_axis_tvalid),
    .s_eth_payload_axis_tready(rx_eth_payload_axis_tready),
    .s_eth_payload_axis_tlast(rx_eth_payload_axis_tlast),
    .s_eth_payload_axis_tuser(rx_eth_payload_axis_tuser),
    // Ethernet frame output (to eth_axis_tx)
    .m_eth_hdr_valid(tx_eth_hdr_valid),
    .m_eth_hdr_ready(tx_eth_hdr_ready),
    .m_eth_dest_mac(tx_eth_dest_mac),
    .m_eth_src_mac(tx_eth_src_mac),
    .m_eth_type(tx_eth_type),
    .m_eth_payload_axis_tdata(tx_eth_payload_axis_tdata),
    .m_eth_payload_axis_tkeep(tx_eth_payload_axis_tkeep),
    .m_eth_payload_axis_tvalid(tx_eth_payload_axis_tvalid),
    .m_eth_payload_axis_tready(tx_eth_payload_axis_tready),
    .m_eth_payload_axis_tlast(tx_eth_payload_axis_tlast),
    .m_eth_payload_axis_tuser(tx_eth_payload_axis_tuser),
    // IP frame input (unused - tied off)
    .s_ip_hdr_valid(1'b0),
    .s_ip_hdr_ready(),
    .s_ip_dscp(6'd0),
    .s_ip_ecn(2'd0),
    .s_ip_length(16'd0),
    .s_ip_ttl(8'd0),
    .s_ip_protocol(8'd0),
    .s_ip_source_ip(32'd0),
    .s_ip_dest_ip(32'd0),
    .s_ip_payload_axis_tdata(64'd0),
    .s_ip_payload_axis_tkeep(8'd0),
    .s_ip_payload_axis_tvalid(1'b0),
    .s_ip_payload_axis_tready(),
    .s_ip_payload_axis_tlast(1'b0),
    .s_ip_payload_axis_tuser(1'b0),
    // IP frame output (unused - discarded, ready held high)
    .m_ip_hdr_valid(),
    .m_ip_hdr_ready(1'b1),
    .m_ip_eth_dest_mac(),
    .m_ip_eth_src_mac(),
    .m_ip_eth_type(),
    .m_ip_version(),
    .m_ip_ihl(),
    .m_ip_dscp(),
    .m_ip_ecn(),
    .m_ip_length(),
    .m_ip_identification(),
    .m_ip_flags(),
    .m_ip_fragment_offset(),
    .m_ip_ttl(),
    .m_ip_protocol(),
    .m_ip_header_checksum(),
    .m_ip_source_ip(),
    .m_ip_dest_ip(),
    .m_ip_payload_axis_tdata(),
    .m_ip_payload_axis_tkeep(),
    .m_ip_payload_axis_tvalid(),
    .m_ip_payload_axis_tready(1'b1),
    .m_ip_payload_axis_tlast(),
    .m_ip_payload_axis_tuser(),
    // UDP frame input (application side)

    .s_udp_hdr_valid(udp_tx.hdr_valid),
    .s_udp_hdr_ready(udp_tx.hdr_ready),
    .s_udp_ip_dscp(udp_tx.ip_dscp),
    .s_udp_ip_ecn(udp_tx.ip_ecn),
    .s_udp_ip_ttl(udp_tx.ip_ttl),
    .s_udp_ip_source_ip(udp_tx.ip_source_ip),
    .s_udp_ip_dest_ip(udp_tx.ip_dest_ip),
    .s_udp_source_port(udp_tx.source_port),
    .s_udp_dest_port(udp_tx.dest_port),
    .s_udp_length(), // computed by udp_complete_64
    .s_udp_checksum(), // computed by udp_complete_64
    .s_udp_payload_axis_tdata(udp_tx_data.tdata),
    .s_udp_payload_axis_tkeep(udp_tx_data.tkeep),
    .s_udp_payload_axis_tvalid(udp_tx_data.tvalid),
    .s_udp_payload_axis_tready(udp_tx_data.tready),
    .s_udp_payload_axis_tlast(udp_tx_data.tlast),
    .s_udp_payload_axis_tuser(udp_tx_data.tuser),
    // UDP frame output (application side)
    .m_udp_hdr_valid(),
    .m_udp_hdr_ready(1'b1),
    .m_udp_eth_dest_mac(),
    .m_udp_eth_src_mac(),
    .m_udp_eth_type(),
    .m_udp_ip_version(),
    .m_udp_ip_ihl(),
    .m_udp_ip_dscp(),
    .m_udp_ip_ecn(),
    .m_udp_ip_length(),
    .m_udp_ip_identification(),
    .m_udp_ip_flags(),
    .m_udp_ip_fragment_offset(),
    .m_udp_ip_ttl(),
    .m_udp_ip_protocol(),
    .m_udp_ip_header_checksum(),
    .m_udp_ip_source_ip(),
    .m_udp_ip_dest_ip(),
    .m_udp_source_port(),
    .m_udp_dest_port(m_udp_dest_port),
    .m_udp_length(),
    .m_udp_checksum(),
    .m_udp_payload_axis_tdata(xfcp_rx.tdata),
    .m_udp_payload_axis_tkeep(xfcp_rx.tkeep),
    .m_udp_payload_axis_tvalid(m_udp_payload_axis_tvalid),
    .m_udp_payload_axis_tready(xfcp_rx.tready),
    .m_udp_payload_axis_tlast(xfcp_rx.tlast),
    .m_udp_payload_axis_tuser(xfcp_rx.tuser),
    // Status
    .ip_rx_busy(ip_rx_busy),
    .ip_tx_busy(ip_tx_busy),
    .udp_rx_busy(udp_rx_busy),
    .udp_tx_busy(udp_tx_busy),
    .ip_rx_error_header_early_termination(),
    .ip_rx_error_payload_early_termination(),
    .ip_rx_error_invalid_header(),
    .ip_rx_error_invalid_checksum(),
    .ip_tx_error_payload_early_termination(),
    .ip_tx_error_arp_failed(),
    .udp_rx_error_header_early_termination(),
    .udp_rx_error_payload_early_termination(),
    .udp_tx_error_payload_early_termination(),
    // Configuration
    .local_mac(local_mac),
    .local_ip(local_ip),
    .gateway_ip(gateway_ip),
    .subnet_mask(subnet_mask),
    .clear_arp_cache(clear_arp_cache)
);

taxi_axil_if #(
    .DATA_W(C_M_AXI_DATA_WIDTH),
    .ADDR_W(C_M_AXI_ADDR_WIDTH)
) m_axil();

taxi_axis_if xfcp_rx_dwc(), xfcp_tx_dwc();

taxi_axis_adapter rx_width_adapter (
    .clk(logic_clk),
    .rst(logic_rst),

    .s_axis(xfcp_rx),
    .m_axis(xfcp_rx_dwc)
);

taxi_axis_adapter tx_width_adapter (
    .clk(logic_clk),
    .rst(logic_rst),

    .s_axis(xfcp_tx_dwc),
    .m_axis(xfcp_tx)
);

udp_arb_mux # 
(
    .S_COUNT(2),
    .DATA_WIDTH(64),
    .ARB_LSB_HIGH_PRIORITY(0) // xfcp should be priority
) udp_mux_inst (

    .clk(logic_clk),
    .rst(logic_rst),

    .s_udp_hdr_valid({udp_xfcp.hdr_valid, udp_adc.hdr_valid}),
    .s_udp_hdr_ready({udp_xfcp.hdr_ready, udp_adc.hdr_ready}),
    .s_eth_dest_mac(),
    .s_eth_src_mac(),
    .s_eth_type(),
    .s_ip_version(),
    .s_ip_ihl(),
    .s_ip_dscp({udp_xfcp.ip_dscp, udp_adc.ip_dscp}),
    .s_ip_ecn({udp_xfcp.ip_ecn, udp_adc.ip_ecn}),
    .s_ip_length(),
    .s_ip_identification(),
    .s_ip_flags(),
    .s_ip_fragment_offset(),
    .s_ip_ttl({udp_xfcp.ip_ttl, udp_adc.ip_ttl}),
    .s_ip_protocol(),
    .s_ip_header_checksum(),
    .s_ip_source_ip({udp_xfcp.ip_source_ip, udp_adc.ip_source_ip}),
    .s_ip_dest_ip({udp_xfcp.ip_dest_ip, udp_adc.ip_dest_ip}),
    .s_udp_source_port({udp_xfcp.source_port, udp_adc.source_port}),
    .s_udp_dest_port({udp_xfcp.dest_port, udp_adc.dest_port}),
    .s_udp_length(),
    .s_udp_checksum(),
    .s_udp_payload_axis_tdata({xfcp_tx.tdata, s_data_tdata}),
    .s_udp_payload_axis_tkeep({xfcp_tx.tkeep, s_data_tkeep}),
    .s_udp_payload_axis_tvalid({xfcp_mux_tvalid, adc_mux_tvalid}),
    .s_udp_payload_axis_tready({xfcp_mux_tready, adc_mux_tready}),
    .s_udp_payload_axis_tlast({xfcp_tx.tlast, s_data_tlast}),
    .s_udp_payload_axis_tid(),
    .s_udp_payload_axis_tdest(),
    .s_udp_payload_axis_tuser({xfcp_tx.tuser, s_data_tuser}),

    /*
     * UDP frame output
     */
    .m_udp_hdr_valid(udp_tx.hdr_valid),
    .m_udp_hdr_ready(udp_tx.hdr_ready),
    .m_eth_dest_mac(),
    .m_eth_src_mac(),
    .m_eth_type(),
    .m_ip_version(),
    .m_ip_ihl(),
    .m_ip_dscp(udp_tx.ip_dscp),
    .m_ip_ecn(udp_tx.ip_ecn),
    .m_ip_length(),
    .m_ip_identification(),
    .m_ip_flags(),
    .m_ip_fragment_offset(),
    .m_ip_ttl(udp_tx.ip_ttl),
    .m_ip_protocol(),
    .m_ip_header_checksum(),
    .m_ip_source_ip(udp_tx.ip_source_ip),
    .m_ip_dest_ip(udp_tx.ip_dest_ip),
    .m_udp_source_port(udp_tx.source_port),
    .m_udp_dest_port(udp_tx.dest_port),
    .m_udp_length(),
    .m_udp_checksum(),
    .m_udp_payload_axis_tdata(udp_tx_data.tdata),
    .m_udp_payload_axis_tkeep(udp_tx_data.tkeep),
    .m_udp_payload_axis_tvalid(udp_tx_data.tvalid),
    .m_udp_payload_axis_tready(udp_tx_data.tready),
    .m_udp_payload_axis_tlast(udp_tx_data.tlast),
    .m_udp_payload_axis_tid(),
    .m_udp_payload_axis_tdest(),
    .m_udp_payload_axis_tuser()
);

assign xfcp_rx_tvalid = xfcp_rx_dwc.tvalid;
assign xfcp_rx_dwc.tready = xfcp_rx_tready;
assign xfcp_rx_tdata = xfcp_rx_dwc.tdata;
assign xfcp_rx_tlast = xfcp_rx_dwc.tlast;

assign xfcp_tx_dwc.tvalid = xfcp_tx_tvalid;
assign xfcp_tx_tready = xfcp_tx_dwc.tready;
assign xfcp_tx_dwc.tdata = xfcp_tx_tdata;
assign xfcp_tx_dwc.tlast = xfcp_tx_tlast;

assign udp_tx_tdata = udp_tx_data.tdata;
assign udp_tx_tkeep = udp_tx_data.tkeep;
assign udp_tx_tvalid = udp_tx_data.tvalid;
assign udp_tx_tready = udp_tx_data.tready;
assign udp_tx_tlast = udp_tx_data.tlast;

assign udp_rx_tdata = xfcp_rx.tdata;
assign udp_rx_tready = xfcp_rx.tready;
assign udp_rx_tlast = xfcp_rx.tlast;
assign udp_rx_tvalid = m_udp_payload_axis_tvalid;
assign udp_rx_tkeep = xfcp_rx.tkeep;

assign udp_header_valid = m_udp_payload_axis_tvalid;
assign udp_header_dst_port = m_udp_dest_port;

endmodule
