rosalyntg/ultrasound/host/src/si5338.rs

use std::time::Duration;

use tokio::time::sleep;

use crate::{i2c::I2c, xfcp};

const CLK_IN_RATE: u32 = 25_000_000; // Hz

pub struct Si5338 {
    pub i2c: xfcp::I2CNode,
    pub address: u8,
}

impl Si5338 {
    pub async fn rev_id(&self, interface: &mut xfcp::Interface) -> Result<u8, std::io::Error> {
        Ok(self
            .i2c
            .read_at_offset_1b(interface, self.address, 0, 1)
            .await?[0])
    }
    pub async fn device_config(
        &self,
        interface: &mut xfcp::Interface,
    ) -> Result<[u8; 4], std::io::Error> {
        Ok(self
            .i2c
            .read_at_offset_1b(interface, self.address, 0, 4)
            .await?
            .try_into()
            .unwrap())
    }
    pub async fn status(&self, interface: &mut xfcp::Interface) -> Result<u8, std::io::Error> {
        Ok(self
            .i2c
            .read_at_offset_1b(interface, self.address, 218, 1)
            .await?[0])
    }
    pub async fn sticky_status(
        &self,
        interface: &mut xfcp::Interface,
    ) -> Result<u8, std::io::Error> {
        Ok(self
            .i2c
            .read_at_offset_1b(interface, self.address, 247, 1)
            .await?[0])
    }

    /// Read every status-relevant register and format them as a
    /// human-readable multi-line report (see Si5338-RM registers 0-6, 31-34,
    /// 45-49, 218, 226, 230, 235-237, 241, 246, 247).
    pub async fn pretty_status(
        &self,
        interface: &mut xfcp::Interface,
    ) -> Result<String, std::io::Error> {
        let id = self
            .i2c
            .read_at_offset_1b(interface, self.address, 0, 7)
            .await?;
        let drv = self
            .i2c
            .read_at_offset_1b(interface, self.address, 31, 4)
            .await?;
        let fcal_ovrd = self
            .i2c
            .read_at_offset_1b(interface, self.address, 45, 5)
            .await?;
        let status = self.status(interface).await?;
        let ms_reset = self
            .i2c
            .read_at_offset_1b(interface, self.address, 226, 1)
            .await?[0];
        let oeb = self
            .i2c
            .read_at_offset_1b(interface, self.address, 230, 1)
            .await?[0];
        let fcal = self
            .i2c
            .read_at_offset_1b(interface, self.address, 235, 3)
            .await?;
        let dis_lol = self
            .i2c
            .read_at_offset_1b(interface, self.address, 241, 1)
            .await?[0];
        let soft_reset = self
            .i2c
            .read_at_offset_1b(interface, self.address, 246, 1)
            .await?[0];
        let sticky = self.sticky_status(interface).await?;

        // Part number decode per Si5338-RM section 10.6.1
        let rev = match id[0] & 0x07 {
            0 => "A".to_string(),
            1 => "B".to_string(),
            n => format!("? ({n})"),
        };
        let base = id[2] & 0x3F; // "38" for Si5338
        let grade = id[3] >> 3; // 1..=24 -> A..=Z
        let grade = if (1..=24).contains(&grade) {
            char::from(b'A' + grade - 1)
        } else {
            '?'
        };
        let nvm = ((id[3] as u32 & 1) << 16) | ((id[4] as u32) << 8) | id[5] as u32;

        // Registers 218/247/6: D4 PLL_LOL, D3 LOS_FDBK, D2 LOS_CLKIN,
        // D0 SYS_CAL (247 = sticky versions, 6 = interrupt masks)
        let masks = id[6];
        let line = |name: &str, bit: u8, ok: &str, bad: &str| {
            format!(
                "  {name:<16} {:<15} sticky: {:<15} irq: {}\n",
                if status & (1 << bit) != 0 { bad } else { ok },
                if sticky & (1 << bit) != 0 { bad } else { ok },
                if masks & (1 << bit) != 0 {
                    "masked"
                } else {
                    "enabled"
                },
            )
        };

        let mut out = String::new();
        out += &format!("Si53{base:02}{grade} rev {rev}, NVM code {nvm:05}\n");
        out += &format!(
            "alarms: reg 218 = {status:#010b}, sticky reg 247 = {sticky:#010b}, irq mask reg 6 = {masks:#010b}\n"
        );
        out += &line("PLL:", 4, "locked", "LOSS OF LOCK");
        out += &line("feedback clock:", 3, "ok", "LOSS OF SIGNAL");
        out += &line("input clock:", 2, "ok", "LOSS OF SIGNAL");
        out += &line("calibration:", 0, "done", "IN PROGRESS");

        // PLL/reset machinery: reg 49[7] FCAL_OVRD_EN, regs 235-237 measured
        // FCAL vs regs 45-47 override values, reg 241[7] DIS_LOL,
        // reg 246[1] SOFT_RESET, reg 226[2] MS_RESET
        let fcal_meas = ((fcal[2] as u32 & 0x03) << 16) | ((fcal[1] as u32) << 8) | fcal[0] as u32;
        let fcal_over = ((fcal_ovrd[2] as u32 & 0x03) << 16)
            | ((fcal_ovrd[1] as u32) << 8)
            | fcal_ovrd[0] as u32;
        out += &format!(
            "pll: FCAL override {} (measured {fcal_meas:#07x}, override {fcal_over:#07x}), \
             LOL detection {}, soft reset {}, MS reset {}\n",
            if fcal_ovrd[4] & 0x80 != 0 {
                "ON"
            } else {
                "off"
            },
            if dis_lol & 0x80 != 0 {
                "DISABLED"
            } else {
                "enabled"
            },
            if soft_reset & 0x02 != 0 {
                "PENDING"
            } else {
                "idle"
            },
            if ms_reset & 0x04 != 0 {
                "ASSERTED"
            } else {
                "idle"
            },
        );

        // Outputs: reg 230 output-enable bars, regs 31-34 per-output R divider
        // input mux / divide ratio and power-down bits
        out += &format!(
            "outputs: reg 230 = {oeb:#04x}, all-output enable: {}\n",
            if oeb & 0x10 != 0 {
                "DISABLED (OEB_ALL)"
            } else {
                "enabled"
            },
        );
        for i in 0..4 {
            let d = drv[i];
            let mux = match d >> 5 {
                0b000 => "fbclk",
                0b001 => "refclk",
                0b010 => "P2 divider",
                0b011 => "P1 divider",
                0b100 => "xoclk",
                0b101 | 0b110 => "MultiSynth",
                _ => "no clock",
            };
            let rdiv = 1u8 << ((d >> 2) & 0x07).min(5);
            out += &format!(
                "  CLK{i}: {}, driver {}, MultiSynth {}, source {mux} / {rdiv}\n",
                if oeb & (1 << i) != 0 {
                    "DISABLED (OEB)"
                } else {
                    "enabled"
                },
                if d & 0x01 != 0 { "POWERED DOWN" } else { "up" },
                if d & 0x02 != 0 { "POWERED DOWN" } else { "up" },
            );
        }
        Ok(out)
    }

    async fn write_masked(
        &self,
        interface: &mut xfcp::Interface,
        addr: u8,
        val: u8,
        mask: u8,
    ) -> Result<(), std::io::Error> {
        let cur = self
            .i2c
            .read_at_offset_1b(interface, self.address, addr, 1)
            .await?;
        let new_val = (cur[0] & !mask) | (val & mask);
        self.i2c
            .write(interface, self.address, &[addr, new_val])
            .await
    }

    async fn wait_status_clear(
        &self,
        interface: &mut xfcp::Interface,
        mask: u8,
    ) -> Result<(), std::io::Error> {
        for _ in 0..100 {
            if self.status(interface).await? & mask == 0 {
                return Ok(());
            }
            sleep(Duration::from_millis(5)).await;
        }
        Err(std::io::Error::new(
            std::io::ErrorKind::TimedOut,
            format!("si5338: status bits {mask:#04x} did not clear"),
        ))
    }

    // I2C programming procedure from the Si5338 datasheet, Figure 9. Writing
    // the register map alone leaves the PLL/MultiSynths running on the
    // power-up configuration; the soft reset + FCAL copy is what applies it.
    pub async fn init(&self, interface: &mut xfcp::Interface) -> Result<(), std::io::Error> {
        // disable outputs (OEB_ALL = 1) and pause the LOL state machine
        self.write_masked(interface, 230, 0x10, 0x10).await?;
        self.write_masked(interface, 241, 0x80, 0x80).await?;

        for (addr, val, mask) in REG_STORE {
            self.write_masked(interface, *addr, *val, *mask).await?;
        }

        // wait for a valid input clock (LOS_CLKIN clear; LOS_FDBK is ignored
        // since this config uses the crystal with internal feedback)
        self.wait_status_clear(interface, 0x04).await?;

        // lock the PLL to the new config: FCAL_OVRD_EN = 0, then soft reset
        // (plain write of 0x02, no read-modify-write, per the datasheet)
        self.write_masked(interface, 49, 0x00, 0x80).await?;
        self.i2c
            .write(interface, self.address, &[246, 0x02])
            .await?;
        sleep(Duration::from_millis(25)).await;

        // restart LOL
        self.i2c
            .write(interface, self.address, &[241, 0x65])
            .await?;

        // wait for lock: PLL_LOL, LOS_CLKIN and SYS_CAL all clear
        self.wait_status_clear(interface, 0x15).await?;

        // copy the FCAL values the PLL just calibrated into the override
        // registers and use them from now on (FCAL_OVRD_EN = 1)
        let fcal = self
            .i2c
            .read_at_offset_1b(interface, self.address, 235, 3)
            .await?;
        self.i2c
            .write(interface, self.address, &[45, fcal[0]])
            .await?;
        self.i2c
            .write(interface, self.address, &[46, fcal[1]])
            .await?;
        self.i2c
            .write(
                interface,
                self.address,
                &[47, 0b000101 << 2 | (fcal[2] & 0x03)],
            )
            .await?;
        self.write_masked(interface, 49, 0x80, 0x80).await?;

        // enable outputs (OEB_ALL = 0)
        self.write_masked(interface, 230, 0x00, 0x10).await?;

        Ok(())
    }
}
//Register map for use with AN428 (JumpStart)
//https://www.skyworksinc.com/timing
//#BEGIN_HEADER
//Date = Thursday, July 16, 2026 7:53 PM
//File version = 3
//Software Name = ClockBuilder Pro
//Software version = 4.18.0.0
//Software date = 3 23, 2026
//Chip = Si533x
//Part Number = Si533x
//#END_HEADER
//Input Frequency (MHz) = 25.000000000
//Input Type = Crystal
//P1 = 1
//Input Mux = XoClk
//FDBK Input Frequency (MHz) = 25.000000000
//FDBK Input Type = OFF
//P2 = 1
//FDBK Mux = NoClk
//PFD Input Frequency (MHz) = 25.000000000
//VCO Frequency (GHz) = 2.500000
//N = 100  (100.0000)
//Internal feedback enabled
//Output Clock 0
// Output Frequency (MHz) = 50.000000000
// Mux Selection = IDn
// MultiSynth = 50  (50.0000)
// R = 1
//Output Clock 1
// Output Frequency (MHz) = 100.000000000
// Mux Selection = IDn
// MultiSynth = 25  (25.0000)
// R = 1
//Output Clock 2
// Output Frequency (MHz) = 50.000000000
// Mux Selection = IDn
// MultiSynth = 50  (50.0000)
// R = 1
//Output Clock 3
// Output Frequency (MHz) = 50.000000000
// Mux Selection = IDn
// MultiSynth = 50  (50.0000)
// R = 1
//Driver 0
// Enabled
// Powered on
// Output voltage = 3.30
// Output type = 3.3V LVDS
// Output state when disabled = StopLow
//Driver 1
// Enabled
// Powered on
// Output voltage = 3.30
// Output type = 3.3V LVDS
// Output state when disabled = StopLow
//Driver 2
// Enabled
// Powered on
// Output voltage = 3.30
// Output type = 3.3V LVDS
// Output state when disabled = StopLow
//Driver 3
// Enabled
// Powered on
// Output voltage = 3.30
// Output type = 3.3V LVDS
// Output state when disabled = StopLow
//Clock 0 phase inc/dec step size (ns) = 0.000
//Clock 1 phase inc/dec step size (ns) = 0.000
//Clock 2 phase inc/dec step size (ns) = 0.000
//Clock 3 phase inc/dec step size (ns) = 0.000
//Phase increment and decrement pin control is off
//Frequency increment and decrement pin control is off
//Frequency increment and decrement is disabled
//Initial phase offset 0 (ns) = 0.000
//Initial phase offset 1 (ns) = 0.000
//Initial phase offset 2 (ns) = 0.000
//Initial phase offset 3 (ns) = 0.000
//SSC is disabled

// #define NUM_REGS_MAX 350

// typedef struct Reg_Data{
//    unsigned char Reg_Addr;
//    unsigned char Reg_Val;
//    unsigned char Reg_Mask;
// } Reg_Data;

const REG_STORE: &[(u8, u8, u8)] = &[
    (0, 0x00, 0x00),
    (1, 0x00, 0x00),
    (2, 0x00, 0x00),
    (3, 0x00, 0x00),
    (4, 0x00, 0x00),
    (5, 0x00, 0x00),
    (6, 0x08, 0x1D),
    (7, 0x00, 0x00),
    (8, 0x70, 0x00),
    (9, 0x0F, 0x00),
    (10, 0x00, 0x00),
    (11, 0x00, 0x00),
    (12, 0x00, 0x00),
    (13, 0x00, 0x00),
    (14, 0x00, 0x00),
    (15, 0x00, 0x00),
    (16, 0x00, 0x00),
    (17, 0x00, 0x00),
    (18, 0x00, 0x00),
    (19, 0x00, 0x00),
    (20, 0x00, 0x00),
    (21, 0x00, 0x00),
    (22, 0x00, 0x00),
    (23, 0x00, 0x00),
    (24, 0x00, 0x00),
    (25, 0x00, 0x00),
    (26, 0x00, 0x00),
    (27, 0x70, 0x80),
    (28, 0x16, 0xFF),
    (29, 0x90, 0xFF),
    (30, 0xB0, 0xFF),
    (31, 0xC0, 0xFF),
    (32, 0xC0, 0xFF),
    (33, 0xC0, 0xFF),
    (34, 0xC0, 0xFF),
    (35, 0x00, 0xFF),
    (36, 0x06, 0x1F),
    (37, 0x06, 0x1F),
    (38, 0x06, 0x1F),
    (39, 0x06, 0x1F),
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
    (255, 1, 0xFF), // set page bit to 1
    (0, 0x00, 0x00),
    (1, 0x00, 0x00),
    (2, 0x00, 0x00),
    (3, 0x00, 0x00),
    (4, 0x00, 0x00),
    (5, 0x00, 0x00),
    (6, 0x00, 0x00),
    (7, 0x00, 0x00),
    (8, 0x00, 0x00),
    (9, 0x00, 0x00),
    (10, 0x00, 0x00),
    (11, 0x00, 0x00),
    (12, 0x00, 0x00),
    (13, 0x00, 0x00),
    (14, 0x00, 0x00),
    (15, 0x00, 0x00),
    (16, 0x00, 0x00),
    (17, 0x01, 0x00),
    (18, 0x00, 0x00),
    (19, 0x00, 0x00),
    (20, 0x90, 0x00),
    (21, 0x31, 0x00),
    (22, 0x00, 0x00),
    (23, 0x00, 0x00),
    (24, 0x01, 0x00),
    (25, 0x00, 0x00),
    (26, 0x00, 0x00),
    (27, 0x00, 0x00),
    (28, 0x00, 0x00),
    (29, 0x00, 0x00),
    (30, 0x00, 0x00),
    (31, 0x00, 0xFF),
    (32, 0x00, 0xFF),
    (33, 0x01, 0xFF),
    (34, 0x00, 0xFF),
    (35, 0x00, 0xFF),
    (36, 0x90, 0xFF),
    (37, 0x31, 0xFF),
    (38, 0x00, 0xFF),
    (39, 0x00, 0xFF),
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
]; // set page bit to 0
//End of file
