rosalyntg/ultrasound/fpga/ListenToJESD/jesd204b_rx_ip/src/lmfc.sv

// Copyright 2025 ETH Zurich
// Copyright and related rights are licensed under the Solderpad Hardware
// License, Version 0.51 (the "License"); you may not use this file except in
// compliance with the License.  You may obtain a copy of the License at
// http://solderpad.org/licenses/SHL-0.51. Unless required by applicable law
// or agreed to in writing, software, hardware and materials distributed under
// this License is distributed on an "AS IS" BASIS, WITHOUT WARRANTIES OR
// CONDITIONS OF ANY KIND, either express or implied. See the License for the
// specific language governing permissions and limitations under the License.
//
// Authors:
// Soumyo Bhattacharjee  <sbhattacharj@student.ethz.ch>
//------------------------------------------------------------------------------
// Description:
//   Local Multi-Frame Clock (LMFC) Generator for JESD204B.
//   Tracks SYSREF signal to align internal frame counters to LMFC boundaries.
//   Generates LMFC clock pulse and an 8-bit counter for frame alignment.
//
// Parameters:
//   PARALLEL_OCTETS        - Number of octets processed in parallel.
//   BEATS_PER_MULTIFRAME   - Number of beats per multiframe (Octets Per Multiframe / Octets Processed in Parallel) .
//
// Ports:
//   clk_i               - Clock input.
//   rst_ni              - Active-low synchronous reset.
//   sysref_i            - SYSREF pulse input.
//   lmfc_clk_o          - LMFC pulse output.
//   lmfc_counter_o      - LMFC counter output (0 to BEATS_PER_MULTIFRAME-1).
//------------------------------------------------------------------------------

module lmfc #(
  parameter int PARALLEL_OCTETS = 4,
  parameter int BEATS_PER_MULTIFRAME = 64
) (
  input  logic clk_i,
  input  logic rst_ni,
  input  logic sysref_i,

  output logic lmfc_clk_o,
  output logic [7:0] lmfc_counter_o
);

  // Internal Signals
  // logic sysref_capture;
  // logic sysref_pulse;
  // logic sysref_detected;
  logic       lmfc_clk;

  logic [7:0] lmfc_counter_q;
  logic       lmfc_active_q;

  logic [7:0] lmfc_counter_d;
  logic lmfc_active_d;

  // Synchronize SYSREF pulse into clk_i domain
  // double_flop_sync #(
  //   .WIDTH(1)
  // ) i_sysref_sync (
  //   .clk_i    (clk_i),
  //   .rst_ni   (rst_ni),
  //   .signal_i (sysref_i),
  //   .signal_o (sysref_capture)
  // );

  // // Detect rising edge of SYSREF
  // edge_detector i_sysref_edge (
  //   .clk_i           (clk_i),
  //   .rst_ni          (rst_ni),
  //   .signal_i        (sysref_capture),
  //   .posedge_pulse_o (sysref_pulse),
  //   .negedge_pulse_o ()
  // );

  // // SYSREF seen
  // always_ff @(posedge clk_i) begin
  //   if (!rst_ni) begin
  //     sysref_detected <= 1'b0;
  //   end else if (sysref_pulse) begin
  //     sysref_detected <= 1'b1;
  //   end
  // end

  // LMFC Next State Logic
  always_comb begin
    lmfc_counter_d = lmfc_counter_q;
    lmfc_active_d  = lmfc_active_q;

    // if (sysref_pulse && !sysref_detected) begin
    //   lmfc_counter_d = 8'd0;
      lmfc_active_d  = 1'b1;
    // end else 
    if (lmfc_counter_q == (BEATS_PER_MULTIFRAME - 1)) begin
      lmfc_counter_d = 8'd0;
    end else begin
      lmfc_counter_d = lmfc_counter_q + 1;
    end
  end

  // LMFC State Update Logic
  always_ff @(posedge clk_i) begin
    if (!rst_ni) begin
      lmfc_counter_q <= 8'd0;
      lmfc_active_q  <= 1'b0;
    end else begin
      lmfc_counter_q <= lmfc_counter_d;
      lmfc_active_q  <= lmfc_active_d;
    end
  end

  // LMFC Clock Pulse Generation
  always_ff @(posedge clk_i) begin
    if (!rst_ni) begin
      lmfc_clk <= 1'b0;
    end else if (lmfc_active_q) begin
      lmfc_clk <= (lmfc_counter_q == 0);
    end
  end

  // Outputs
  assign lmfc_clk_o     = lmfc_clk;
  assign lmfc_counter_o = lmfc_counter_q;

endmodule
