rosalyntg/ultrasound/fpga/us/us.srcs/sources_1/new/pulse_gen_wrapper.v

`timescale 1ns / 1ps
//////////////////////////////////////////////////////////////////////////////////
// Company: 
// Engineer: 
// 
// Create Date: 07/07/2026 08:35:52 AM
// Design Name: 
// Module Name: pulse_gen_wrapper
// Project Name: 
// Target Devices: 
// Tool Versions: 
// Description: 
// 
// Dependencies: 
// 
// Revision:
// Revision 0.01 - File Created
// Additional Comments:
// 
//////////////////////////////////////////////////////////////////////////////////


module pulse_gen_wrapper # (
    parameter integer C_S_AXI_DATA_WIDTH	= 32,
    parameter integer C_S_AXI_ADDR_WIDTH	= 14
) (
    input wire aclk,
    input wire aresetn,

    output wire [7:0] pulser_neg,
    output wire [7:0] pulser_pos,
    output wire pulser_oen,
    
	output wire sol_pulse,
	output wire eol_pulse,
	output wire sof_pulse,

    (* X_INTERFACE_PARAMETER = "POLARITY ACTIVE_HIGH" *)
    output wire ramp_rst,

    // Ports of Axi Slave Bus Interface S_AXI
    input wire [C_S_AXI_ADDR_WIDTH-1 : 0] S_AXI_AWADDR,
    input wire [2 : 0] S_AXI_AWPROT,
    input wire  S_AXI_AWVALID,
    output wire  S_AXI_AWREADY,
    input wire [C_S_AXI_DATA_WIDTH-1 : 0] S_AXI_WDATA,
    input wire [(C_S_AXI_DATA_WIDTH/8)-1 : 0] S_AXI_WSTRB,
    input wire  S_AXI_WVALID,
    output wire  S_AXI_WREADY,
    output wire [1 : 0] S_AXI_BRESP,
    output wire  S_AXI_BVALID,
    input wire  S_AXI_BREADY,
    input wire [C_S_AXI_ADDR_WIDTH-1 : 0] S_AXI_ARADDR,
    input wire [2 : 0] S_AXI_ARPROT,
    input wire  S_AXI_ARVALID,
    output wire  S_AXI_ARREADY,
    output wire [C_S_AXI_DATA_WIDTH-1 : 0] S_AXI_RDATA,
    output wire [1 : 0] S_AXI_RRESP,
    output wire  S_AXI_RVALID,
    input wire  S_AXI_RREADY
    );

pulse_gen #(
    .C_S_AXI_DATA_WIDTH(C_S_AXI_DATA_WIDTH),
    .C_S_AXI_ADDR_WIDTH(C_S_AXI_ADDR_WIDTH)
) pulse_gen_inst (
    .aclk(aclk),
    .aresetn(aresetn),
    .pulser_neg(pulser_neg),
    .pulser_pos(pulser_pos),
    .pulser_oen(pulser_oen),
    .sol_pulse(sol_pulse),
    .eol_pulse(eol_pulse),
    .sof_pulse(sof_pulse),
    .ramp_rst(ramp_rst),
    .S_AXI_AWADDR(S_AXI_AWADDR),
    .S_AXI_AWPROT(S_AXI_AWPROT),
    .S_AXI_AWVALID(S_AXI_AWVALID),
    .S_AXI_AWREADY(S_AXI_AWREADY),
    .S_AXI_WDATA(S_AXI_WDATA),
    .S_AXI_WSTRB(S_AXI_WSTRB),
    .S_AXI_WVALID(S_AXI_WVALID),
    .S_AXI_WREADY(S_AXI_WREADY),
    .S_AXI_BRESP(S_AXI_BRESP),
    .S_AXI_BVALID(S_AXI_BVALID),
    .S_AXI_BREADY(S_AXI_BREADY),
    .S_AXI_ARADDR(S_AXI_ARADDR),
    .S_AXI_ARPROT(S_AXI_ARPROT),
    .S_AXI_ARVALID(S_AXI_ARVALID),
    .S_AXI_ARREADY(S_AXI_ARREADY),
    .S_AXI_RDATA(S_AXI_RDATA),
    .S_AXI_RRESP(S_AXI_RRESP),
    .S_AXI_RVALID(S_AXI_RVALID),
    .S_AXI_RREADY(S_AXI_RREADY)
);


endmodule
