rosalyntg/ultrasound/(commit log)

2026-07-07 xfcp switch is working
2026-07-13 eth is not working without cutouts, jesd204b getting closer
    [i2c_pinswap.v, net.sv, net_wrapper.v, pins.xdc, pulse_gen.sv, pulse_gen_wrapper.v, tb_pulse_gen.sv, us_top.sv]
2026-07-14 put reset inside ad34jx
    [ad34jx.rs, net.rs]
2026-07-15 fix STUPID DATASHEET ERRATA
    [ad34jx.rs, net.rs]
2026-07-15 fix wedged ETH when both try to send at the same time
    [net.sv, tb_udp_hdr_valid_gen.sv, udp_hdr_valid_gen.sv]
2026-07-17 50Mhz ADC!
2026-07-17 fixes for new HV+ voltage divider
    [hvsupply.rs, mcp401x.rs, net.rs, ultrasound.rs]
2026-07-17 get/set target voltage
2026-07-17 wire up hv-
2026-08-16 add notch filter
2026-08-20 increase udp recvbuf size, fix header format
    [main.rs, pulser.rs]
2026-08-20 scope thread
2026-08-20 correct packet lengths, use packet length to determite if header is present
    [jesd_to_axi4s.v]
2026-09-04 lots of work on stats and calibration
2026-09-27 fix calibration data, move into host/
    [array_20260903_223545.csv, array_20260903_223621.csv, array_20260903_223703.csv, array_20260903_223741.csv, array_20260903_223829.csv, array_20260903_223841.csv, array_20260903_223912.csv, array_20260904_010523.csv]
2026-09-27 move into fpga subdir
    [synth_1.csv]
2026-09-27 add datasheets
    [ACAU15_IO_Length.xls]
2026-09-27 move into fpga/us
    [synth_1.csv]
2026-09-27 add ultrasound PCB
    [ACAU15_IO_Length.xls, adc.kicad_sch, adc_ac_coupling.kicad_sch, clk.kicad_sch, fpga.kicad_sch, gain_dac.kicad_sch, mech.kicad_sch, power.kicad_sch]
2026-09-27 add power board
    [hvminus.kicad_sch, hvplus.kicad_sch, lv_regs.kicad_sch, power-board.kicad_pcb, power-board.kicad_sch]
2026-09-27 add probe board
    [probe.kicad_pcb, probe.kicad_sch]
